rEDTii/EATWHAT/README.md

# EATWHAT

**基于 FreeRTOS 的嵌入式多媒体音频系统设计**

**Audio-player based on FM33FK5410 MCU &amp; FreeRTOS**

“复微杯”全国大学生电子设计大赛全国总决赛参赛作品

| 类别 | 描述 |
| :--- | :--- |
| **MCU** | 复旦微电子 FM33FK5410 (ARM Cortex-M33) |
| **RTOS** | FreeRTOS |
| **外设** | 3.5英寸电容触摸屏、双声道 I2S 麦克风/功放、SD 卡等 |
| **开发环境** | Keil uVision 5 |

## 项目源码相关目录：
 - *Driver*：包含有项目中所开发/移植的硬件底层驱动；
 - *Inc*：项目所包含的.h头文件；
 - *Middlewares*：涉及到中间件的移植和驱动适配；
 - *Src*：包含所有.c源文件，主要实现业务功能逻辑。

## 总决赛项目答辩相关材料：
 - *软硬件赛道硬件命题-晚饭吃什么-王政.pdf*：总决赛答辩演示文稿
 - *软硬件赛道硬件命题-晚饭吃什么-王政.mp4*：总决赛现场演示视频

## 项目介绍

项目来自“复微杯”2025全国大学生电子设计大赛选题 - 基于FM33XX系列MCU的多媒体音频终端系统，旨在为复旦微电子集团的全新 MCU 型号探索应用场景与实现方案。




图中硬件标注：①电容触摸LCD屏，集成显示+触摸检测；②功放模块；③扬声器；④麦克风模块；⑤SD卡存储模块；⑥外部flash存储模块；⑦RTC供电纽扣电池；⑧系统供电。当系统掉电时，将切换为使用纽扣电池为RTC时钟供电，以维持时钟走时。

### 核心功能

- **高保真音频处理**：支持 24-bit 采样深度，自适应采样率（8kHz - 32kHz），WAV 格式高保真录制与播放；
- **图形化交互系统**：基于 μGUI 移植优化的交互界面，支持电容触摸屏操作；
- **智能终端应用**：集成实时时钟、多功能闹钟、文件资源管理等终端功能；
- **大容量存储**：支持 SD 卡（FATFS 文件系统）与外部 Flash 存储，实现音频数据的高效持久化。

### 项目主要亮点

### 1. 高带宽音频流乒乓处理机制
SPI DMA + I2S DMA 的双 DMA + 双缓冲乒乓结构协作配合实现音频数据流的高效存取，支撑双声道多采样率 24-bit WAV 高清音频的录制/播放；SPI DMA 基于信号量实现，降低了CPU 占用，提高任务调度的实时性；




### 2. 自适应限幅滤波算法
基于前值保持的变化率约束的动态限幅，有效抑制突发瞬态噪声的同时保证了实时性，对缓解扬声器爆破音问题具有显著效果；



### 3. 任务调度与轻量级同步互斥设计
- 基于任务通知机制和中断实现触摸模块，通过任务通知值奇偶性判决触摸动作，实现高响应、低功耗的中断式触摸驱动；
- 针对录制/播放与突发闹钟之间的硬件资源竞态问题，设计了相应的业务切换逻辑，保证了文件完整性与系统实时稳定运行；

### 4. 文件管理与 GUI 显示优化
- 在 FATFS 的基础上引入动态链表机制，实时监听文件系统事件并同步文件变化，实现文件高效管理；
- 二次开发 μGUI 图形库，包括显示驱动优化、组件功能拓展、字库访问优化等，保证高效渲染与节省资源的同时提升用户友好性。

---
*Developed by Mason Wang, Pam Pan, and GaoPeng Cai from SCUT.*
