rEDTii/EATWHAT/软硬件赛道硬件命题-晚饭吃什么-王政.pdf

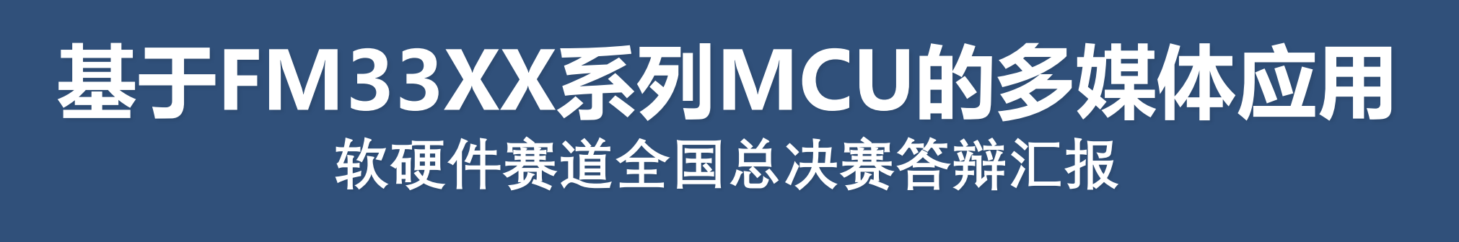
[picture p1: figure]
基于FM33XX系列MCU的多媒体应用; 软硬件赛道全国总决赛答辩汇报

2025.8.16

队伍名称： 晚饭吃什么
学校： 华南理工大学
队员： 王政 潘武豪 蔡高鹏

1 | 团队介绍 | 2 | 方案概述
3 | 关键技术实现 | 4 | 系统测试
5 | 总结与展望

# 01 团队介绍

### Part

## 团队介绍

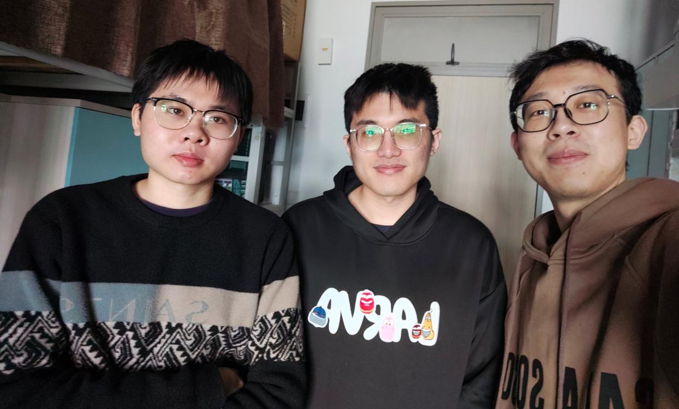
[picture p2: figure]

- 晚饭吃什么，来自华南理工大学电子与信息学院。所设计项目核心是基于FM33FK5410 MCU的多 媒体音频终端系统，实现高效音频处理与交互。
- 其中队长王政负责操作系统开发、驱动开发和功能开发；队员潘武豪负责文件管理、GUI开发和 功能开发；队员蔡高鹏负责PCB设计与硬件平台搭建。

图1-1 队伍合影，从左到右依次为：蔡高鹏，潘武豪，王政

# 02 方案概述

### Part

## 系统功能

- GUI交互

→ 支持触摸菜单控制与状态显示；

- WAV音频存取

→ 支持双声道多采样率24位量化位数的
WAV格式音频的录制、播放及过程暂停；
- SD卡存储

→ 音频文件通过FATFS文件系统存储在SD
卡，提供跨平台兼容性与可移动性；
- 时钟功能

→ 带软件合法性判断的日期/时间设置与动态显示；

- 闹钟功能

→ 支持用户自设闹钟与任务打断提醒；

- 辅助功能

→ 支持音量调节、亮度调节等辅助功能配置。

所设计的基于FM33FK5410 MCU的应用终端系统实现功能概括如下：

## 功能与模块架构

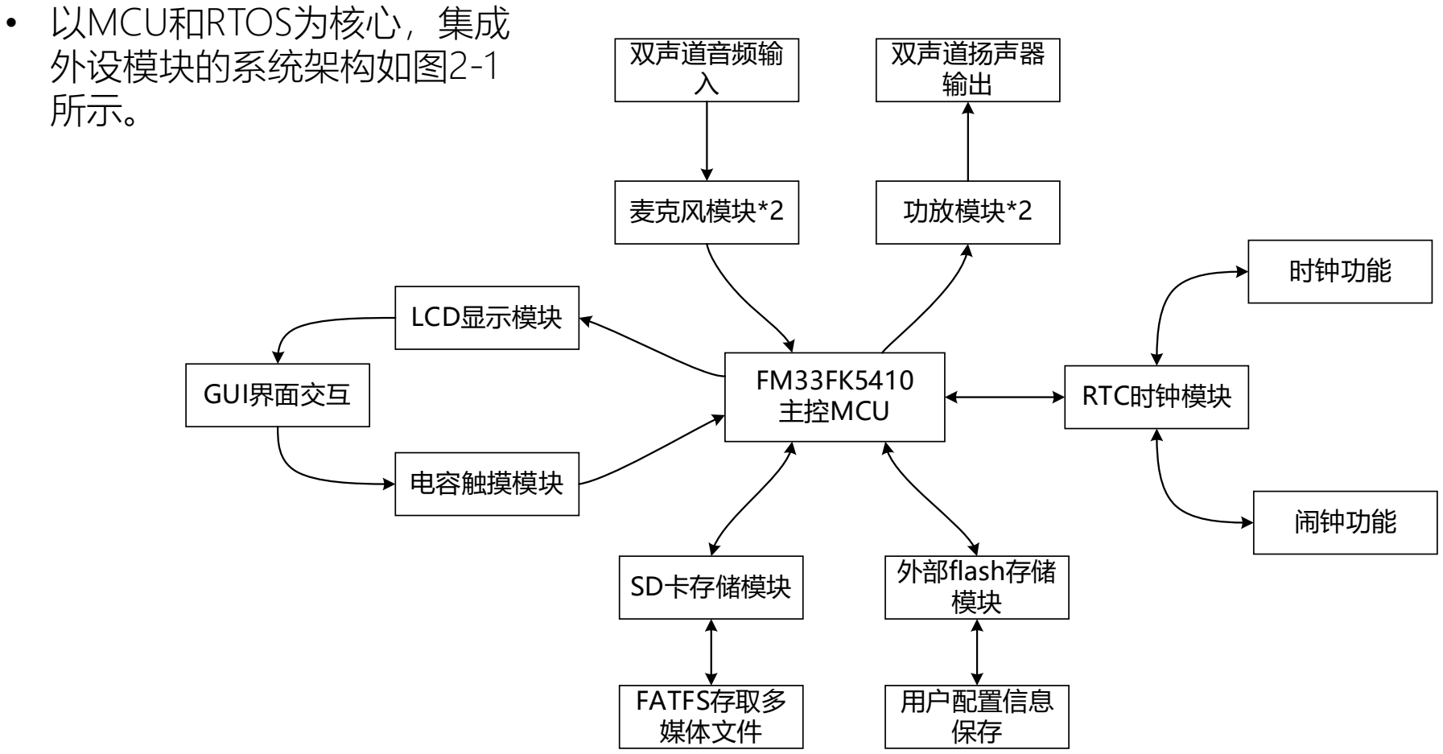
[picture p3: figure]
FM33FK5410 主控MCU; SD卡存储模块; 外部flash存储; FATFS存取多 媒体文件; LCD显示模块; 电容触摸模块; GUI界面交互; 用户配置信息 保存; RTC时钟模块; 时钟功能; 闹钟功能; 功放模块*2; 双声道扬声器 输出; 麦克风模块*2; 双声道音频输 入; • 以MCU和RTOS为核心，集成 外设模块的系统架构如图2-1 所示。

图2-1 系统功能模块架构

## 硬件连接 与实物图

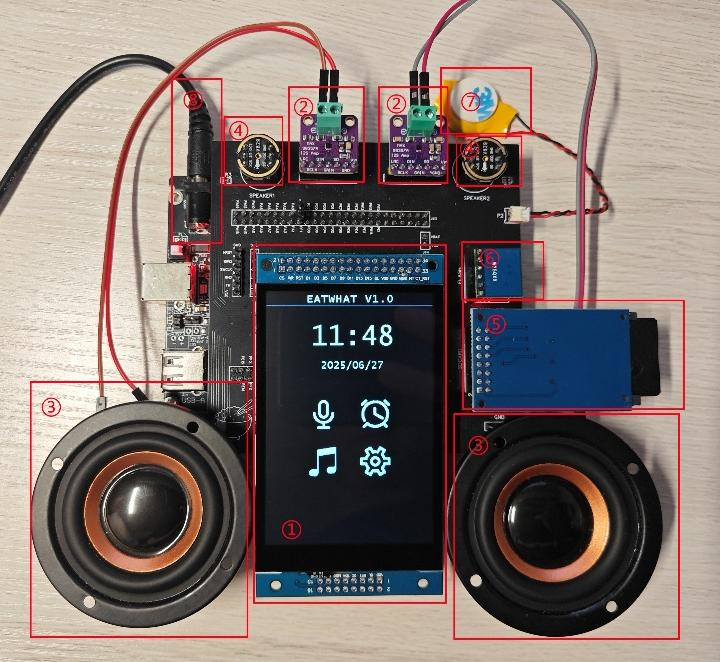
[picture p4: figure]

图2-3 标有各外设模块的实物示意图

FM33FK5410
MCU

外部FLASH

SPI3 | SD卡

SPI2

电源 | VDD
RTC电源 | VBAT
麦克风 | 音频放大器

喇叭

SPI0->I2S | SPI1->I2S
麦克风 | 音频放大器
左声道 | 喇叭 | 右声道

电容触摸显示屏

显示 | 触摸

I2C1

亮度

EPSC | PWM

图2-2 硬件连接图
- 双声道音频链路：
INMP441麦克风 24位I2S输入→ FM33FK5410 → MAX98357 D类功放输出；
- 双协议驱动电容屏：
Intel 8080并口 + I2C触摸 + PWM调光。

①电容触摸LCD屏；②功放；③扬声器；④麦克风；⑤SD卡存储 模块；⑥外部flash存储模块；⑦RTC供电纽扣电池；⑧系统供电

## PCB载板

- PCB设计遵循钝角走线并应用泪滴以增强连接可靠性的准则，降低信号反射；合理设计过孔围栏，抑制电 源噪声，为双DMA音频输入输出与存储模块读写的稳定性提供了硬件支持。PCB边框大小为10cm×10cm， 且设计符合DRC检测。

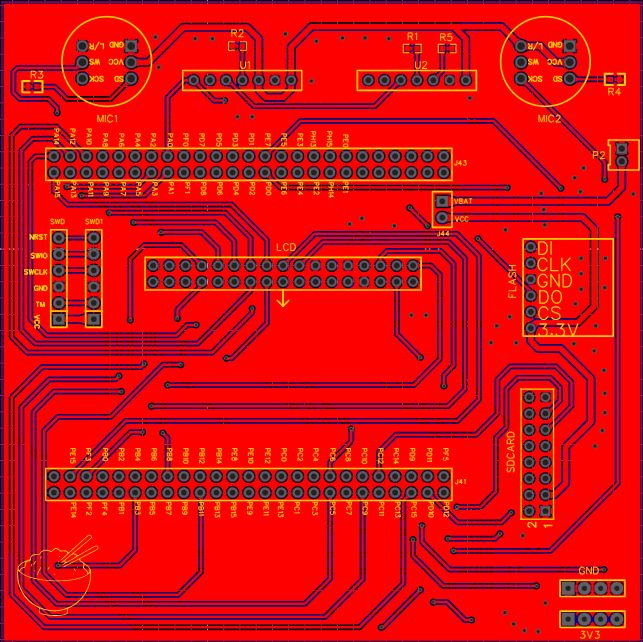
[picture p5: figure]
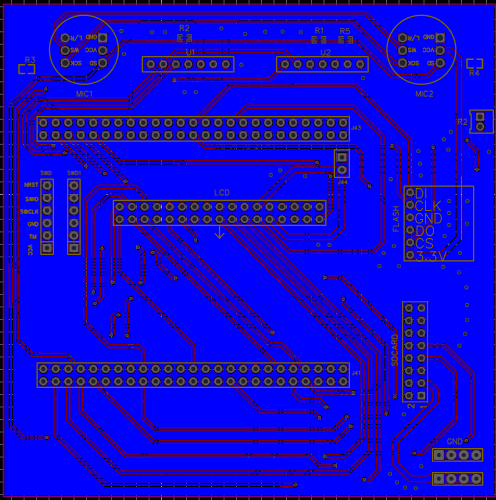
[picture p6: figure]

图2-4 硬件PCB顶层 | 图2-5 硬件PCB底层

## 关键点/创新点

RTOS多任务调度

→ 基于FreeRTOS进行多任务的管理和协调，通过精心配置细粒度任务的优先级设置、资源管 理和任务同步互斥等，实现和保证多任务高效调度、实时响应和稳定执行；

- 文件管理优化

→ 基于链表结构的内部文件管理，与FAT文件系统深度协同，增删管理高效，有利于动态内存 管理和不定长的文件名存储，降低内存碎片化风险；

图形库二次开发与资源优化

→ 对µGUI进行二次开发，针对大面积填充的显示驱动优化，提升渲染速度；对其部分控件进 行功能拓展，提升用户友好性；字库访问优化，保证字体高效渲染同时节省资源。

## 关键点/创新点

基于任务同步的双DMA音频流IO优化

→ SPI DMA+I2S DMA的双DMA+双缓冲乒乓结构协作配合实现音频数据流的高效存取，提

高了传输速率；其中SPI DMA基于信号量实现，降低了CPU占用，提高任务调度的实时性；

- 自适应瞬态抑制音频流滤波

→ 基于前值保持的变化率约束的动态限幅，有效抑制突发瞬态噪声的同时保证了实时性，对 缓解扬声器爆破音问题具有显著效果；

- 基于轻量级任务同步的中断触摸驱动框架

→ 中断+任务处理的触摸模式，提高实时性和稳定性，降低CPU占用；基于任务通知值奇偶 进行触摸动作判决，轻量且安全；

# 03 关键技术实现

### Part

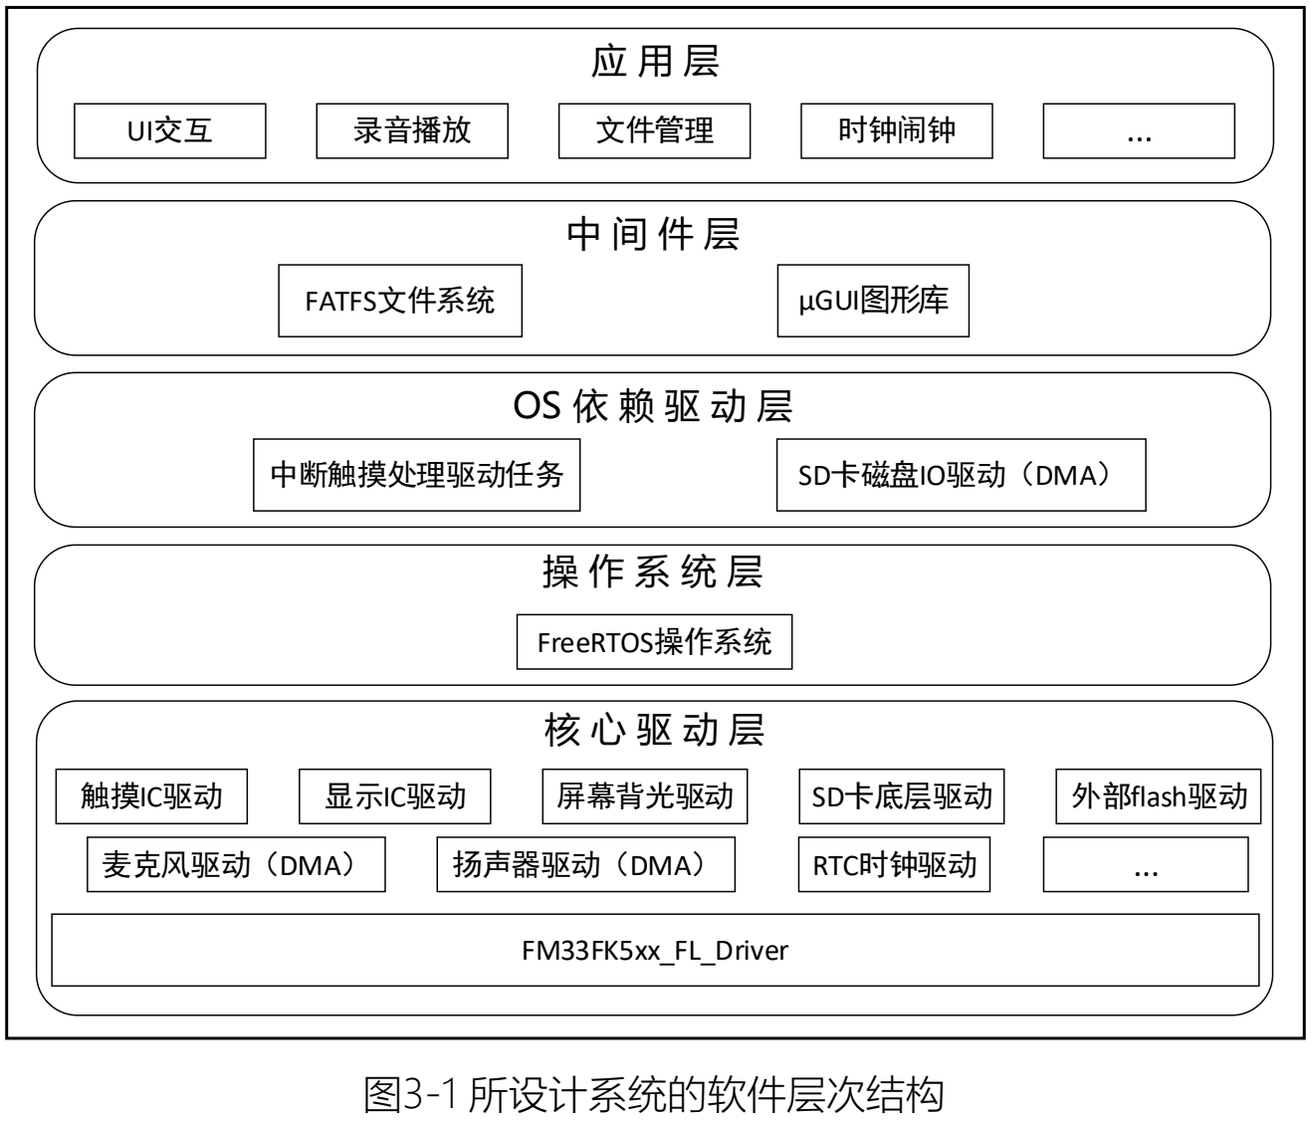
[picture p7: figure]
FATFS文件系统; μGUI图形库; FM33FK5xx_FL_Driver; 触摸IC驱动; 显示IC驱动; 麦克风驱动（DMA）; 扬声器驱动（DMA）; RTC时钟驱动; 屏幕背光驱动; 外部flash驱动; SD卡底层驱动; 中断触摸处理驱动任务; FreeRTOS操作系统; SD卡磁盘IO驱动（DMA）; UI交互; 录音播放; 文件管理; 时钟闹钟; ... 图3-1 所设计系统的软件层次结构

## 软 件 层 次 结 构

- 项目设计遵循低耦合、模块化和
嵌入式软件分层的思想；
- 各层间与各模块间只对外提供操
作接口以及传递任务同步互斥量，
易于维护和拓展。

## OS依赖驱动层-SD卡DMA磁盘IO驱动优化

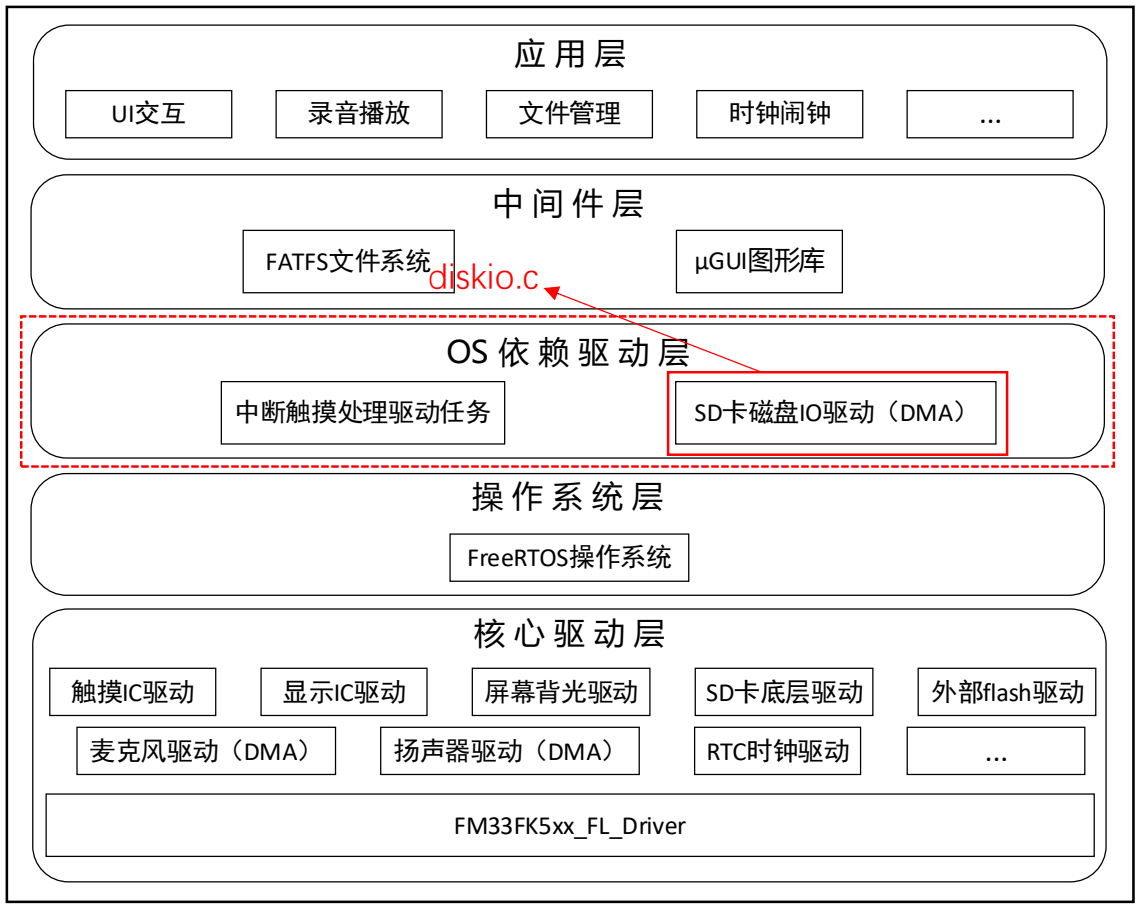
[picture p8: figure]
FATFS文件系统; μGUI图形库; FM33FK5xx_FL_Driver; 触摸IC驱动; 显示IC驱动; 麦克风驱动（DMA）; 扬声器驱动（DMA）; RTC时钟驱动; 屏幕背光驱动; 外部flash驱动; SD卡底层驱动; 中断触摸处理驱动任务; FreeRTOS操作系统; SD卡磁盘IO驱动（DMA）; UI交互; 录音播放; 文件管理; 时钟闹钟; diskio.c

图3-2 SD卡读写驱动优化

问题痛点

- 传统SPI读写SD卡速率难以匹配I2S音频流速率；
- 传统DMA方案的while轮询忙等待抢占CPU资源， 阻塞任务调度；

## OS依赖驱动层-SD卡DMA磁盘IO驱动优化

问题痛点

- 传统SPI读写SD卡速率难以匹配I2S音频流速率；
- 传统DMA方案的while轮询忙等待抢占CPU资源， 阻塞任务调度；

应对方案

- 在硬件上，以SPI DMA传输替代CPU搬运，进一 步构建双缓冲音频传输结构，保障音频流传输；
- 在系统上，采用信号量同步替代DMA忙等待，降
低CPU占用；

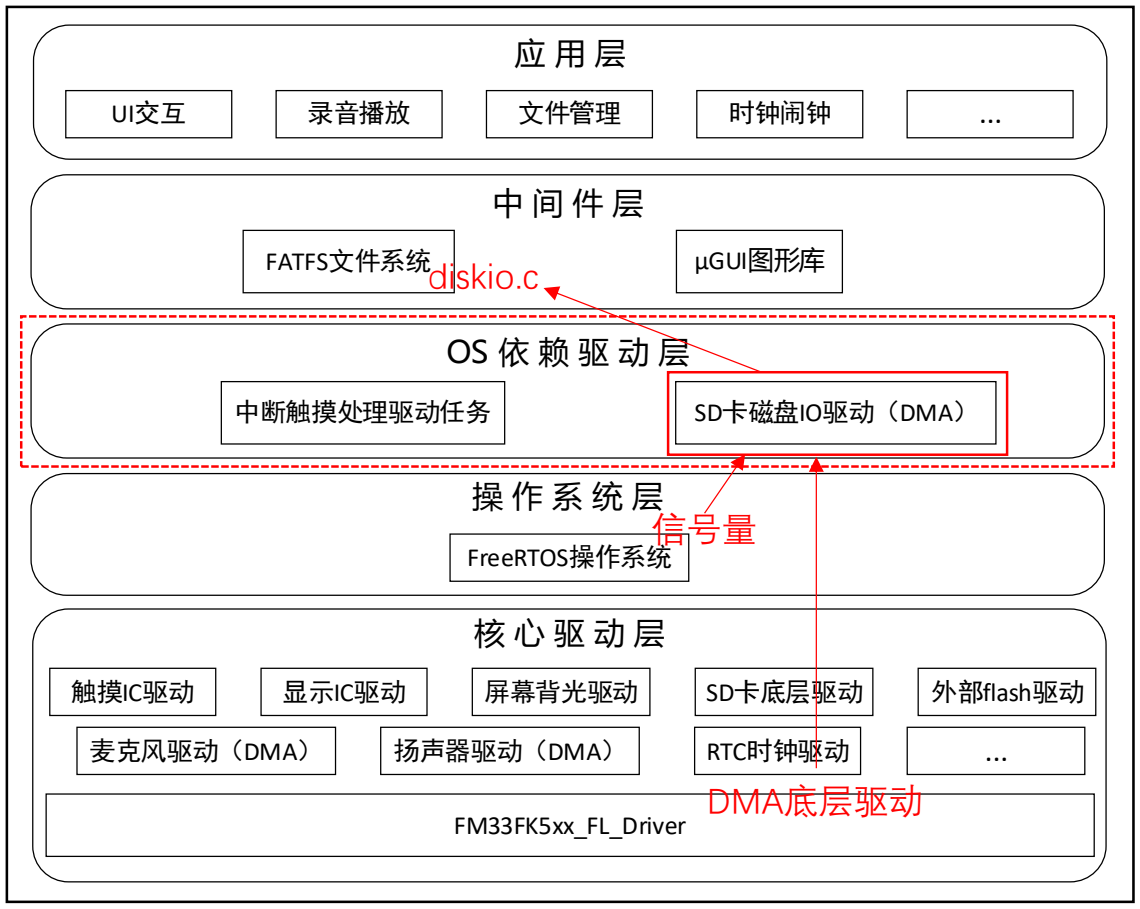
[picture p9: figure]
FATFS文件系统; μGUI图形库; FM33FK5xx_FL_Driver; 触摸IC驱动; 显示IC驱动; 麦克风驱动（DMA）; 扬声器驱动（DMA）; RTC时钟驱动; 屏幕背光驱动; 外部flash驱动; SD卡底层驱动; 中断触摸处理驱动任务; FreeRTOS操作系统; SD卡磁盘IO驱动（DMA）; UI交互; 录音播放; 文件管理; 时钟闹钟; diskio.c; 信号量; DMA底层驱动

图3-2 SD卡读写驱动优化

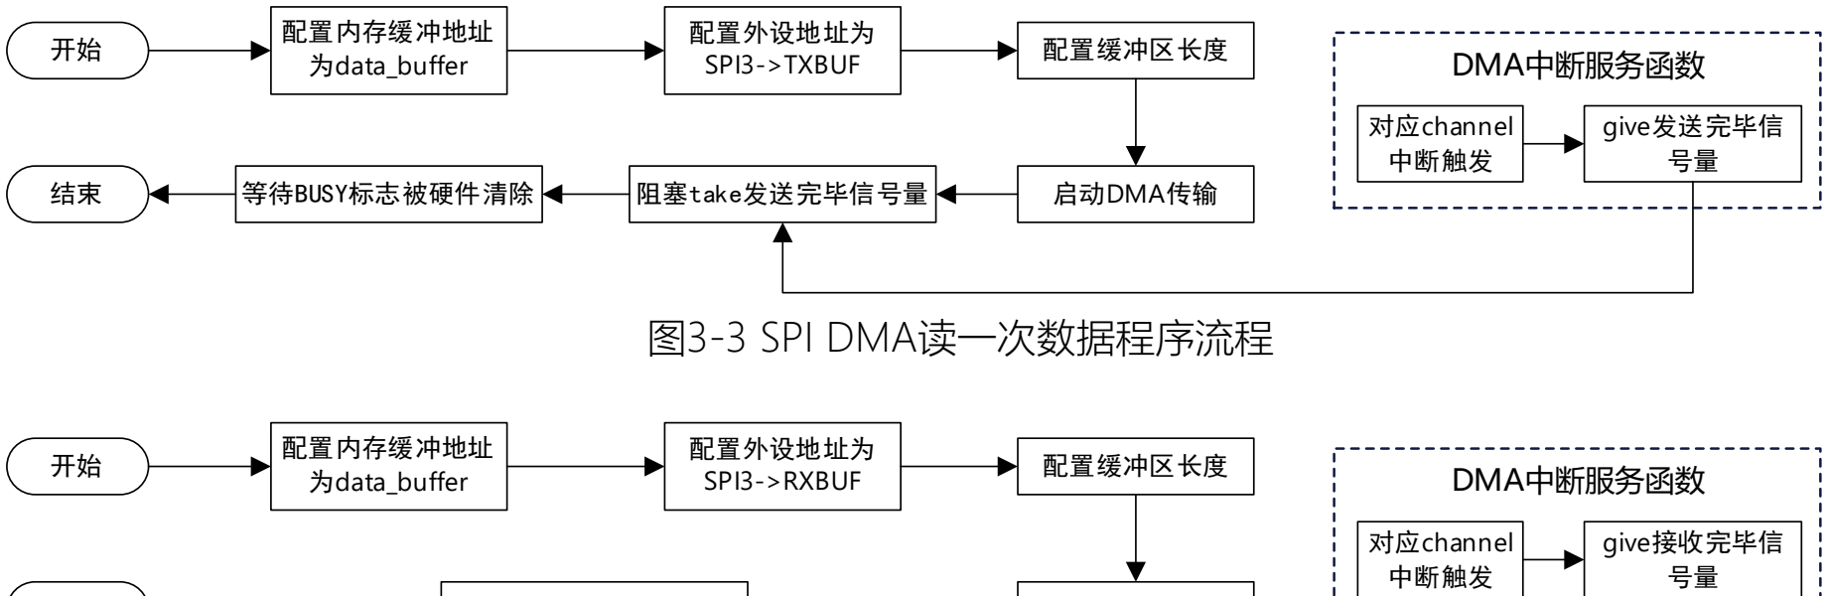
[picture p10: figure]
图3-3 SPI DMA读一次数据程序流程; 配置内存缓冲地址; 为data_buffer; 配置缓冲区长度; 配置外设地址为 SPI3->TXBUF; 等待BUSY标志被硬件清除; 阻塞take发送完毕信号量; 启动DMA传输; 对应channel 中断触发; give发送完毕信 号量; DMA中断服务函数 开始; 配置外设地址为 SPI3->RXBUF; give接收完毕信 号量; DMA中断服务函数
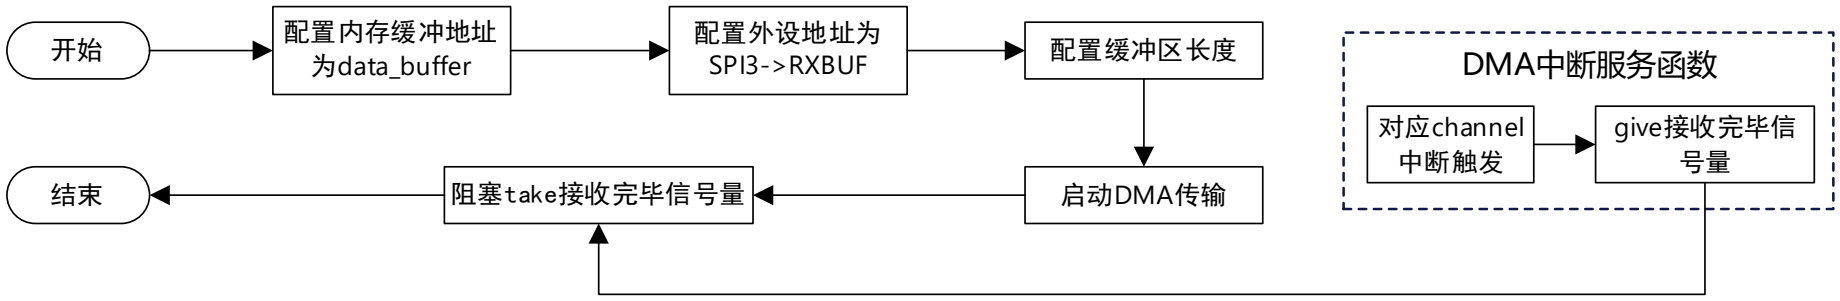
[picture p11: figure]
阻塞take接收完毕信号量; 启动DMA传输

图3-4 SPI DMA写一次数据程序流程

## OS依赖驱动层-SD卡DMA磁盘IO驱动优化

## OS依赖驱动层-SD卡DMA磁盘IO驱动优化

优化前后SPI磁盘IO速率的评估测试实验
- 为了评估我们经过任务同步优化磁盘IO驱动后的文件系统的读写速率提升效果，我们设计了三个评 估实验。

时钟频率 (MHz) | 数据大小 (KB) | 写入次数 | 速率 (KB/s)
8 | 3 | 1 | 45.5
32 | 3 | 1 | 157.9
32 | 3 | 10 | 144.3
32 | 3 | 100 | 144.9
32 | 4.5 | 100 | 154.9
32 | 6 | 100 | 165.2
32 | 7.5 | 100 | 167.4

## OS依赖驱动层-SD卡DMA磁盘IO驱动优化

时钟频率 (MHz) | 数据大小 (KB) | 读取次数 | 速率 (KB/s)
32 | 3 | 1 | 1500.0
32 | 3 | 10 | 1034.5
32 | 3 | 100 | 1010.1

表3-1 不使用DMA的SPI写入

表3-2 DMA优化后的SPI写入

表3-3 DMA优化后的32MHz下3KB缓冲区的SPI读取

时钟频率 (MHz) | 数据大小 (KB) | 写入次数 | 速率 (KB/s)
8 | 3 | 1 | 230.8
32 | 3 | 1 | 600.0
32 | 3 | 10 | 392.8
32 | 3 | 100 | 405.4
32 | 4.5 | 100 | 516.8
32 | 6 | 100 | 630.0
32 | 7.5 | 100 | 669.4

优化前后SPI磁盘IO速率的评估测试实验
- 为了评估我们经过任务同步优化磁盘IO驱动后的文件系统的读写速率提升效果，我们设计了三个评 估实验。

## OS依赖驱动层-SD卡DMA磁盘IO驱动优化

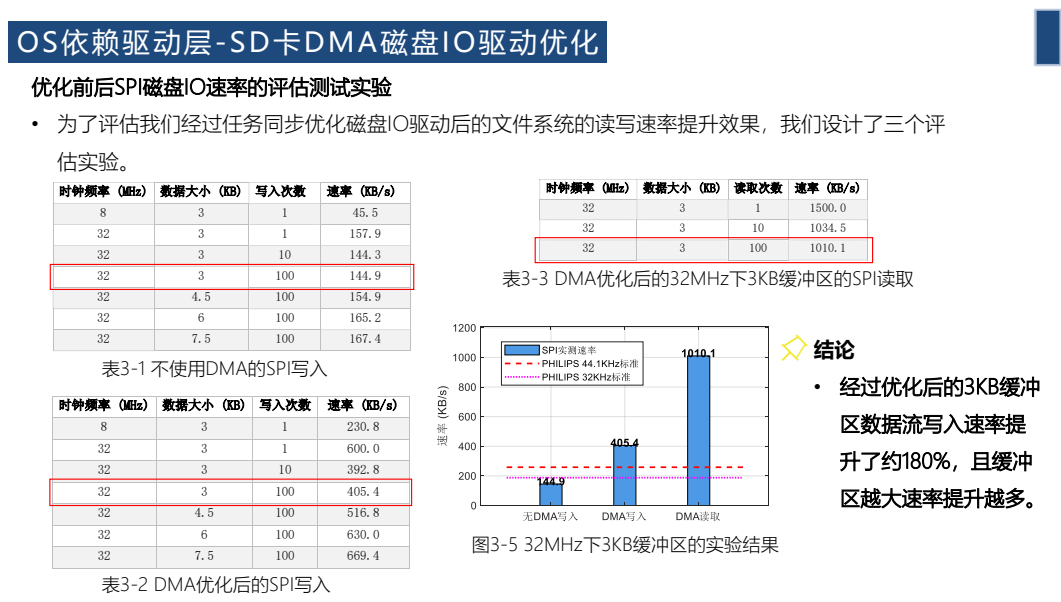
[picture p12: page 19]
时钟频率 (MHz); 数据大小 (KB); 写入次数; 读取次数; 表3-1 不使用DMA的SPI写入; 表3-2 DMA优化后的SPI写入; 表3-3 DMA优化后的32MHz下3KB缓冲区的SPI读取; • 经过优化后的3KB缓冲; 区数据流写入速率提; 升了约180%，且缓冲; 区越大速率提升越多。; 图3-5 32MHz下3KB缓冲区的实验结果; 优化前后SPI磁盘IO速率的评估测试实验; • 为了评估我们经过任务同步优化磁盘IO驱动后的文件系统的读写速率提升效果，我们设计了三个评; 估实验。

8 | 3 | 1 | 45.5
32 | 3 | 1 | 157.9
32 | 3 | 10 | 144.3
32 | 3 | 100 | 144.9
32 | 4.5 | 100 | 154.9
32 | 6 | 100 | 165.2
32 | 7.5 | 100 | 167.4

32 | 3 | 1 | 1500.0
32 | 3 | 10 | 1034.5
32 | 3 | 100 | 1010.1

时钟频率 (MHz) | 数据大小 (KB) | 写入次数 | 速率 (KB/s)

8 | 3 | 1 | 230.8
32 | 3 | 1 | 600.0
32 | 3 | 10 | 392.8
32 | 3 | 100 | 405.4
32 | 4.5 | 100 | 516.8
32 | 6 | 100 | 630.0
32 | 7.5 | 100 | 669.4

## OS依赖驱动层-中断触摸优化驱动

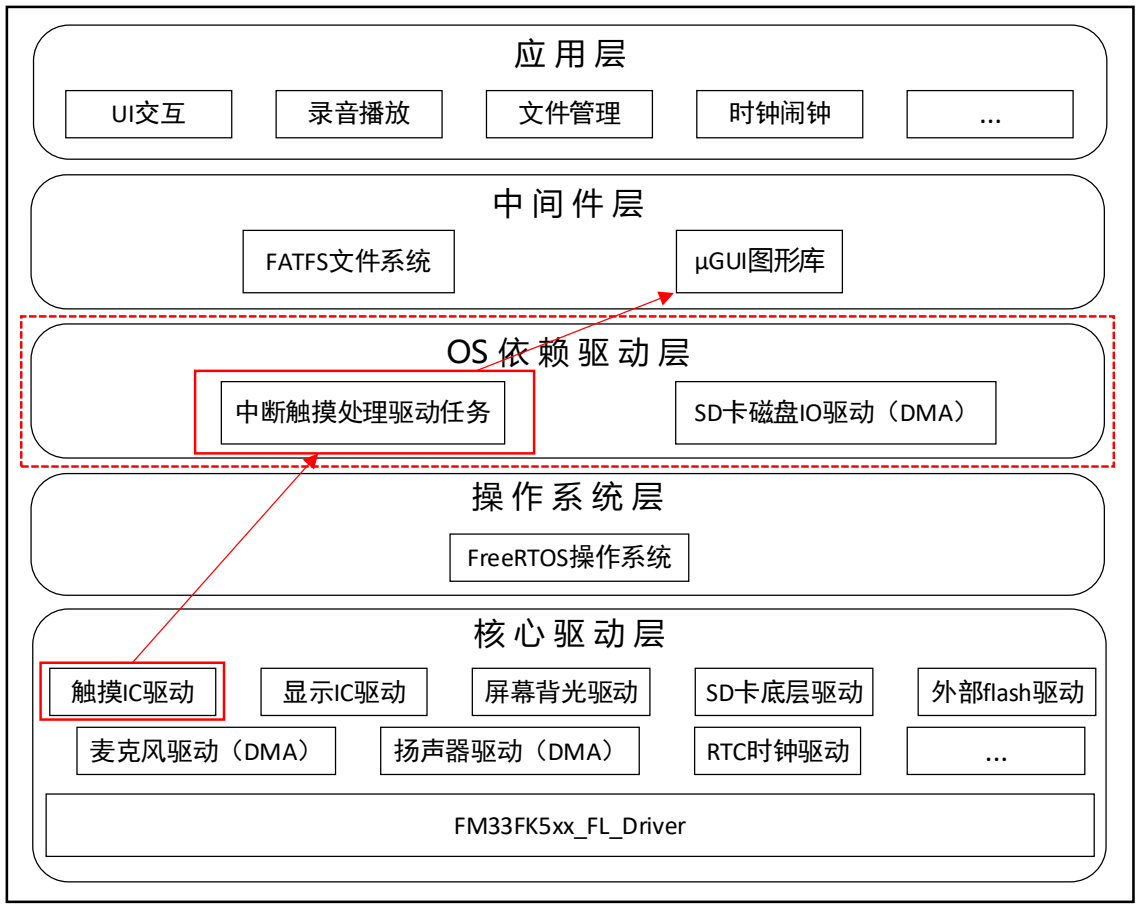
[picture p13: figure]
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

图3-6 中断触摸驱动优化

问题痛点

- 传统轮询模式持续占用CPU资源，实时性差；
- GT911实际中断触发逻辑与数据手册不符；
- 传统中断模式有多任务冲突风险。

## OS依赖驱动层-中断触摸优化驱动

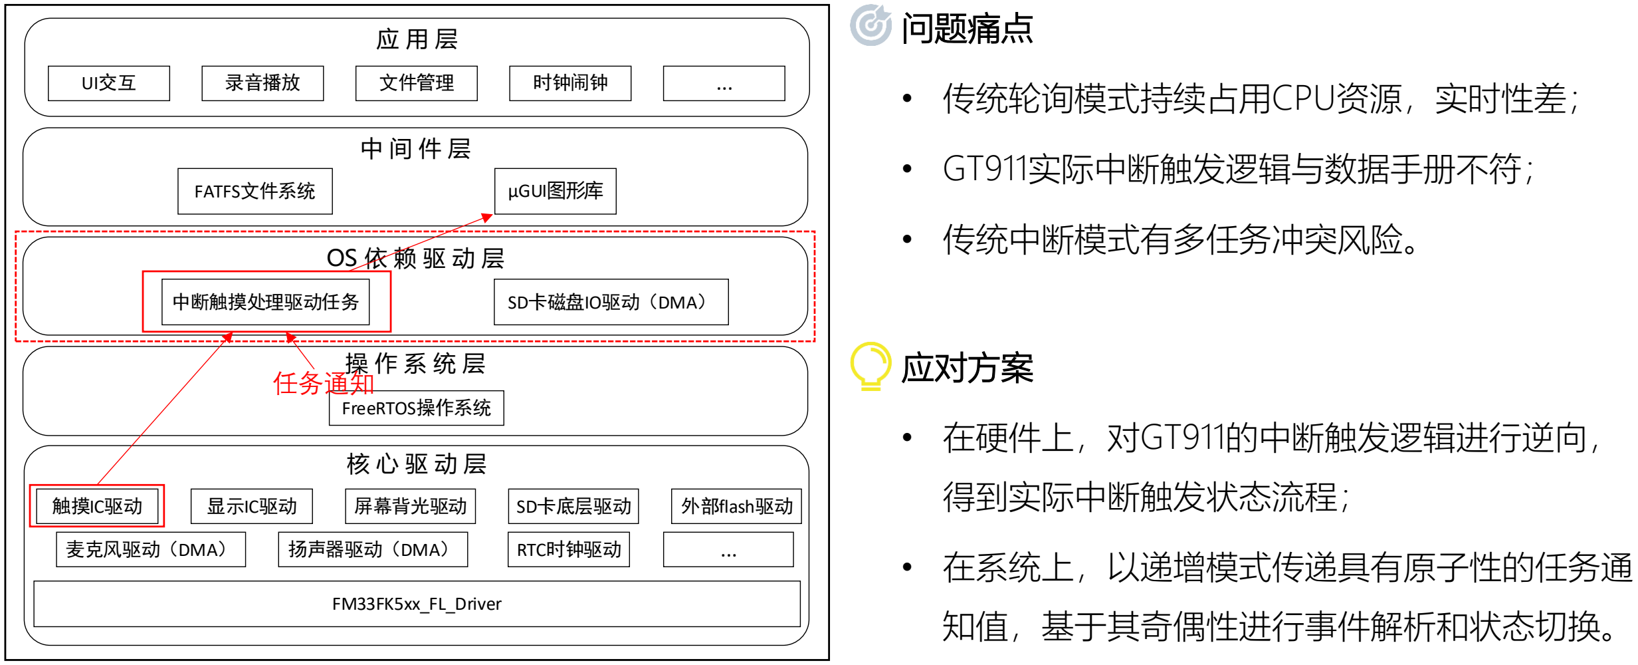
[picture p14: figure]
问题痛点; • 传统轮询模式持续占用CPU资源，实时性差；; • GT911实际中断触发逻辑与数据手册不符；; • 传统中断模式有多任务冲突风险。; FATFS文件系统; μGUI图形库; FM33FK5xx_FL_Driver; 触摸IC驱动; 显示IC驱动; 麦克风驱动（DMA）; 扬声器驱动（DMA）; RTC时钟驱动; 屏幕背光驱动; 外部flash驱动; SD卡底层驱动; 中断触摸处理驱动任务; FreeRTOS操作系统; SD卡磁盘IO驱动（DMA）; UI交互; 录音播放; 文件管理; 时钟闹钟; 任务通知; 应对方案; • 在硬件上，对GT911的中断触发逻辑进行逆向，; 得到实际中断触发状态流程；; • 在系统上，以递增模式传递具有原子性的任务通; 知值，基于其奇偶性进行事件解析和状态切换。

图3-6 中断触摸驱动优化

## OS依赖驱动层-中断触摸优化驱动

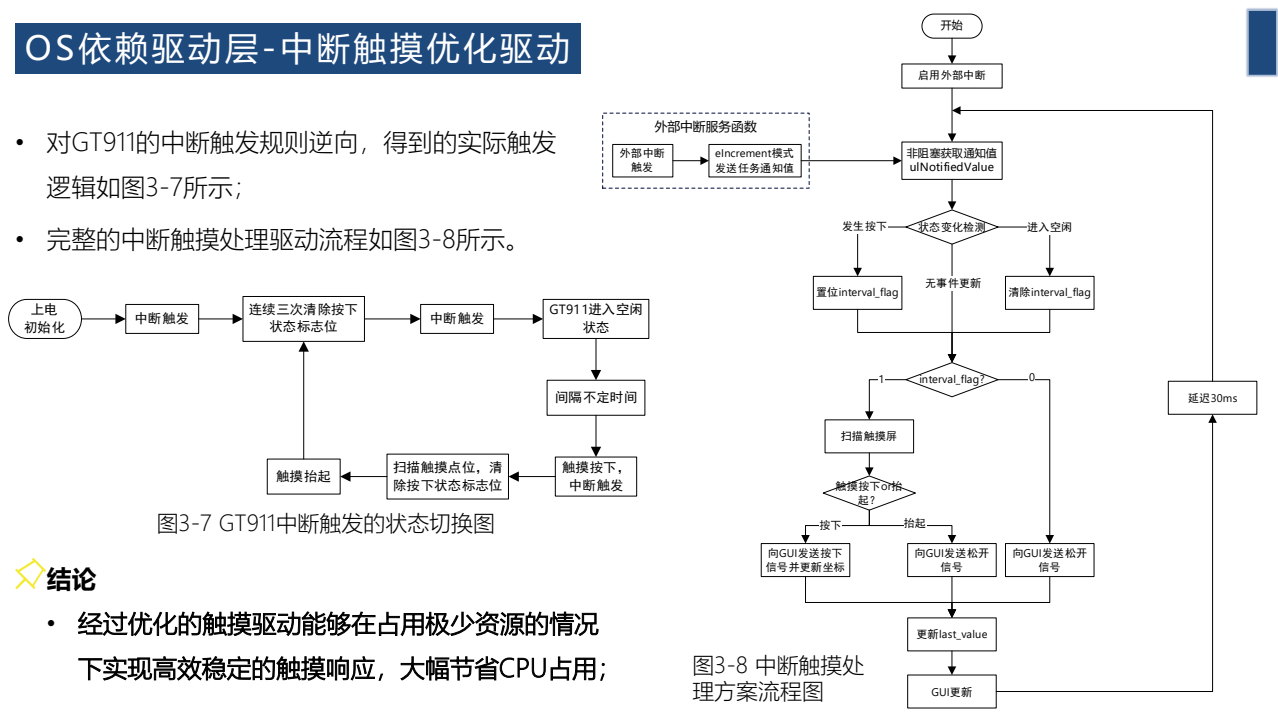
[picture p15: page 22]
上电 初始化; 连续三次清除按下; 状态标志位 中断触发; GT911进入空闲; 状态 中断触发; 触摸按下， 中断触发; 扫描触摸点位，清 除按下状态标志位 触摸抬起; 间隔不定时间; 外部中断 触发; eIncrement模式 发送任务通知值; 外部中断服务函数; 非阻塞获取通知值 ulNotifiedValue; 置位interval_flag; 进入空闲; 清除interval_flag; 启用外部中断; 发生按下; 状态变化检测; 无事件更新; interval_flag?; 扫描触摸屏; 向GUI发送松开 信号; 触摸按下or抬 起？; 向GUI发送按下 信号并更新坐标; 更新last_value; GUI更新; 图3-8 中断触摸处 理方案流程图; • 经过优化的触摸驱动能够在占用极少资源的情况; 下实现高效稳定的触摸响应，大幅节省CPU占用；; • 对GT911的中断触发规则逆向，得到的实际触发; 逻辑如图3-7所示；; • 完整的中断触摸处理驱动流程如图3-8所示。; 图3-7 GT911中断触发的状态切换图

## 中间件层 - µ G U I 二次开发

问题痛点

- 移植其他中间件后，片上资源紧张；
- µGUI 默认渲染方式低效，且兼容性较差；
- µGUI 功能局限，如只针对按钮提供了触摸点击
功能；
- 字库占用大量片内flash，且字库遍历访问机制
效率不高，拖慢刷新速率；

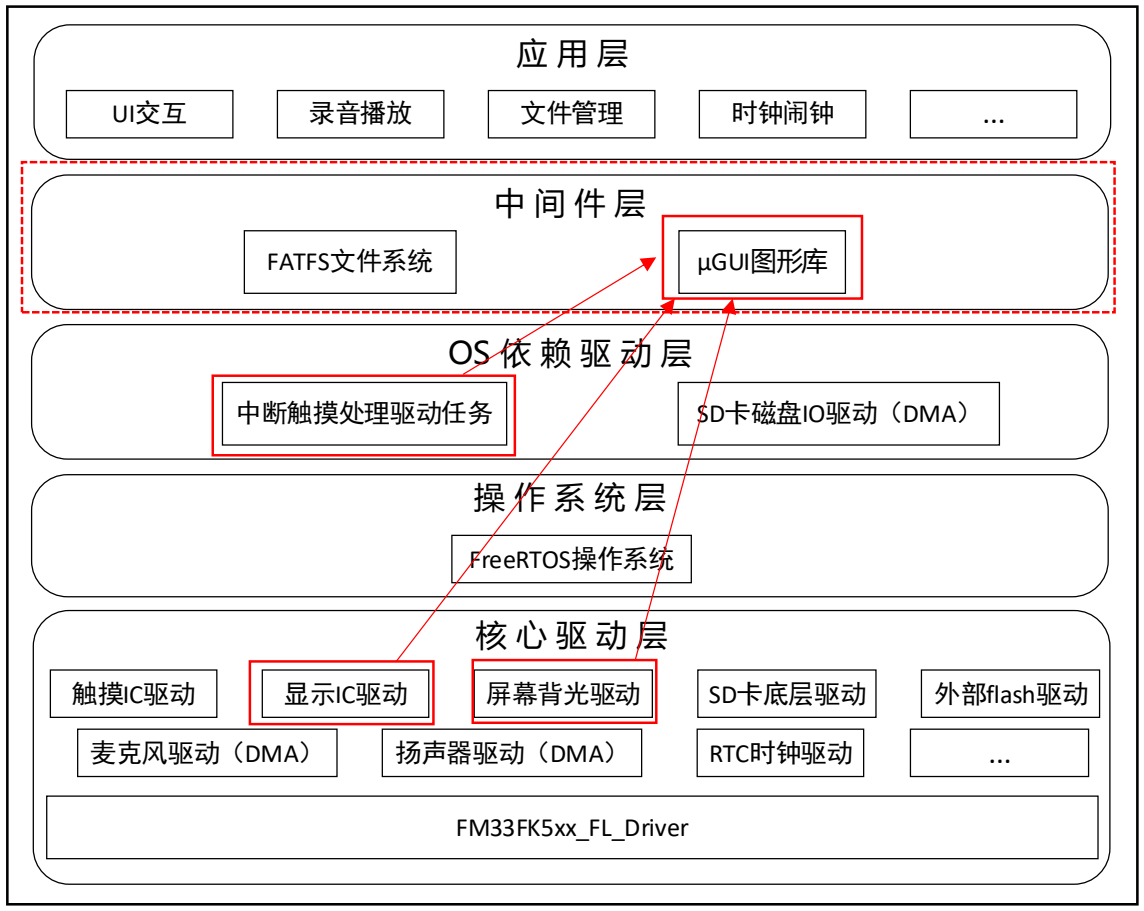
[picture p16: figure]
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

图3-9 µGUI二次开发

## 中间件层 - µ G U I 二次开发

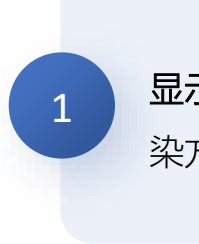
[picture p17: figure]

显示驱动与兼容优化：结合显示芯片ST7796U接口，基于窗口填充函数优化µGUI图形渲 染方式，缩短刷新时间；配置显示驱动支持RGB565颜色格式，适配显示驱动芯片。

µGUI：超轻量的
开源用户界面图
形库

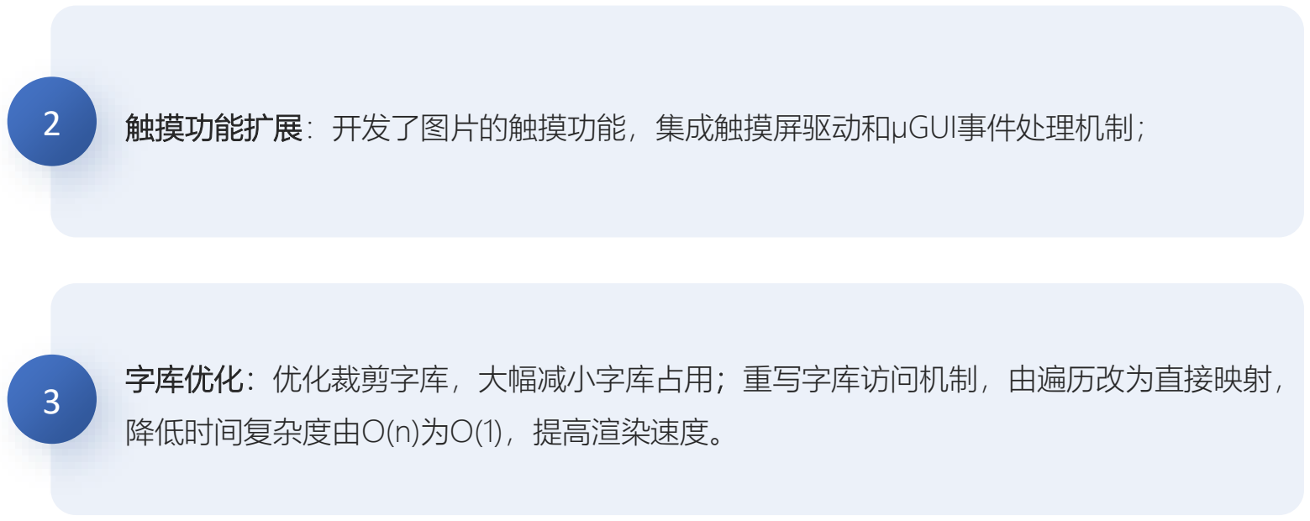
[picture p18: figure]
触摸功能扩展：开发了图片的触摸功能，集成触摸屏驱动和µGUI事件处理机制；; 字库优化：优化裁剪字库，大幅减小字库占用；重写字库访问机制，由遍历改为直接映射，; 降低时间复杂度由O(n)为O(1)，提高渲染速度。

核心优势：资源开销少（RAM占用只有数KB），CPU占用率低、功耗低等。

µGUI图形库及二次开发和优化

## 应用层 - 文件管理

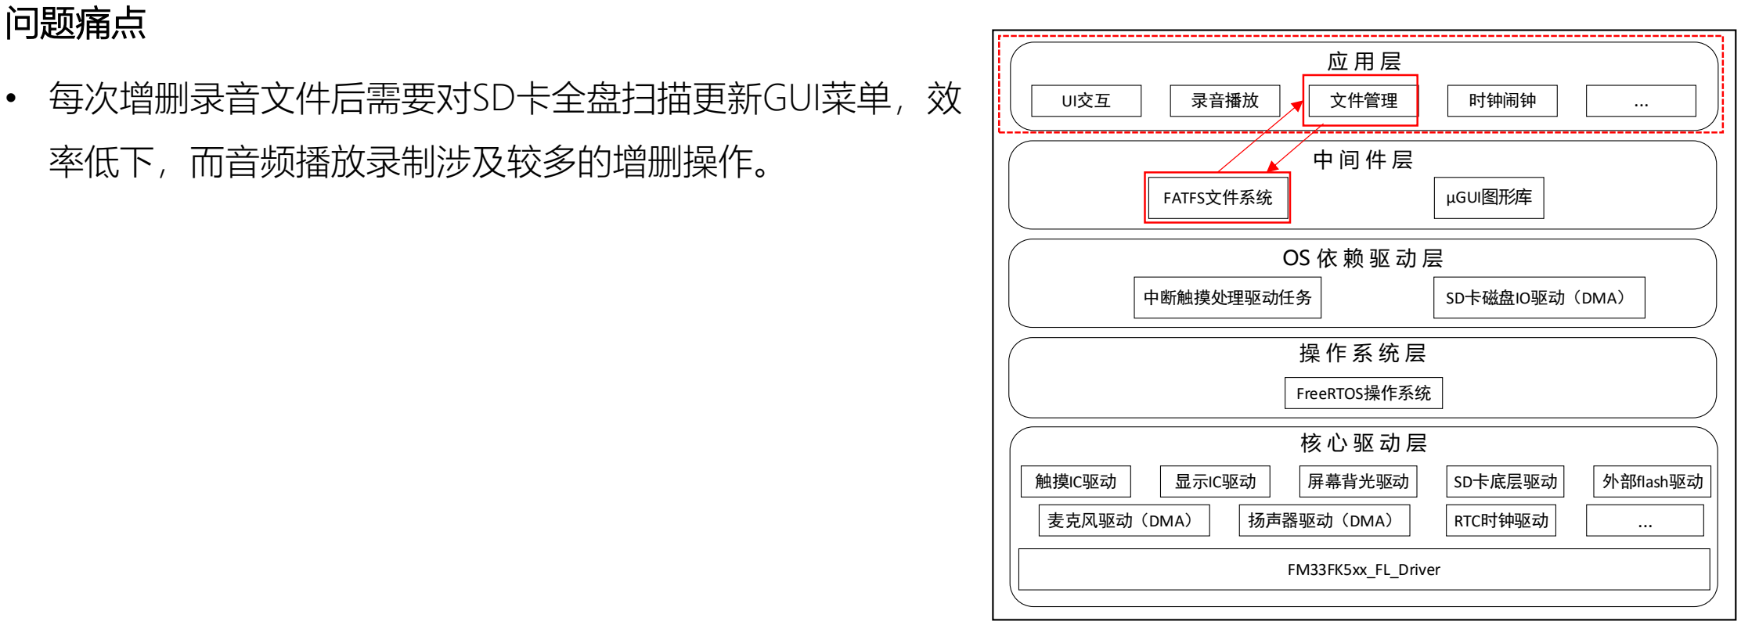
[picture p19: figure]
问题痛点; • 每次增删录音文件后需要对SD卡全盘扫描更新GUI菜单，效; 率低下，而音频播放录制涉及较多的增删操作。; FATFS文件系统; μGUI图形库; FM33FK5xx_FL_Driver; 触摸IC驱动; 显示IC驱动; 麦克风驱动（DMA）; 扬声器驱动（DMA）; RTC时钟驱动; 屏幕背光驱动; 外部flash驱动; SD卡底层驱动; 中断触摸处理驱动任务; FreeRTOS操作系统; SD卡磁盘IO驱动（DMA）; UI交互; 录音播放; 文件管理; 时钟闹钟

图3-11 文件管理

## 应用层 - 文件管理

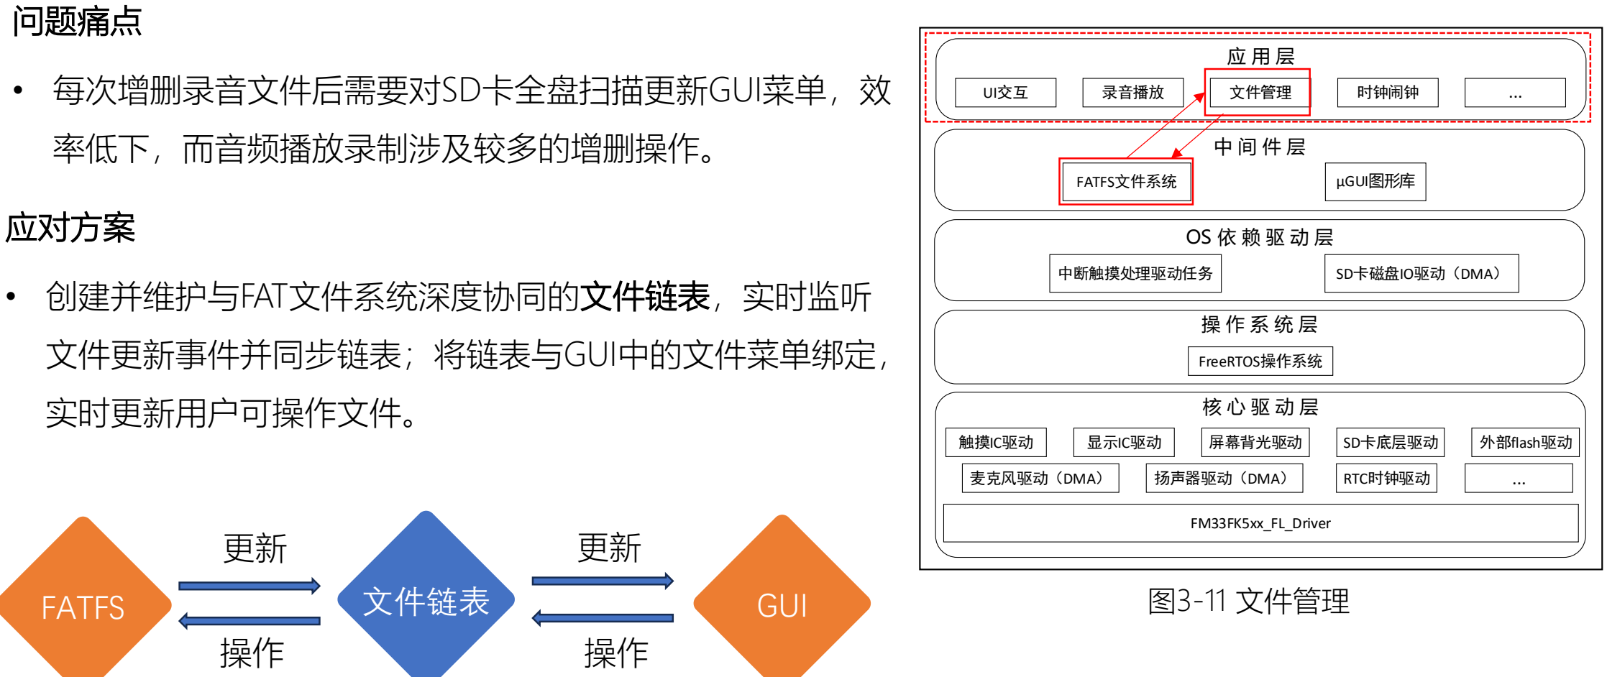
[picture p20: figure]
应对方案; • 创建并维护与FAT文件系统深度协同的文件链表，实时监听; 文件更新事件并同步链表；将链表与GUI中的文件菜单绑定，; 实时更新用户可操作文件。; FATFS; 文件链表; GUI; FATFS文件系统; μGUI图形库; FM33FK5xx_FL_Driver; 触摸IC驱动; 显示IC驱动; 麦克风驱动（DMA）; 扬声器驱动（DMA）; RTC时钟驱动; 屏幕背光驱动; 外部flash驱动; SD卡底层驱动; 中断触摸处理驱动任务; FreeRTOS操作系统; SD卡磁盘IO驱动（DMA）; UI交互; 录音播放; 文件管理; 时钟闹钟; 图3-11 文件管理; 问题痛点; • 每次增删录音文件后需要对SD卡全盘扫描更新GUI菜单，效; 率低下，而音频播放录制涉及较多的增删操作。
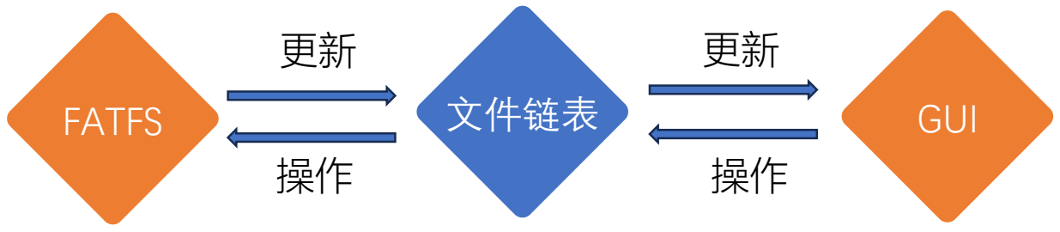
[picture p21: figure]

## 应用层 - 文件管理

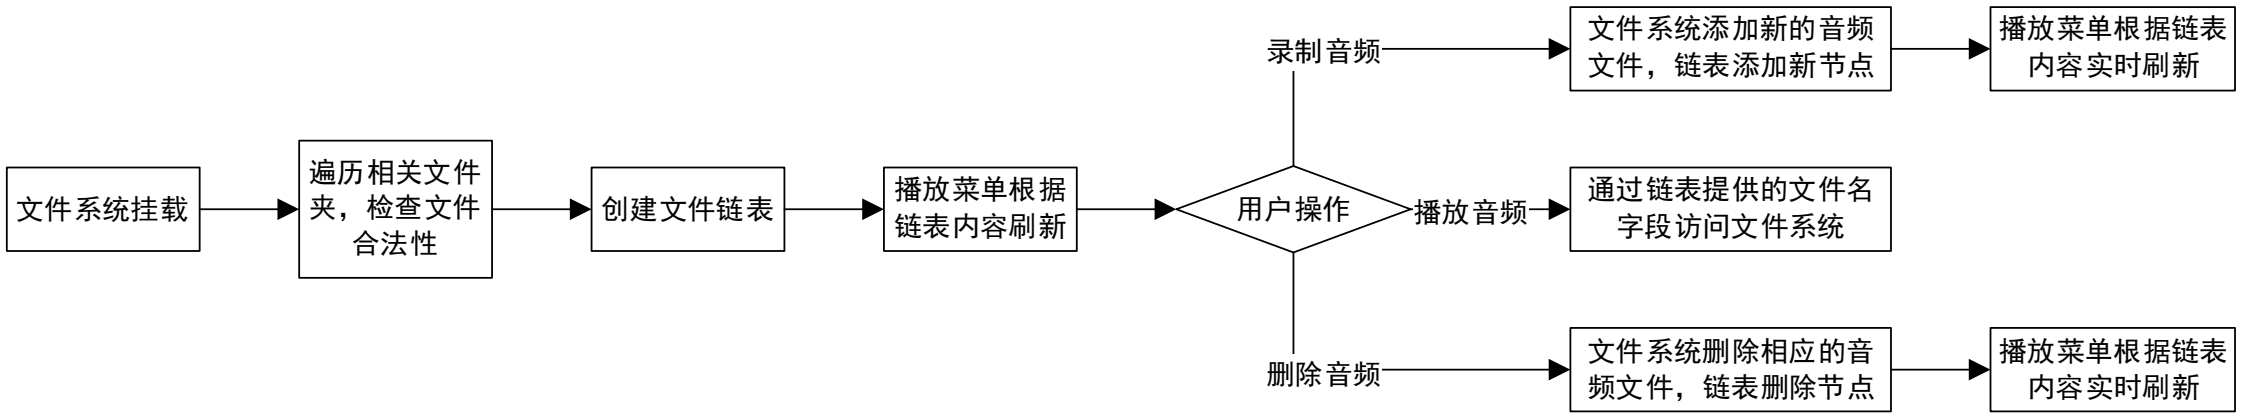
[picture p22: figure]
文件系统挂载; 遍历相关文件 夹，检查文件 合法性; 创建文件链表; 播放菜单根据; 链表内容刷新; 文件系统添加新的音频 文件，链表添加新节点; 播放菜单根据链表 内容实时刷新; 用户操作; 通过链表提供的文件名; 字段访问文件系统; 文件系统删除相应的音 频文件，链表删除节点; 录制音频; 删除音频; 播放音频

对于每次系统重新启动后的每次录音和删除操作，只需要对该链表进行维护即可，避免了每次增删文件后 对SD卡的全盘扫描，大大提高了管理效率和实时响应速度，降低了资源占用。

链表方案的优势：动态内存管理，扩展方便，无扩容开销；增删高效，时间复杂度只有O(1) 。

图3-12 链表进行文件管理的流程

## 应用层 - 音频录制 / 播放

问题痛点

- I2S音频外设与SPI读写SD卡的协调配合问题；
- 录播启停基本核心功能的流畅稳定实现，以及与其
他功能（如闹钟）间的有序协调调度；
- 瞬态噪声的存在导致尖锐爆破音，降低用户听感。

## 应用层 - 音频录制 / 播放

问题痛点

- I2S音频外设与SPI读写SD卡的协调配合问题；
- 录播启停基本核心功能的流畅稳定实现，以及与其
他功能（如闹钟）间的有序协调调度；
- 瞬态噪声的存在导致尖锐爆破音，降低用户听感。

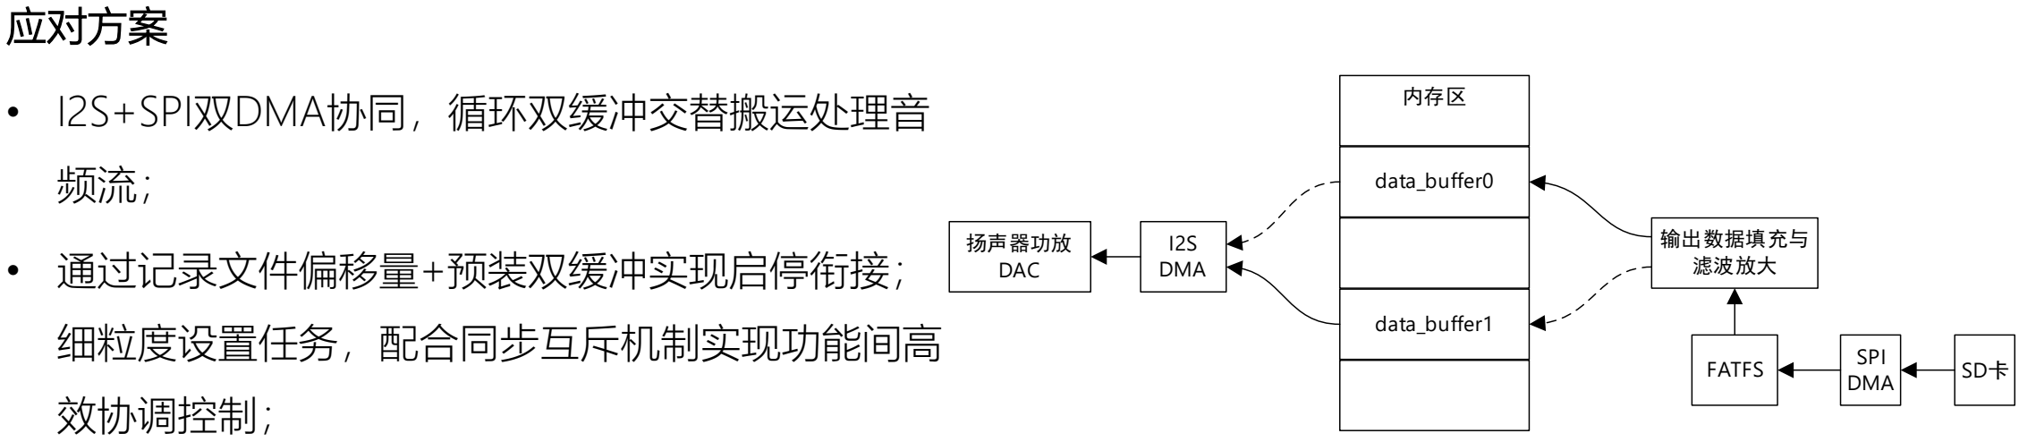
[picture p23: figure]
应对方案; • I2S+SPI双DMA协同，循环双缓冲交替搬运处理音; • 通过记录文件偏移量+预装双缓冲实现启停衔接；; 细粒度设置任务，配合同步互斥机制实现功能间高; 效协调控制；; data_buffer1; data_buffer0; I2S DMA; 输出数据填充与 滤波放大; SPI; DMA FATFS; SD卡; 内存区; 扬声器功放; DAC

- 设计自适应限幅音频滤波算法缓解爆破音问题。

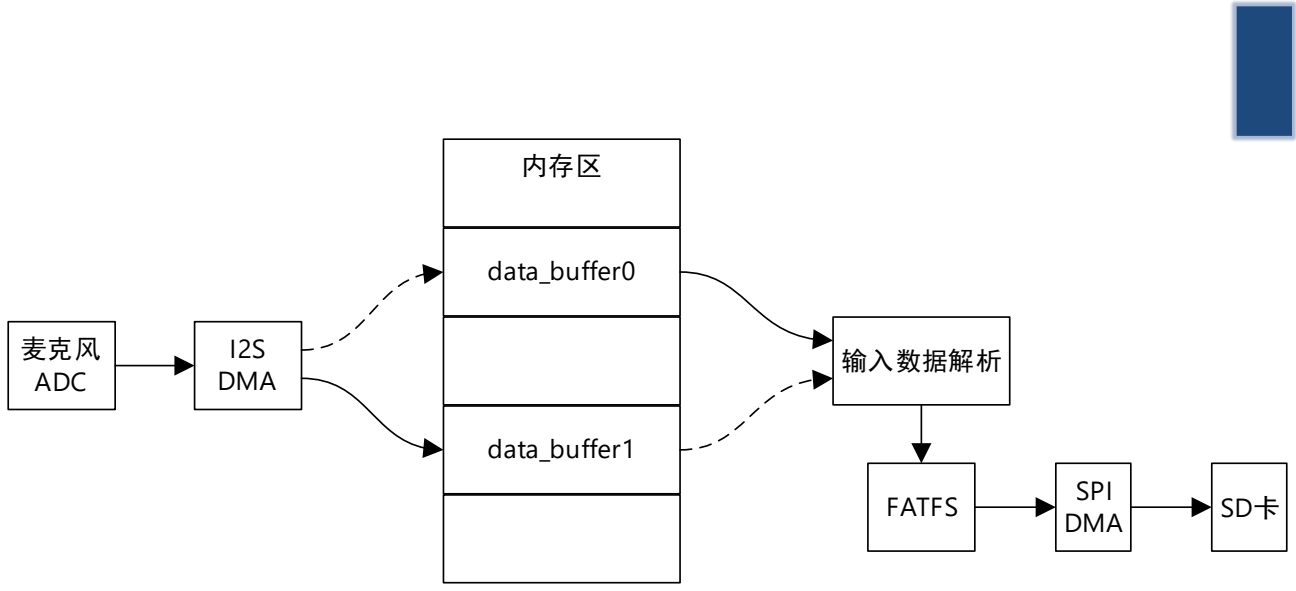
[picture p24: figure]
data_buffer1; data_buffer0; I2S DMA; 输入数据解析; SPI; DMA FATFS; SD卡; 内存区; 麦克风; ADC

图3-13 音频录制时双DMA双缓冲乒乓操作

图3-14 音频播放时双DMA双缓冲乒乓操作

## 应用层 - 音频录制 / 播放

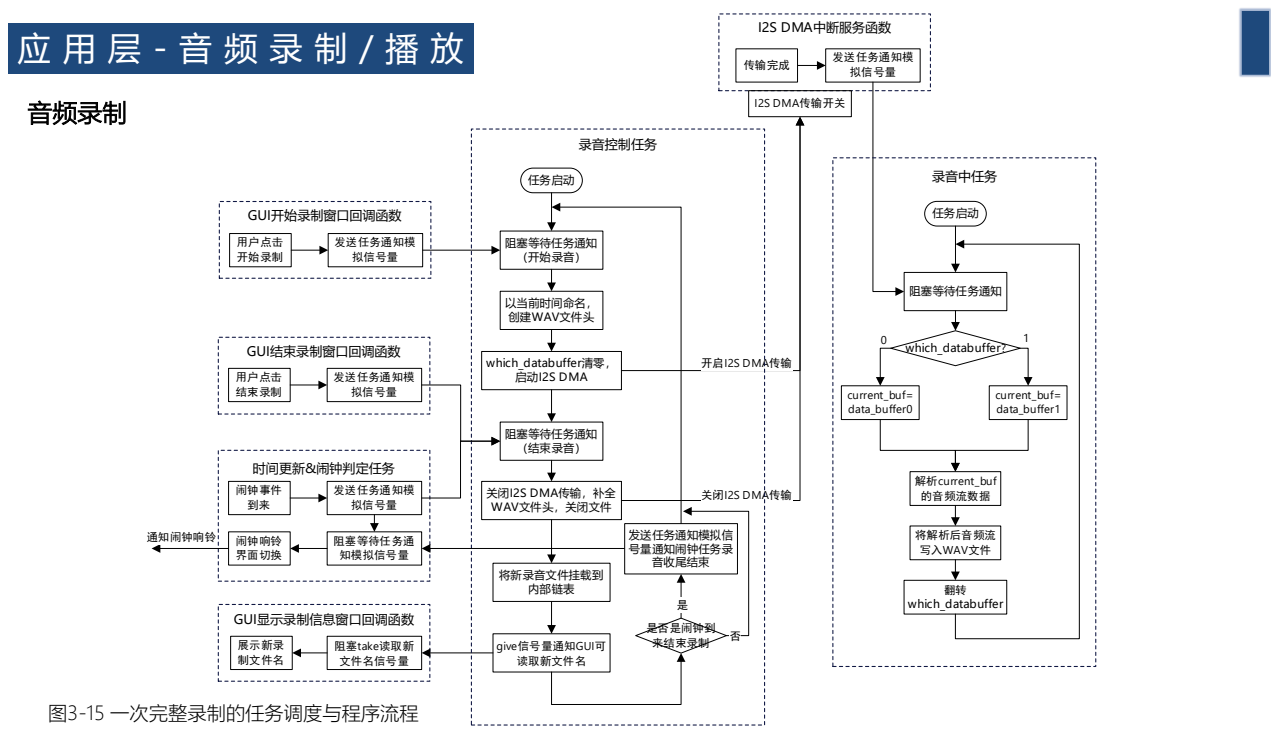
[picture p25: page 30]
用户点击 开始录制; 发送任务通知模 拟信号量; GUI开始录制窗口回调函数; 阻塞等待任务通知 （开始录音）; 任务启动; 以当前时间命名， 创建WAV文件头; which_databuffer清零， 启动I2S DMA; 阻塞等待任务通知 （结束录音）; 关闭I2S DMA传输，补全 WAV文件头，关闭文件; 将新录音文件挂载到 内部链表; give信号量通知GUI可 读取新文件名; 用户点击 结束录制; GUI结束录制窗口回调函数; 展示新录 制文件名; 阻塞take读取新 文件名信号量; GUI显示录制信息窗口回调函数; which_databuffer?; current_buf= data_buffer0; 解析current_buf 的音频流数据; 将解析后音频流 写入WAV文件; 翻转 which_databuffer; 传输完成; 发送任务通知模; 拟信号量; I2S DMA中断服务函数; 阻塞等待任务通知; current_buf= data_buffer1; I2S DMA传输开关; 开启I2S DMA传输; 关闭I2S DMA传输; 录音控制任务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

## 应用层 - 音频录制 / 播放

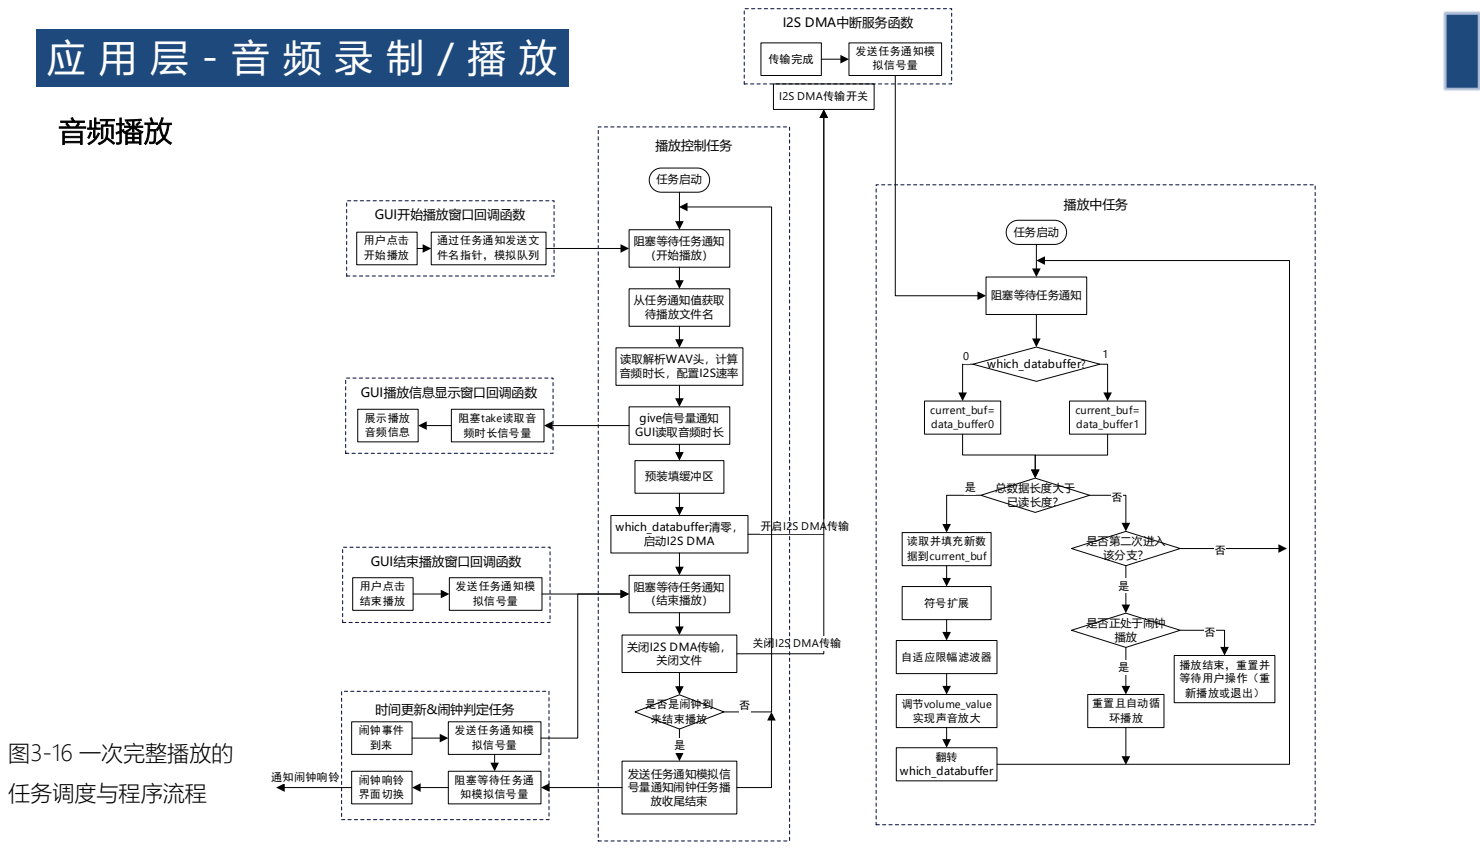
[picture p26: page 31]
图3-16 一次完整播放的; 任务调度与程序流程; 用户点击 开始播放; 通过任务通知发送文 件名指针，模拟队列; GUI开始播放窗口回调函数; 阻塞等待任务通知 （开始播放）; 任务启动; 从任务通知值获取 待播放文件名; which_databuffer清零， 启动I2S DMA; 阻塞等待任务通知 （结束播放）; 关闭I2S DMA传输， 关闭文件; 用户点击 结束播放; 发送任务通知模 拟信号量; GUI结束播放窗口回调函数; which_databuffer?; current_buf= data_buffer0; 读取并填充新数 据到current_buf; 符号扩展; 自适应限幅滤波器; 传输完成; 发送任务通知模; 拟信号量; I2S DMA中断服务函数; 阻塞等待任务通知; current_buf= data_buffer1; I2S DMA传输开关; 开启I2S DMA传输; 关闭I2S DMA传输; 播放中任务; 播放控制任务; 是否是闹钟到 来结束播放; 发送任务通知模拟信 号量通知闹钟任务播 放收尾结束; 读取解析WAV头，计算 音频时长，配置I2S速率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

## 应用层 - 音频录制 / 播放

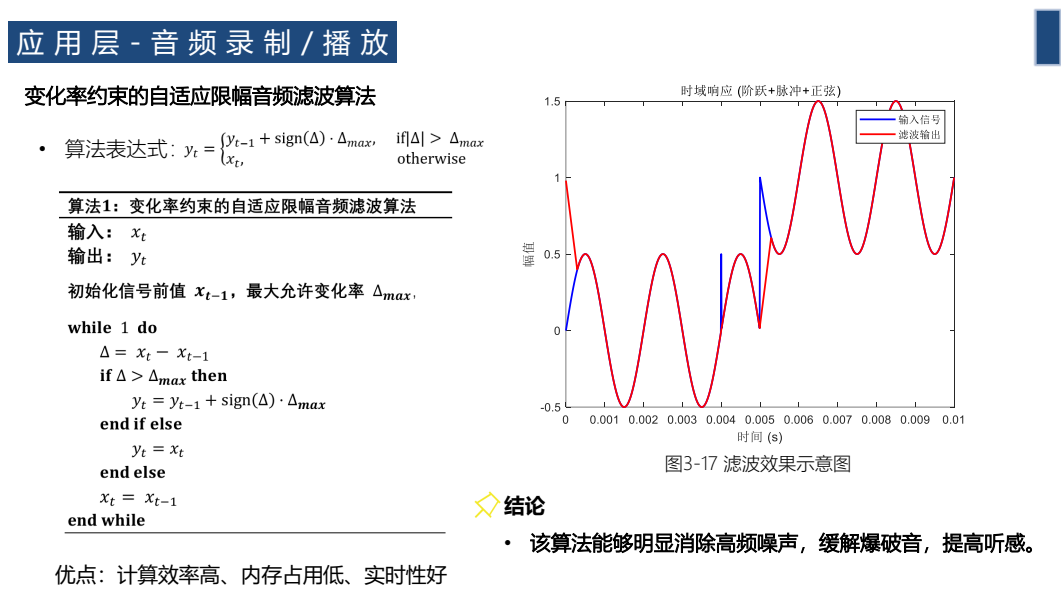
[picture p27: page 32]
• 算法表达式：; 图3-17 滤波效果示意图; 变化率约束的自适应限幅音频滤波算法

• 该算法能够明显消除高频噪声，缓解爆破音，提高听感。

优点：计算效率高、内存占用低、实时性好

04

### Part

# 系统测试

## 系统测试

界面显示与切换 | 触摸响应 | 音频录制、播放
画面清晰无锯齿，亮度正常，切换流畅。 通过GUI窗口和控件的复用，实测峰值 RAM占用从45kB减少到40kB, 节约12%。 | 多任务负载下，连续触发≥50 次点击操作， 触控响应延迟小于30ms，肉眼无卡顿延 迟，UI线程无阻塞，触摸驱动无死锁，事 件处理效率高。 | 音频数据流无采样率失配或位深截断问题。 在音质主观评价上，人耳感知无失真、噪 声干扰、畸变和突发尖锐爆破声。不同挡 位音量下声音大小变化明显，无失真。

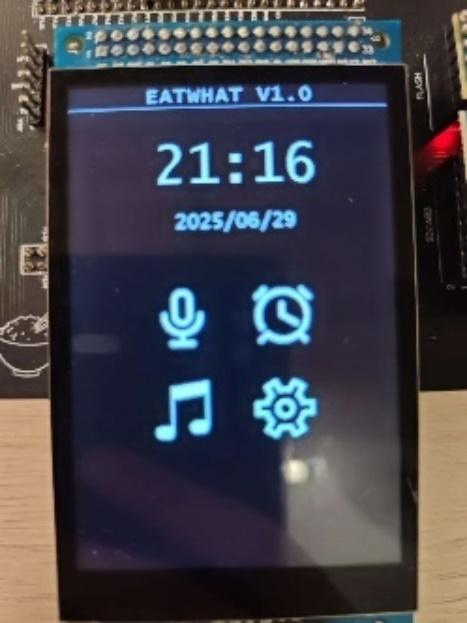
[picture p28: figure]
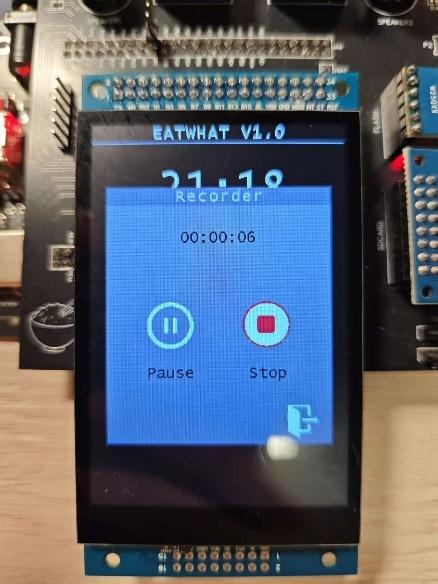
[picture p29: figure]
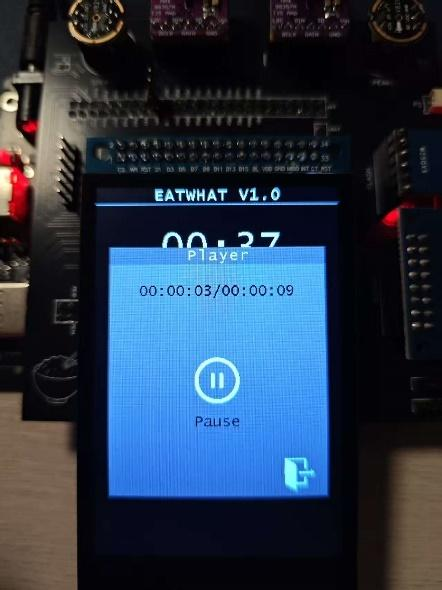
[picture p30: figure]

堆栈溢出检测 | 日期时间显示和设置
长时间连续增删文件，测得零内存泄漏， 零堆栈溢出，所有任务高水位线大于128字 节，链表节点插入/删除成功率100%，无 指针悬挂。 | 软件合法性检查有效。系统掉电十天后 RTC正常走时，时间误差在1分钟以内。

闹钟设置和响铃

在不同页面响铃，闹钟均正常打断和响铃，
正在录制/播放的音频文件能及时保存无丢
失。

## 系统测试

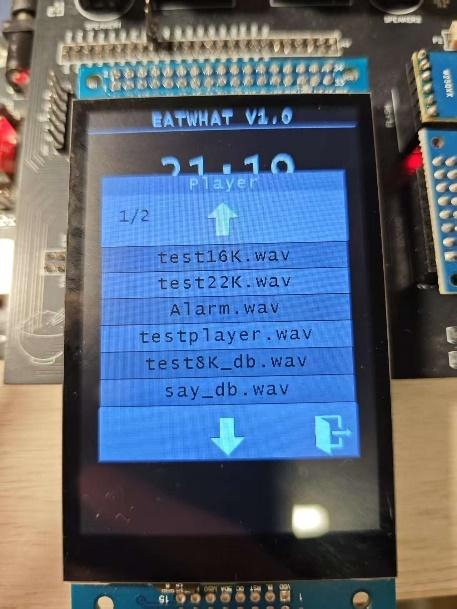
[picture p31: figure]
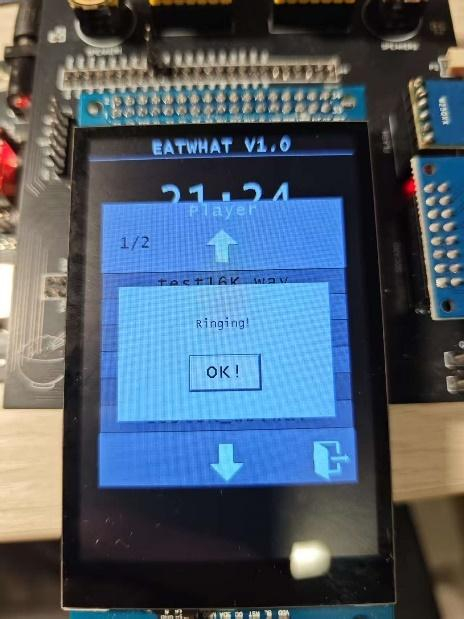
[picture p32: figure]

05

### Part

# 总结与展望

所设计系统实现预期功能，运行稳定，触摸响应灵敏，音频处理流畅。设计遵循低耦合模块化和分层 的设计思想，实用性和可扩展性强。整个系统硬件平台健壮，软件层次结构合理，系统工作流程有序，业 务功能稳定，并实现了一定的技术创新。

总结

展望

01

02

03

支持更多种音频编码格式

支持更高采样率更高量化位数的音频数据

支持更多的多媒体功能

## 总 结 与 展 望

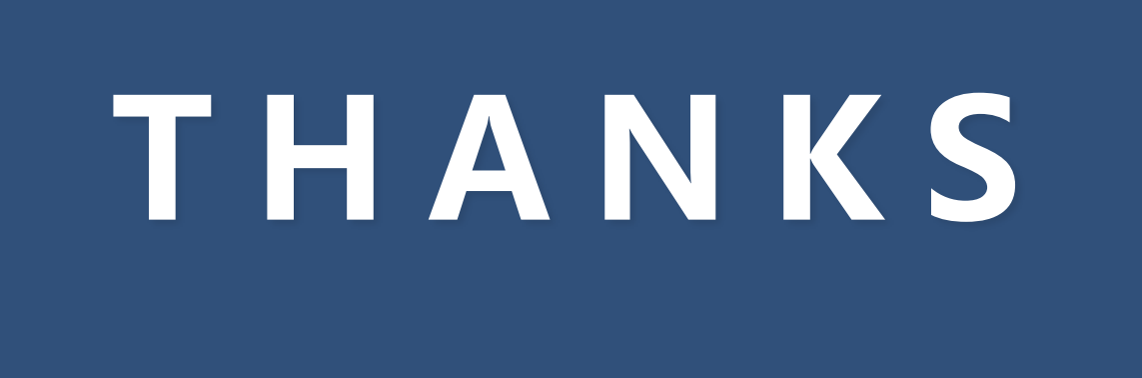
[picture p33: figure]
