rEDTii/EATWHAT/Drivers/FM33FK5xx_FL_Driver/Inc/fm33fk5xx_fl_adc.h

/**
  *******************************************************************************************************
  * @file    fm33fk5xx_fl_adc.h
  * @author  FMSH Application Team
  * @brief   Head file of ADC FL Module
  *******************************************************************************************************
  * @attention
  *
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
  *******************************************************************************************************
  */

/* Define to prevent recursive inclusion---------------------------------------------------------------*/
#ifndef __FM33FK5XX_FL_ADC_H
#define __FM33FK5XX_FL_ADC_H

#ifdef __cplusplus
extern "C" {
#endif
/* Includes -------------------------------------------------------------------------------------------*/
#include "fm33fk5xx_fl_def.h"
/** @addtogroup FM33FK5XX_FL_Driver
  * @{
  */
/* Exported types -------------------------------------------------------------------------------------*/
/** @defgroup ADC_FL_ES_INIT ADC Exported Init structures
  * @{
  */
#define ADC_VREF                    (*((uint16_t *)(0x0010FB0C)))   //VREF1P0
#define ADC_TS_VOL                  (*((uint16_t *)(0x0010FB10)))   //PTAT
/**
  * @brief FL ADC Init Sturcture definition
  */
typedef struct
{
    /** ADC工作时钟源选择 */
    uint32_t clockSource;
    /** ADCCLK预分频配置 */
    uint32_t clockPrescaler;
    /** ADC基准源选择 */
    uint32_t referenceSource;
    /** 转换模式配置 */
    uint32_t trigMode;
    /** 等待模式配置 */
    FL_FunState waitMode;
    /** 覆盖模式配置 */
    FL_FunState overrunMode;
    /** 过采样使能配置 */
    uint32_t oversamplingMode;
    /** 过采样率配置 */
    uint32_t overSampingMultiplier;

} FL_ADC_CommonInitTypeDef;

typedef struct
{
    /** 触发源选择 */
    uint32_t trigerSource;
    /** 采样通道选择*/
    uint32_t channelSelect;
    /** 通道采样时间配置 */
    uint32_t channelTime;
} FL_ADC_InitTypeDef;
/**
  * @
  */
/* Exported constants ---------------------------------------------------------------------------------*/
/** @defgroup ADC_FL_Exported_Constants ADC Exported Constants
  * @{
  */
#define    ADC_ACQ_ISR_OVR_Pos                                    (16U)
#define    ADC_ACQ_ISR_OVR_Msk                                    (0xffffU << ADC_ACQ_ISR_OVR_Pos)
#define    ADC_ACQ_ISR_OVR                                        ADC_ACQ_ISR_OVR_Msk

#define    ADC_ACQ_ISR_EOC_Pos                                    (0U)
#define    ADC_ACQ_ISR_EOC_Msk                                    (0xffffU << ADC_ACQ_ISR_EOC_Pos)
#define    ADC_ACQ_ISR_EOC                                        ADC_ACQ_ISR_EOC_Msk

#define    ADC_ACQ_IER_OVRIE_Pos                                  (16U)
#define    ADC_ACQ_IER_OVRIE_Msk                                  (0xffffU << ADC_ACQ_IER_OVRIE_Pos)
#define    ADC_ACQ_IER_OVRIE                                      ADC_ACQ_IER_OVRIE_Msk

#define    ADC_ACQ_IER_EOCIE_Pos                                  (0U)
#define    ADC_ACQ_IER_EOCIE_Msk                                  (0xffffU << ADC_ACQ_IER_EOCIE_Pos)
#define    ADC_ACQ_IER_EOCIE                                      ADC_ACQ_IER_EOCIE_Msk

#define    ADC_GISR_ACQ_ID_Pos                                    (4U)
#define    ADC_GISR_ACQ_ID_Msk                                    (0x1fU << ADC_GISR_ACQ_ID_Pos)
#define    ADC_GISR_ACQ_ID                                        ADC_GISR_ACQ_ID_Msk

#define    ADC_GISR_OSF_Pos                                       (3U)
#define    ADC_GISR_OSF_Msk                                       (0x1U << ADC_GISR_OSF_Pos)
#define    ADC_GISR_OSF                                           ADC_GISR_OSF_Msk

#define    ADC_GISR_EOCNT_Pos                                     (2U)
#define    ADC_GISR_EOCNT_Msk                                     (0x1U << ADC_GISR_EOCNT_Pos)
#define    ADC_GISR_EOCNT                                         ADC_GISR_EOCNT_Msk

#define    ADC_GISR_BUSY_Pos                                      (1U)
#define    ADC_GISR_BUSY_Msk                                      (0x1U << ADC_GISR_BUSY_Pos)
#define    ADC_GISR_BUSY                                          ADC_GISR_BUSY_Msk

#define    ADC_GIER_EOCNTIE_Pos                                   (2U)
#define    ADC_GIER_EOCNTIE_Msk                                   (0x1U << ADC_GIER_EOCNTIE_Pos)
#define    ADC_GIER_EOCNTIE                                       ADC_GIER_EOCNTIE_Msk

#define    ADC_CR1_ACQEN_Pos                                      (16U)
#define    ADC_CR1_ACQEN_Msk                                      (0xffffU << ADC_CR1_ACQEN_Pos)
#define    ADC_CR1_ACQEN                                          ADC_CR1_ACQEN_Msk

#define    ADC_CR1_RR_SWRST_Pos                                   (1U)
#define    ADC_CR1_RR_SWRST_Msk                                   (0x1U << ADC_CR1_RR_SWRST_Pos)
#define    ADC_CR1_RR_SWRST                                       ADC_CR1_RR_SWRST_Msk

#define    ADC_CR1_ADEN_Pos                                       (0U)
#define    ADC_CR1_ADEN_Msk                                       (0x1U << ADC_CR1_ADEN_Pos)
#define    ADC_CR1_ADEN                                           ADC_CR1_ADEN_Msk

#define    ADC_CR2_SWTRIG_Pos                                     (0U)
#define    ADC_CR2_SWTRIG_Msk                                     (0xffffU << ADC_CR2_SWTRIG_Pos)
#define    ADC_CR2_SWTRIG                                         ADC_CR2_SWTRIG_Msk

#define    ADC_CFGR1_RPTLEN_Pos                                   (16U)
#define    ADC_CFGR1_RPTLEN_Msk                                   (0xffffU << ADC_CFGR1_RPTLEN_Pos)
#define    ADC_CFGR1_RPTLEN                                       ADC_CFGR1_RPTLEN_Msk

#define    ADC_CFGR1_CONV_CYCLE_Pos                               (8U)
#define    ADC_CFGR1_CONV_CYCLE_Msk                               (0xffU << ADC_CFGR1_CONV_CYCLE_Pos)
#define    ADC_CFGR1_CONV_CYCLE                                   ADC_CFGR1_CONV_CYCLE_Msk

#define    ADC_CFGR1_SYNC_MODE_Pos                                (4U)
#define    ADC_CFGR1_SYNC_MODE_Msk                                (0x1U << ADC_CFGR1_SYNC_MODE_Pos)
#define    ADC_CFGR1_SYNC_MODE                                    ADC_CFGR1_SYNC_MODE_Msk

#define    ADC_CFGR1_INJ_MODE_Pos                                 (3U)
#define    ADC_CFGR1_INJ_MODE_Msk                                 (0x1U << ADC_CFGR1_INJ_MODE_Pos)
#define    ADC_CFGR1_INJ_MODE                                     ADC_CFGR1_INJ_MODE_Msk

#define    ADC_CFGR1_REFNSEL_Pos                                  (2U)
#define    ADC_CFGR1_REFNSEL_Msk                                  (0x1U << ADC_CFGR1_REFNSEL_Pos)
#define    ADC_CFGR1_REFNSEL                                      ADC_CFGR1_REFNSEL_Msk

#define    ADC_CFGR1_PEFSEL_Pos                                   (0U)
#define    ADC_CFGR1_PEFSEL_Msk                                   (0x3U << ADC_CFGR1_PEFSEL_Pos)
#define    ADC_CFGR1_PEFSEL                                       ADC_CFGR1_PEFSEL_Msk

#define    ADC_CFGR2_AVGR_Pos                                     (18U)
#define    ADC_CFGR2_AVGR_Msk                                     (0x3U << ADC_CFGR2_AVGR_Pos)
#define    ADC_CFGR2_AVGR                                         ADC_CFGR2_AVGR_Msk

#define    ADC_CFGR2_AVGEN_Pos                                    (16U)
#define    ADC_CFGR2_AVGEN_Msk                                    (0x3U << ADC_CFGR2_AVGEN_Pos)
#define    ADC_CFGR2_AVGEN                                        ADC_CFGR2_AVGEN_Msk

#define    ADC_CFGR2_WAIT_Pos                                     (11U)
#define    ADC_CFGR2_WAIT_Msk                                     (0x1U << ADC_CFGR2_WAIT_Pos)
#define    ADC_CFGR2_WAIT                                         ADC_CFGR2_WAIT_Msk

#define    ADC_CFGR2_TMOD_Pos                                     (9U)
#define    ADC_CFGR2_TMOD_Msk                                     (0x3U << ADC_CFGR2_TMOD_Pos)
#define    ADC_CFGR2_TMOD                                         ADC_CFGR2_TMOD_Msk

#define    ADC_CFGR2_OVRM_Pos                                     (8U)
#define    ADC_CFGR2_OVRM_Msk                                     (0x1U << ADC_CFGR2_OVRM_Pos)
#define    ADC_CFGR2_OVRM                                         ADC_CFGR2_OVRM_Msk

#define    ADC_CFGR2_DMAEN_Pos                                    (0U)
#define    ADC_CFGR2_DMAEN_Msk                                    (0x1U << ADC_CFGR2_DMAEN_Pos)
#define    ADC_CFGR2_DMAEN                                        ADC_CFGR2_DMAEN_Msk

#define    ADC_PRICR_INJC_Pos                                     (0U)
#define    ADC_PRICR_INJC_Msk                                     (0xfU << ADC_PRICR_INJC_Pos)
#define    ADC_PRICR_INJC                                         ADC_PRICR_INJC_Msk

#define    ADC_DMR_DM14_Pos                                       (7U)
#define    ADC_DMR_DM14_Msk                                       (0x1U << ADC_DMR_DM14_Pos)
#define    ADC_DMR_DM14                                           ADC_DMR_DM14_Msk

#define    ADC_DMR_DM12_Pos                                       (6U)
#define    ADC_DMR_DM12_Msk                                       (0x1U << ADC_DMR_DM12_Pos)
#define    ADC_DMR_DM12                                           ADC_DMR_DM12_Msk

#define    ADC_DMR_DM10_Pos                                       (5U)
#define    ADC_DMR_DM10_Msk                                       (0x1U << ADC_DMR_DM10_Pos)
#define    ADC_DMR_DM10                                           ADC_DMR_DM10_Msk

#define    ADC_DMR_DM8_Pos                                        (4U)
#define    ADC_DMR_DM8_Msk                                        (0x1U << ADC_DMR_DM8_Pos)
#define    ADC_DMR_DM8                                            ADC_DMR_DM8_Msk

#define    ADC_DMR_DM6_Pos                                        (3U)
#define    ADC_DMR_DM6_Msk                                        (0x1U << ADC_DMR_DM6_Pos)
#define    ADC_DMR_DM6                                            ADC_DMR_DM6_Msk

#define    ADC_DMR_DM4_Pos                                        (2U)
#define    ADC_DMR_DM4_Msk                                        (0x1U << ADC_DMR_DM4_Pos)
#define    ADC_DMR_DM4                                            ADC_DMR_DM4_Msk

#define    ADC_DMR_DM2_Pos                                        (1U)
#define    ADC_DMR_DM2_Msk                                        (0x1U << ADC_DMR_DM2_Pos)
#define    ADC_DMR_DM2                                            ADC_DMR_DM2_Msk

#define    ADC_DMR_DM0_Pos                                        (0U)
#define    ADC_DMR_DM0_Msk                                        (0x1U << ADC_DMR_DM0_Pos)
#define    ADC_DMR_DM0                                            ADC_DMR_DM0_Msk

#define    ADC_OSR_POS_CALI_Pos                                   (16U)
#define    ADC_OSR_POS_CALI_Msk                                   (0x1fffU << ADC_OSR_POS_CALI_Pos)
#define    ADC_OSR_POS_CALI                                       ADC_OSR_POS_CALI_Msk

#define    ADC_OSR_NOS_CALI_Pos                                   (0U)
#define    ADC_OSR_NOS_CALI_Msk                                   (0x1fffU << ADC_OSR_NOS_CALI_Pos)
#define    ADC_OSR_NOS_CALI                                       ADC_OSR_NOS_CALI_Msk

#define    ADC_ACQ_SR_REQ_Pos                                     (0U)
#define    ADC_ACQ_SR_REQ_Msk                                     (0xffffU << ADC_ACQ_SR_REQ_Pos)
#define    ADC_ACQ_SR_REQ                                         ADC_ACQ_SR_REQ_Msk

#define    ADC_ACQ0_CR_CHSEL_Pos                                  (9U)
#define    ADC_ACQ0_CR_CHSEL_Msk                                  (0x1fU << ADC_ACQ0_CR_CHSEL_Pos)
#define    ADC_ACQ0_CR_CHSEL                                      ADC_ACQ0_CR_CHSEL_Msk

#define    ADC_ACQ0_CR_TRIGSEL_Pos                                (4U)
#define    ADC_ACQ0_CR_TRIGSEL_Msk                                (0x1fU << ADC_ACQ0_CR_TRIGSEL_Pos)
#define    ADC_ACQ0_CR_TRIGSEL                                    ADC_ACQ0_CR_TRIGSEL_Msk

#define    ADC_ACQ0_CR_SMTS_Pos                                   (0U)
#define    ADC_ACQ0_CR_SMTS_Msk                                   (0xfU << ADC_ACQ0_CR_SMTS_Pos)
#define    ADC_ACQ0_CR_SMTS                                       ADC_ACQ0_CR_SMTS_Msk

#define    ADC_ACQ1_CR_CHSEL_Pos                                  (9U)
#define    ADC_ACQ1_CR_CHSEL_Msk                                  (0x1fU << ADC_ACQ1_CR_CHSEL_Pos)
#define    ADC_ACQ1_CR_CHSEL                                      ADC_ACQ1_CR_CHSEL_Msk

#define    ADC_ACQ1_CR_TRIGSEL_Pos                                (4U)
#define    ADC_ACQ1_CR_TRIGSEL_Msk                                (0x1fU << ADC_ACQ1_CR_TRIGSEL_Pos)
#define    ADC_ACQ1_CR_TRIGSEL                                    ADC_ACQ1_CR_TRIGSEL_Msk

#define    ADC_ACQ1_CR_SMTS_Pos                                   (0U)
#define    ADC_ACQ1_CR_SMTS_Msk                                   (0xfU << ADC_ACQ1_CR_SMTS_Pos)
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
#define    FL_ADC_ACQ_SELECT_CHANNEL_INB3                         (0x13U << 9U)
#define    FL_ADC_ACQ_SELECT_CHANNEL_INB4                         (0x14U << 9U)
#define    FL_ADC_ACQ_SELECT_CHANNEL_INB5                         (0x15U << 9U)
#define    FL_ADC_ACQ_SELECT_CHANNEL_INB6                         (0x16U << 9U)
#define    FL_ADC_ACQ_SELECT_CHANNEL_INB7                         (0x17U << 9U)
#define    FL_ADC_ACQ_SELECT_CHANNEL_INB8_OPA1_OUT                (0x18U << 9U)
#define    FL_ADC_ACQ_SELECT_CHANNEL_VBAT_DIV3                   (0x19U << 9U)
#define    FL_ADC_ACQ_SELECT_CHANNEL_DAC0                         (0x1aU << 9U)
#define    FL_ADC_ACQ_SELECT_CHANNEL_N_CALIBRATION                (0x1cU << 9U)
#define    FL_ADC_ACQ_TRGI_SOFE_TRG                               (0x0U << 4U)
#define    FL_ADC_ACQ_TRGI_LUT0_TRG                               (0x1U << 4U)
#define    FL_ADC_ACQ_TRGI_LUT1_TRG                               (0x2U << 4U)
#define    FL_ADC_ACQ_TRGI_LUT2_TRG                               (0x3U << 4U)
#define    FL_ADC_ACQ_TRGI_LUT3_TRG                               (0x4U << 4U)
#define    FL_ADC_ACQ_TRGI_ATIM0_TRGO                             (0x5U << 4U)
#define    FL_ADC_ACQ_TRGI_ATIM1_TRGO                             (0x6U << 4U)
#define    FL_ADC_ACQ_TRGI_ATIM0_TRGO2                            (0x7U << 4U)
#define    FL_ADC_ACQ_TRGI_ATIM1_TRGO2                            (0x8U << 4U)
#define    FL_ADC_ACQ_TRGI_GPTIM0_TRGO                            (0x9U << 4U)
#define    FL_ADC_ACQ_TRGI_GPTIM1_TRGO                            (0xaU << 4U)
#define    FL_ADC_ACQ_TRGI_GPTIM2_TRGO                            (0xbU << 4U)
#define    FL_ADC_ACQ_TRGI_EPWM0SOCA                              (0xcU << 4U)
#define    FL_ADC_ACQ_TRGI_EPWM0SOCB                              (0xdU << 4U)
#define    FL_ADC_ACQ_TRGI_EPWM1SOCA                              (0xeU << 4U)
#define    FL_ADC_ACQ_TRGI_EPWM1SOCB                              (0xfU << 4U)
#define    FL_ADC_ACQ_TRGI_EPWM2SOCA                              (0x10U << 4U)
#define    FL_ADC_ACQ_TRGI_EPWM2SOCB                              (0x11U << 4U)
#define    FL_ADC_ACQ_TRGI_EPWM3SOCA                              (0x12U << 4U)
#define    FL_ADC_ACQ_TRGI_EPWM3SOCB                              (0x13U << 4U)
#define    FL_ADC_ACQ_TRGI_COMP0_TRGO                             (0x14U << 4U)
#define    FL_ADC_ACQ_TRGI_COMP1_TRGO                             (0x15U << 4U)
#define    FL_ADC_ACQ_TRGI_COMP2_TRGO                             (0x16U << 4U)
#define    FL_ADC_ACQ_TRGI_LPTIM0_TRGO                            (0x17U << 4U)
#define    FL_ADC_ACQ_TRGI_BSTIM0_TRGO                            (0x18U << 4U)
#define    FL_ADC_ACQ_SAMPLING_TIME_1_ADCCLK                      (0x0U << 0U)
#define    FL_ADC_ACQ_SAMPLING_TIME_2_ADCCLK                      (0x1U << 0U)
#define    FL_ADC_ACQ_SAMPLING_TIME_4_ADCCLK                      (0x2U << 0U)
#define    FL_ADC_ACQ_SAMPLING_TIME_8_ADCCLK                      (0x3U << 0U)
#define    FL_ADC_ACQ_SAMPLING_TIME_12_ADCCLK                     (0x4U << 0U)
#define    FL_ADC_ACQ_SAMPLING_TIME_16_ADCCLK                     (0x5U << 0U)
#define    FL_ADC_ACQ_SAMPLING_TIME_32_ADCCLK                     (0x6U << 0U)
#define    FL_ADC_ACQ_SAMPLING_TIME_64_ADCCLK                     (0x7U << 0U)
#define    FL_ADC_ACQ_SAMPLING_TIME_80_ADCCLK                     (0x8U << 0U)
#define    FL_ADC_ACQ_SAMPLING_TIME_96_ADCCLK                     (0x9U << 0U)
#define    FL_ADC_ACQ_SAMPLING_TIME_128_ADCCLK                    (0xaU << 0U)
#define    FL_ADC_ACQ_SAMPLING_TIME_160_ADCCLK                    (0xbU << 0U)
#define    FL_ADC_ACQ_SAMPLING_TIME_192_ADCCLK                    (0xcU << 0U)
#define    FL_ADC_ACQ_SAMPLING_TIME_256_ADCCLK                    (0xdU << 0U)
#define    FL_ADC_ACQ_SAMPLING_TIME_320_ADCCLK                    (0xeU << 0U)
#define    FL_ADC_ACQ_SAMPLING_TIME_512_ADCCLK                    (0xfU << 0U)

#define    FL_ADC_SYNC_MODE_ASYNC                                 (0x0U << ADC_CFGR1_SYNC_MODE_Pos)
#define    FL_ADC_SYNC_MODE_SYNC                                  (0x1U << ADC_CFGR1_SYNC_MODE_Pos)

#define    FL_ADC_INJ_MODE_DELAY                                  (0x0U << ADC_CFGR1_INJ_MODE_Pos)
#define    FL_ADC_INJ_MODE_IMMEDIA                                (0x1U << ADC_CFGR1_INJ_MODE_Pos)

#define    FL_ADC_Negative_Peference_VSSA                         (0x0U << ADC_CFGR1_REFNSEL_Pos)
#define    FL_ADC_Negative_Peference_VREFN                        (0x1U << ADC_CFGR1_REFNSEL_Pos)

#define    FL_ADC_REF_SOURCE_VDDA                                 (0x0U << ADC_CFGR1_PEFSEL_Pos)
#define    FL_ADC_REF_SOURCE_VREFP                                (0x1U << ADC_CFGR1_PEFSEL_Pos)

#define    FL_ADC_OVERSAMPLING_MUL_2X                             (0x0U << ADC_CFGR2_AVGR_Pos)
#define    FL_ADC_OVERSAMPLING_MUL_4X                             (0x1U << ADC_CFGR2_AVGR_Pos)
#define    FL_ADC_OVERSAMPLING_MUL_8X                             (0x2U << ADC_CFGR2_AVGR_Pos)
#define    FL_ADC_OVERSAMPLING_MUL_16X                            (0x3U << ADC_CFGR2_AVGR_Pos)

#define    FL_ADC_OVERSAMPLING_MODE_DISABLE                       (0x0U << ADC_CFGR2_AVGEN_Pos)
#define    FL_ADC_OVERSAMPLING_MODE_ENABLE_AVERAGE                (0x1U << ADC_CFGR2_AVGEN_Pos)

#define    FL_ADC_TRIGER_MODE_NOMAL                               (0x0U << ADC_CFGR2_TMOD_Pos)
#define    FL_ADC_TRIGER_MODE_ONE_SHOT                            (0x1U << ADC_CFGR2_TMOD_Pos)
#define    FL_ADC_TRIGER_MODE_CONTINUOUS                          (0x2U << ADC_CFGR2_TMOD_Pos)

#define    FL_ADC_INJECTION_CONTROL_NONE                          (0x0U << ADC_PRICR_INJC_Pos)
#define    FL_ADC_INJECTION_CONTROL_ACQ0                          (0x1U << ADC_PRICR_INJC_Pos)
#define    FL_ADC_INJECTION_CONTROL_ACQ0_TO_1                     (0x2U << ADC_PRICR_INJC_Pos)
#define    FL_ADC_INJECTION_CONTROL_ACQ0_TO_2                     (0x3U << ADC_PRICR_INJC_Pos)
#define    FL_ADC_INJECTION_CONTROL_ACQ0_TO_3                     (0x4U << ADC_PRICR_INJC_Pos)
#define    FL_ADC_INJECTION_CONTROL_ACQ0_TO_4                     (0x5U << ADC_PRICR_INJC_Pos)
#define    FL_ADC_INJECTION_CONTROL_ACQ0_TO_5                     (0x6U << ADC_PRICR_INJC_Pos)
#define    FL_ADC_INJECTION_CONTROL_ACQ0_TO_6                     (0x7U << ADC_PRICR_INJC_Pos)
#define    FL_ADC_INJECTION_CONTROL_ACQ0_TO_7                     (0x8U << ADC_PRICR_INJC_Pos)

#define    FL_ADC_DUAL14_MODE_DISABLE                             (0x0U << ADC_DMR_DM14_Pos)
#define    FL_ADC_DUAL14_MODE_ENABLE                              (0x1U << ADC_DMR_DM14_Pos)

#define    FL_ADC_DUAL12_MODE_DISABLE                             (0x0U << ADC_DMR_DM12_Pos)
#define    FL_ADC_DUAL12_MODE_ENABLE                              (0x1U << ADC_DMR_DM12_Pos)

#define    FL_ADC_DUAL10_MODE_DISABLE                             (0x0U << ADC_DMR_DM10_Pos)
#define    FL_ADC_DUAL10_MODE_ENABLE                              (0x1U << ADC_DMR_DM10_Pos)

#define    FL_ADC_DUAL8_MODE_DISABLE                              (0x0U << ADC_DMR_DM8_Pos)
#define    FL_ADC_DUAL8_MODE_ENABLE                               (0x1U << ADC_DMR_DM8_Pos)

#define    FL_ADC_DUAL6_MODE_DISABLE                              (0x0U << ADC_DMR_DM6_Pos)
#define    FL_ADC_DUAL6_MODE_ENABLE                               (0x1U << ADC_DMR_DM6_Pos)

#define    FL_ADC_DUAL4_MODE_DISABLE                              (0x0U << ADC_DMR_DM4_Pos)
#define    FL_ADC_DUAL4_MODE_ENABLE                               (0x1U << ADC_DMR_DM4_Pos)

#define    FL_ADC_DUAL2_MODE_DISABLE                              (0x0U << ADC_DMR_DM2_Pos)
#define    FL_ADC_DUAL2_MODE_ENABLE                               (0x1U << ADC_DMR_DM2_Pos)

#define    FL_ADC_DUAL0_MODE_DISABLE                              (0x0U << ADC_DMR_DM0_Pos)
#define    FL_ADC_DUAL0_MODE_ENABLE                               (0x1U << ADC_DMR_DM0_Pos)

#define    FL_ADC_ACQ0_SELECT_CHANNEL_ADC_INA0                    (0x0U << ADC_ACQ0_CR_CHSEL_Pos)
#define    FL_ADC_ACQ0_SELECT_CHANNEL_ADC_INA1                    (0x1U << ADC_ACQ0_CR_CHSEL_Pos)
#define    FL_ADC_ACQ0_SELECT_CHANNEL_ADC_INA2                    (0x2U << ADC_ACQ0_CR_CHSEL_Pos)
#define    FL_ADC_ACQ0_SELECT_CHANNEL_ADC_INA3                    (0x3U << ADC_ACQ0_CR_CHSEL_Pos)
#define    FL_ADC_ACQ0_SELECT_CHANNEL_ADC_INA4                    (0x4U << ADC_ACQ0_CR_CHSEL_Pos)
#define    FL_ADC_ACQ0_SELECT_CHANNEL_ADC_INA5                    (0x5U << ADC_ACQ0_CR_CHSEL_Pos)
#define    FL_ADC_ACQ0_SELECT_CHANNEL_ADC_INA6                    (0x6U << ADC_ACQ0_CR_CHSEL_Pos)
#define    FL_ADC_ACQ0_SELECT_CHANNEL_ADC_INA7                    (0x7U << ADC_ACQ0_CR_CHSEL_Pos)
#define    FL_ADC_ACQ0_SELECT_CHANNEL_ADC_INA8_OPA0_OUT           (0x8U << ADC_ACQ0_CR_CHSEL_Pos)
#define    FL_ADC_ACQ0_SELECT_CHANNEL_TS                          (0x9U << ADC_ACQ0_CR_CHSEL_Pos)
#define    FL_ADC_ACQ0_SELECT_CHANNEL_AVREF                       (0xaU << ADC_ACQ0_CR_CHSEL_Pos)
#define    FL_ADC_ACQ0_SELECT_CHANNEL_P_CALIBRATION               (0xcU << ADC_ACQ0_CR_CHSEL_Pos)
#define    FL_ADC_ACQ0_SELECT_CHANNEL_ADC_INB0                    (0x10U << ADC_ACQ0_CR_CHSEL_Pos)
#define    FL_ADC_ACQ0_SELECT_CHANNEL_ADC_INB1                    (0x11U << ADC_ACQ0_CR_CHSEL_Pos)
#define    FL_ADC_ACQ0_SELECT_CHANNEL_ADC_INB2                    (0x12U << ADC_ACQ0_CR_CHSEL_Pos)
#define    FL_ADC_ACQ0_SELECT_CHANNEL_ADC_INB3                    (0x13U << ADC_ACQ0_CR_CHSEL_Pos)
#define    FL_ADC_ACQ0_SELECT_CHANNEL_ADC_INB4                    (0x14U << ADC_ACQ0_CR_CHSEL_Pos)
#define    FL_ADC_ACQ0_SELECT_CHANNEL_ADC_INB5                    (0x15U << ADC_ACQ0_CR_CHSEL_Pos)
#define    FL_ADC_ACQ0_SELECT_CHANNEL_ADC_INB6                    (0x16U << ADC_ACQ0_CR_CHSEL_Pos)
#define    FL_ADC_ACQ0_SELECT_CHANNEL_ADC_INB7                    (0x17U << ADC_ACQ0_CR_CHSEL_Pos)
#define    FL_ADC_ACQ0_SELECT_CHANNEL_ADC_INB8_OPA1_OUT           (0x18U << ADC_ACQ0_CR_CHSEL_Pos)
#define    FL_ADC_ACQ0_SELECT_CHANNEL_VBAT_DIV3                  (0x19U << ADC_ACQ0_CR_CHSEL_Pos)
#define    FL_ADC_ACQ0_SELECT_CHANNEL_DAC1_OUT1                   (0x1aU << ADC_ACQ0_CR_CHSEL_Pos)
#define    FL_ADC_ACQ0_SELECT_CHANNEL_N_CALIBRATION               (0x1cU << ADC_ACQ0_CR_CHSEL_Pos)

#define    FL_ADC_ACQ0_TRGI_SOFE_TRG                              (0x0U << ADC_ACQ0_CR_TRIGSEL_Pos)
#define    FL_ADC_ACQ0_TRGI_LUT0_TRG                              (0x1U << ADC_ACQ0_CR_TRIGSEL_Pos)
#define    FL_ADC_ACQ0_TRGI_LUT1_TRG                              (0x2U << ADC_ACQ0_CR_TRIGSEL_Pos)
#define    FL_ADC_ACQ0_TRGI_LUT2_TRG                              (0x3U << ADC_ACQ0_CR_TRIGSEL_Pos)
#define    FL_ADC_ACQ0_TRGI_LUT3_TRG                              (0x4U << ADC_ACQ0_CR_TRIGSEL_Pos)
#define    FL_ADC_ACQ0_TRGI_ATIM0_TRGO                            (0x5U << ADC_ACQ0_CR_TRIGSEL_Pos)
#define    FL_ADC_ACQ0_TRGI_ATIM1_TRGO                            (0x6U << ADC_ACQ0_CR_TRIGSEL_Pos)
#define    FL_ADC_ACQ0_TRGI_ATIM0_TRGO2                           (0x7U << ADC_ACQ0_CR_TRIGSEL_Pos)
#define    FL_ADC_ACQ0_TRGI_ATIM1_TRGO2                           (0x8U << ADC_ACQ0_CR_TRIGSEL_Pos)
#define    FL_ADC_ACQ0_TRGI_GPTIM0_TRGO                           (0x9U << ADC_ACQ0_CR_TRIGSEL_Pos)
#define    FL_ADC_ACQ0_TRGI_GPTIM1_TRGO                           (0xaU << ADC_ACQ0_CR_TRIGSEL_Pos)
#define    FL_ADC_ACQ0_TRGI_GPTIM2_TRGO                           (0xbU << ADC_ACQ0_CR_TRIGSEL_Pos)
#define    FL_ADC_ACQ0_TRGI_EPWM0SOCA                             (0xcU << ADC_ACQ0_CR_TRIGSEL_Pos)
#define    FL_ADC_ACQ0_TRGI_EPWM0SOCB                             (0xdU << ADC_ACQ0_CR_TRIGSEL_Pos)
#define    FL_ADC_ACQ0_TRGI_EPWM1SOCA                             (0xeU << ADC_ACQ0_CR_TRIGSEL_Pos)
#define    FL_ADC_ACQ0_TRGI_EPWM1SOCB                             (0xfU << ADC_ACQ0_CR_TRIGSEL_Pos)
#define    FL_ADC_ACQ0_TRGI_EPWM2SOCA                             (0x10U << ADC_ACQ0_CR_TRIGSEL_Pos)
#define    FL_ADC_ACQ0_TRGI_EPWM2SOCB                             (0x11U << ADC_ACQ0_CR_TRIGSEL_Pos)
#define    FL_ADC_ACQ0_TRGI_EPWM3SOCA                             (0x12U << ADC_ACQ0_CR_TRIGSEL_Pos)
#define    FL_ADC_ACQ0_TRGI_EPWM3SOCB                             (0x13U << ADC_ACQ0_CR_TRIGSEL_Pos)
#define    FL_ADC_ACQ0_TRGI_COMP0_TRGO                            (0x14U << ADC_ACQ0_CR_TRIGSEL_Pos)
#define    FL_ADC_ACQ0_TRGI_COMP1_TRGO                            (0x15U << ADC_ACQ0_CR_TRIGSEL_Pos)
#define    FL_ADC_ACQ0_TRGI_COMP2_TRGO                            (0x16U << ADC_ACQ0_CR_TRIGSEL_Pos)
#define    FL_ADC_ACQ0_TRGI_LPTIM0_TRGO                           (0x17U << ADC_ACQ0_CR_TRIGSEL_Pos)
#define    FL_ADC_ACQ0_TRGI_BSTIM0_TRGO                           (0x18U << ADC_ACQ0_CR_TRIGSEL_Pos)

#define    FL_ADC_ACQ0_SAMPLING_TIME_1_ADCCLK                     (0x0U << ADC_ACQ0_CR_SMTS_Pos)
#define    FL_ADC_ACQ0_SAMPLING_TIME_2_ADCCLK                     (0x1U << ADC_ACQ0_CR_SMTS_Pos)
#define    FL_ADC_ACQ0_SAMPLING_TIME_4_ADCCLK                     (0x2U << ADC_ACQ0_CR_SMTS_Pos)
#define    FL_ADC_ACQ0_SAMPLING_TIME_8_ADCCLK                     (0x3U << ADC_ACQ0_CR_SMTS_Pos)
#define    FL_ADC_ACQ0_SAMPLING_TIME_12_ADCCLK                    (0x4U << ADC_ACQ0_CR_SMTS_Pos)
#define    FL_ADC_ACQ0_SAMPLING_TIME_16_ADCCLK                    (0x5U << ADC_ACQ0_CR_SMTS_Pos)
#define    FL_ADC_ACQ0_SAMPLING_TIME_32_ADCCLK                    (0x6U << ADC_ACQ0_CR_SMTS_Pos)
#define    FL_ADC_ACQ0_SAMPLING_TIME_64_ADCCLK                    (0x7U << ADC_ACQ0_CR_SMTS_Pos)
#define    FL_ADC_ACQ0_SAMPLING_TIME_80_ADCCLK                    (0x8U << ADC_ACQ0_CR_SMTS_Pos)
#define    FL_ADC_ACQ0_SAMPLING_TIME_96_ADCCLK                    (0x9U << ADC_ACQ0_CR_SMTS_Pos)
#define    FL_ADC_ACQ0_SAMPLING_TIME_128_ADCCLK                   (0xaU << ADC_ACQ0_CR_SMTS_Pos)
#define    FL_ADC_ACQ0_SAMPLING_TIME_160_ADCCLK                   (0xbU << ADC_ACQ0_CR_SMTS_Pos)
#define    FL_ADC_ACQ0_SAMPLING_TIME_192_ADCCLK                   (0xcU << ADC_ACQ0_CR_SMTS_Pos)
#define    FL_ADC_ACQ0_SAMPLING_TIME_256_ADCCLK                   (0xdU << ADC_ACQ0_CR_SMTS_Pos)
#define    FL_ADC_ACQ0_SAMPLING_TIME_320_ADCCLK                   (0xeU << ADC_ACQ0_CR_SMTS_Pos)
#define    FL_ADC_ACQ0_SAMPLING_TIME_512_ADCCLK                   (0xfU << ADC_ACQ0_CR_SMTS_Pos)

#define    FL_ADC_ACQ1_SELECT_CHANNEL_ADC_INA0                    (0x0U << ADC_ACQ1_CR_CHSEL_Pos)
#define    FL_ADC_ACQ1_SELECT_CHANNEL_ADC_INA1                    (0x1U << ADC_ACQ1_CR_CHSEL_Pos)
#define    FL_ADC_ACQ1_SELECT_CHANNEL_ADC_INA2                    (0x2U << ADC_ACQ1_CR_CHSEL_Pos)
#define    FL_ADC_ACQ1_SELECT_CHANNEL_ADC_INA3                    (0x3U << ADC_ACQ1_CR_CHSEL_Pos)
#define    FL_ADC_ACQ1_SELECT_CHANNEL_ADC_INA4                    (0x4U << ADC_ACQ1_CR_CHSEL_Pos)
#define    FL_ADC_ACQ1_SELECT_CHANNEL_ADC_INA5                    (0x5U << ADC_ACQ1_CR_CHSEL_Pos)
#define    FL_ADC_ACQ1_SELECT_CHANNEL_ADC_INA6                    (0x6U << ADC_ACQ1_CR_CHSEL_Pos)
#define    FL_ADC_ACQ1_SELECT_CHANNEL_ADC_INA7                    (0x7U << ADC_ACQ1_CR_CHSEL_Pos)
#define    FL_ADC_ACQ1_SELECT_CHANNEL_ADC_INB8_OPA0_OUT           (0x8U << ADC_ACQ1_CR_CHSEL_Pos)
#define    FL_ADC_ACQ1_SELECT_CHANNEL_TS                          (0x9U << ADC_ACQ1_CR_CHSEL_Pos)
#define    FL_ADC_ACQ1_SELECT_CHANNEL_AVREF                       (0xaU << ADC_ACQ1_CR_CHSEL_Pos)
#define    FL_ADC_ACQ1_SELECT_CHANNEL_P_CALIBRATION               (0xcU << ADC_ACQ1_CR_CHSEL_Pos)
#define    FL_ADC_ACQ1_SELECT_CHANNEL_ADC_INB0                    (0x10U << ADC_ACQ1_CR_CHSEL_Pos)
#define    FL_ADC_ACQ1_SELECT_CHANNEL_ADC_INB1                    (0x11U << ADC_ACQ1_CR_CHSEL_Pos)
#define    FL_ADC_ACQ1_SELECT_CHANNEL_ADC_INB2                    (0x12U << ADC_ACQ1_CR_CHSEL_Pos)
#define    FL_ADC_ACQ1_SELECT_CHANNEL_ADC_INB3                    (0x13U << ADC_ACQ1_CR_CHSEL_Pos)
#define    FL_ADC_ACQ1_SELECT_CHANNEL_ADC_INB4                    (0x14U << ADC_ACQ1_CR_CHSEL_Pos)
#define    FL_ADC_ACQ1_SELECT_CHANNEL_ADC_INB5                    (0x15U << ADC_ACQ1_CR_CHSEL_Pos)
#define    FL_ADC_ACQ1_SELECT_CHANNEL_ADC_INB6                    (0x16U << ADC_ACQ1_CR_CHSEL_Pos)
#define    FL_ADC_ACQ1_SELECT_CHANNEL_ADC_INB7                    (0x17U << ADC_ACQ1_CR_CHSEL_Pos)
#define    FL_ADC_ACQ1_SELECT_CHANNEL_ADC_INB8_OPA1_OUT           (0x18U << ADC_ACQ1_CR_CHSEL_Pos)
#define    FL_ADC_ACQ1_SELECT_CHANNEL_VBAT_DIV3                  (0x19U << ADC_ACQ1_CR_CHSEL_Pos)
#define    FL_ADC_ACQ1_SELECT_CHANNEL_DAC1_OUT1                   (0x1aU << ADC_ACQ1_CR_CHSEL_Pos)
#define    FL_ADC_ACQ1_SELECT_CHANNEL_N_CALIBRATION               (0x1cU << ADC_ACQ1_CR_CHSEL_Pos)

#define    FL_ADC_ACQ1_TRGI_SOFE_TRG                              (0x0U << ADC_ACQ1_CR_TRIGSEL_Pos)
#define    FL_ADC_ACQ1_TRGI_LUT0_TRG                              (0x1U << ADC_ACQ1_CR_TRIGSEL_Pos)
#define    FL_ADC_ACQ1_TRGI_LUT1_TRG                              (0x2U << ADC_ACQ1_CR_TRIGSEL_Pos)
#define    FL_ADC_ACQ1_TRGI_LUT2_TRG                              (0x3U << ADC_ACQ1_CR_TRIGSEL_Pos)
#define    FL_ADC_ACQ1_TRGI_LUT3_TRG                              (0x4U << ADC_ACQ1_CR_TRIGSEL_Pos)
#define    FL_ADC_ACQ1_TRGI_ATIM0_TRGO                            (0x5U << ADC_ACQ1_CR_TRIGSEL_Pos)
#define    FL_ADC_ACQ1_TRGI_ATIM1_TRGO                            (0x6U << ADC_ACQ1_CR_TRIGSEL_Pos)
#define    FL_ADC_ACQ1_TRGI_ATIM0_TRGO2                           (0x7U << ADC_ACQ1_CR_TRIGSEL_Pos)
#define    FL_ADC_ACQ1_TRGI_ATIM1_TRGO2                           (0x8U << ADC_ACQ1_CR_TRIGSEL_Pos)
#define    FL_ADC_ACQ1_TRGI_GPTIM0_TRGO                           (0x9U << ADC_ACQ1_CR_TRIGSEL_Pos)
#define    FL_ADC_ACQ1_TRGI_GPTIM1_TRGO                           (0xaU << ADC_ACQ1_CR_TRIGSEL_Pos)
#define    FL_ADC_ACQ1_TRGI_GPTIM2_TRGO                           (0xbU << ADC_ACQ1_CR_TRIGSEL_Pos)
#define    FL_ADC_ACQ1_TRGI_EPWM0SOCA                             (0xcU << ADC_ACQ1_CR_TRIGSEL_Pos)
#define    FL_ADC_ACQ1_TRGI_EPWM0SOCB                             (0xdU << ADC_ACQ1_CR_TRIGSEL_Pos)
#define    FL_ADC_ACQ1_TRGI_EPWM1SOCA                             (0xeU << ADC_ACQ1_CR_TRIGSEL_Pos)
#define    FL_ADC_ACQ1_TRGI_EPWM1SOCB                             (0xfU << ADC_ACQ1_CR_TRIGSEL_Pos)
#define    FL_ADC_ACQ1_TRGI_EPWM2SOCA                             (0x10U << ADC_ACQ1_CR_TRIGSEL_Pos)
#define    FL_ADC_ACQ1_TRGI_EPWM2SOCB                             (0x11U << ADC_ACQ1_CR_TRIGSEL_Pos)
#define    FL_ADC_ACQ1_TRGI_EPWM3SOCA                             (0x12U << ADC_ACQ1_CR_TRIGSEL_Pos)
#define    FL_ADC_ACQ1_TRGI_EPWM3SOCB                             (0x13U << ADC_ACQ1_CR_TRIGSEL_Pos)
#define    FL_ADC_ACQ1_TRGI_COMP0_TRGO                            (0x14U << ADC_ACQ1_CR_TRIGSEL_Pos)
#define    FL_ADC_ACQ1_TRGI_COMP1_TRGO                            (0x15U << ADC_ACQ1_CR_TRIGSEL_Pos)
#define    FL_ADC_ACQ1_TRGI_COMP2_TRGO                            (0x16U << ADC_ACQ1_CR_TRIGSEL_Pos)
#define    FL_ADC_ACQ1_TRGI_LPTIM0_TRGO                           (0x17U << ADC_ACQ1_CR_TRIGSEL_Pos)
#define    FL_ADC_ACQ1_TRGI_BSTIM0_TRGO                           (0x18U << ADC_ACQ1_CR_TRIGSEL_Pos)

#define    FL_ADC_ACQ1_SAMPLING_TIME_1_ADCCLK                     (0x0U << ADC_ACQ1_CR_SMTS_Pos)
#define    FL_ADC_ACQ1_SAMPLING_TIME_2_ADCCLK                     (0x1U << ADC_ACQ1_CR_SMTS_Pos)
#define    FL_ADC_ACQ1_SAMPLING_TIME_4_ADCCLK                     (0x2U << ADC_ACQ1_CR_SMTS_Pos)
#define    FL_ADC_ACQ1_SAMPLING_TIME_8_ADCCLK                     (0x3U << ADC_ACQ1_CR_SMTS_Pos)
#define    FL_ADC_ACQ1_SAMPLING_TIME_12_ADCCLK                    (0x4U << ADC_ACQ1_CR_SMTS_Pos)
#define    FL_ADC_ACQ1_SAMPLING_TIME_16_ADCCLK                    (0x5U << ADC_ACQ1_CR_SMTS_Pos)
#define    FL_ADC_ACQ1_SAMPLING_TIME_32_ADCCLK                    (0x6U << ADC_ACQ1_CR_SMTS_Pos)
#define    FL_ADC_ACQ1_SAMPLING_TIME_64_ADCCLK                    (0x7U << ADC_ACQ1_CR_SMTS_Pos)
#define    FL_ADC_ACQ1_SAMPLING_TIME_80_ADCCLK                    (0x8U << ADC_ACQ1_CR_SMTS_Pos)
#define    FL_ADC_ACQ1_SAMPLING_TIME_96_ADCCLK                    (0x9U << ADC_ACQ1_CR_SMTS_Pos)
#define    FL_ADC_ACQ1_SAMPLING_TIME_128_ADCCLK                   (0xaU << ADC_ACQ1_CR_SMTS_Pos)
#define    FL_ADC_ACQ1_SAMPLING_TIME_160_ADCCLK                   (0xbU << ADC_ACQ1_CR_SMTS_Pos)
#define    FL_ADC_ACQ1_SAMPLING_TIME_192_ADCCLK                   (0xcU << ADC_ACQ1_CR_SMTS_Pos)
#define    FL_ADC_ACQ1_SAMPLING_TIME_256_ADCCLK                   (0xdU << ADC_ACQ1_CR_SMTS_Pos)
#define    FL_ADC_ACQ1_SAMPLING_TIME_320_ADCCLK                   (0xeU << ADC_ACQ1_CR_SMTS_Pos)
#define    FL_ADC_ACQ1_SAMPLING_TIME_512_ADCCLK                   (0xfU << ADC_ACQ1_CR_SMTS_Pos)

#define    FL_ADC_ACQ2_SELECT_CHANNEL_ADC_INA0                    (0x0U << ADC_ACQ2_CR_CHSEL_Pos)
#define    FL_ADC_ACQ2_SELECT_CHANNEL_ADC_INA1                    (0x1U << ADC_ACQ2_CR_CHSEL_Pos)
#define    FL_ADC_ACQ2_SELECT_CHANNEL_ADC_INA2                    (0x2U << ADC_ACQ2_CR_CHSEL_Pos)
#define    FL_ADC_ACQ2_SELECT_CHANNEL_ADC_INA3                    (0x3U << ADC_ACQ2_CR_CHSEL_Pos)
#define    FL_ADC_ACQ2_SELECT_CHANNEL_ADC_INA4                    (0x4U << ADC_ACQ2_CR_CHSEL_Pos)
#define    FL_ADC_ACQ2_SELECT_CHANNEL_ADC_INA5                    (0x5U << ADC_ACQ2_CR_CHSEL_Pos)
#define    FL_ADC_ACQ2_SELECT_CHANNEL_ADC_INA6                    (0x6U << ADC_ACQ2_CR_CHSEL_Pos)
#define    FL_ADC_ACQ2_SELECT_CHANNEL_ADC_INA7                    (0x7U << ADC_ACQ2_CR_CHSEL_Pos)
#define    FL_ADC_ACQ2_SELECT_CHANNEL_ADC_INB8_OPA0_OUT           (0x8U << ADC_ACQ2_CR_CHSEL_Pos)
#define    FL_ADC_ACQ2_SELECT_CHANNEL_TS                          (0x9U << ADC_ACQ2_CR_CHSEL_Pos)
#define    FL_ADC_ACQ2_SELECT_CHANNEL_AVREF                       (0xaU << ADC_ACQ2_CR_CHSEL_Pos)
#define    FL_ADC_ACQ2_SELECT_CHANNEL_P_CALIBRATION               (0xcU << ADC_ACQ2_CR_CHSEL_Pos)
#define    FL_ADC_ACQ2_SELECT_CHANNEL_ADC_INB0                    (0x10U << ADC_ACQ2_CR_CHSEL_Pos)
#define    FL_ADC_ACQ2_SELECT_CHANNEL_ADC_INB1                    (0x11U << ADC_ACQ2_CR_CHSEL_Pos)
#define    FL_ADC_ACQ2_SELECT_CHANNEL_ADC_INB2                    (0x12U << ADC_ACQ2_CR_CHSEL_Pos)
#define    FL_ADC_ACQ2_SELECT_CHANNEL_ADC_INB3                    (0x13U << ADC_ACQ2_CR_CHSEL_Pos)
#define    FL_ADC_ACQ2_SELECT_CHANNEL_ADC_INB4                    (0x14U << ADC_ACQ2_CR_CHSEL_Pos)
#define    FL_ADC_ACQ2_SELECT_CHANNEL_ADC_INB5                    (0x15U << ADC_ACQ2_CR_CHSEL_Pos)
#define    FL_ADC_ACQ2_SELECT_CHANNEL_ADC_INB6                    (0x16U << ADC_ACQ2_CR_CHSEL_Pos)
#define    FL_ADC_ACQ2_SELECT_CHANNEL_ADC_INB7                    (0x17U << ADC_ACQ2_CR_CHSEL_Pos)
#define    FL_ADC_ACQ2_SELECT_CHANNEL_ADC_INB8_OPA1_OUT           (0x18U << ADC_ACQ2_CR_CHSEL_Pos)
#define    FL_ADC_ACQ2_SELECT_CHANNEL_VBAT_DIV3                  (0x19U << ADC_ACQ2_CR_CHSEL_Pos)
#define    FL_ADC_ACQ2_SELECT_CHANNEL_DAC1_OUT1                   (0x1aU << ADC_ACQ2_CR_CHSEL_Pos)
#define    FL_ADC_ACQ2_SELECT_CHANNEL_N_CALIBRATION               (0x1cU << ADC_ACQ2_CR_CHSEL_Pos)

#define    FL_ADC_ACQ2_TRGI_SOFE_TRG                              (0x0U << ADC_ACQ2_CR_TRIGSEL_Pos)
#define    FL_ADC_ACQ2_TRGI_LUT0_TRG                              (0x1U << ADC_ACQ2_CR_TRIGSEL_Pos)
#define    FL_ADC_ACQ2_TRGI_LUT1_TRG                              (0x2U << ADC_ACQ2_CR_TRIGSEL_Pos)
#define    FL_ADC_ACQ2_TRGI_LUT2_TRG                              (0x3U << ADC_ACQ2_CR_TRIGSEL_Pos)
#define    FL_ADC_ACQ2_TRGI_LUT3_TRG                              (0x4U << ADC_ACQ2_CR_TRIGSEL_Pos)
#define    FL_ADC_ACQ2_TRGI_ATIM0_TRGO                            (0x5U << ADC_ACQ2_CR_TRIGSEL_Pos)
#define    FL_ADC_ACQ2_TRGI_ATIM1_TRGO                            (0x6U << ADC_ACQ2_CR_TRIGSEL_Pos)
#define    FL_ADC_ACQ2_TRGI_ATIM0_TRGO2                           (0x7U << ADC_ACQ2_CR_TRIGSEL_Pos)
#define    FL_ADC_ACQ2_TRGI_ATIM1_TRGO2                           (0x8U << ADC_ACQ2_CR_TRIGSEL_Pos)
#define    FL_ADC_ACQ2_TRGI_GPTIM0_TRGO                           (0x9U << ADC_ACQ2_CR_TRIGSEL_Pos)
#define    FL_ADC_ACQ2_TRGI_GPTIM1_TRGO                           (0xaU << ADC_ACQ2_CR_TRIGSEL_Pos)
#define    FL_ADC_ACQ2_TRGI_GPTIM2_TRGO                           (0xbU << ADC_ACQ2_CR_TRIGSEL_Pos)
#define    FL_ADC_ACQ2_TRGI_EPWM0SOCA                             (0xcU << ADC_ACQ2_CR_TRIGSEL_Pos)
#define    FL_ADC_ACQ2_TRGI_EPWM0SOCB                             (0xdU << ADC_ACQ2_CR_TRIGSEL_Pos)
#define    FL_ADC_ACQ2_TRGI_EPWM1SOCA                             (0xeU << ADC_ACQ2_CR_TRIGSEL_Pos)
#define    FL_ADC_ACQ2_TRGI_EPWM1SOCB                             (0xfU << ADC_ACQ2_CR_TRIGSEL_Pos)
#define    FL_ADC_ACQ2_TRGI_EPWM2SOCA                             (0x10U << ADC_ACQ2_CR_TRIGSEL_Pos)
#define    FL_ADC_ACQ2_TRGI_EPWM2SOCB                             (0x11U << ADC_ACQ2_CR_TRIGSEL_Pos)
#define    FL_ADC_ACQ2_TRGI_EPWM3SOCA                             (0x12U << ADC_ACQ2_CR_TRIGSEL_Pos)
#define    FL_ADC_ACQ2_TRGI_EPWM3SOCB                             (0x13U << ADC_ACQ2_CR_TRIGSEL_Pos)
#define    FL_ADC_ACQ2_TRGI_COMP0_TRGO                            (0x14U << ADC_ACQ2_CR_TRIGSEL_Pos)
#define    FL_ADC_ACQ2_TRGI_COMP1_TRGO                            (0x15U << ADC_ACQ2_CR_TRIGSEL_Pos)
#define    FL_ADC_ACQ2_TRGI_COMP2_TRGO                            (0x16U << ADC_ACQ2_CR_TRIGSEL_Pos)
#define    FL_ADC_ACQ2_TRGI_LPTIM0_TRGO                           (0x17U << ADC_ACQ2_CR_TRIGSEL_Pos)
#define    FL_ADC_ACQ2_TRGI_BSTIM0_TRGO                           (0x18U << ADC_ACQ2_CR_TRIGSEL_Pos)

#define    FL_ADC_ACQ2_SAMPLING_TIME_1_ADCCLK                     (0x0U << ADC_ACQ2_CR_SMTS_Pos)
#define    FL_ADC_ACQ2_SAMPLING_TIME_2_ADCCLK                     (0x1U << ADC_ACQ2_CR_SMTS_Pos)
#define    FL_ADC_ACQ2_SAMPLING_TIME_4_ADCCLK                     (0x2U << ADC_ACQ2_CR_SMTS_Pos)
#define    FL_ADC_ACQ2_SAMPLING_TIME_8_ADCCLK                     (0x3U << ADC_ACQ2_CR_SMTS_Pos)
#define    FL_ADC_ACQ2_SAMPLING_TIME_12_ADCCLK                    (0x4U << ADC_ACQ2_CR_SMTS_Pos)
#define    FL_ADC_ACQ2_SAMPLING_TIME_16_ADCCLK                    (0x5U << ADC_ACQ2_CR_SMTS_Pos)
#define    FL_ADC_ACQ2_SAMPLING_TIME_32_ADCCLK                    (0x6U << ADC_ACQ2_CR_SMTS_Pos)
#define    FL_ADC_ACQ2_SAMPLING_TIME_64_ADCCLK                    (0x7U << ADC_ACQ2_CR_SMTS_Pos)
#define    FL_ADC_ACQ2_SAMPLING_TIME_80_ADCCLK                    (0x8U << ADC_ACQ2_CR_SMTS_Pos)
#define    FL_ADC_ACQ2_SAMPLING_TIME_96_ADCCLK                    (0x9U << ADC_ACQ2_CR_SMTS_Pos)
#define    FL_ADC_ACQ2_SAMPLING_TIME_128_ADCCLK                   (0xaU << ADC_ACQ2_CR_SMTS_Pos)
#define    FL_ADC_ACQ2_SAMPLING_TIME_160_ADCCLK                   (0xbU << ADC_ACQ2_CR_SMTS_Pos)
#define    FL_ADC_ACQ2_SAMPLING_TIME_192_ADCCLK                   (0xcU << ADC_ACQ2_CR_SMTS_Pos)
#define    FL_ADC_ACQ2_SAMPLING_TIME_256_ADCCLK                   (0xdU << ADC_ACQ2_CR_SMTS_Pos)
#define    FL_ADC_ACQ2_SAMPLING_TIME_320_ADCCLK                   (0xeU << ADC_ACQ2_CR_SMTS_Pos)
#define    FL_ADC_ACQ2_SAMPLING_TIME_512_ADCCLK                   (0xfU << ADC_ACQ2_CR_SMTS_Pos)

#define    FL_ADC_ACQ3_SELECT_CHANNEL_ADC_INA0                    (0x0U << ADC_ACQ3_CR_CHSEL_Pos)
#define    FL_ADC_ACQ3_SELECT_CHANNEL_ADC_INA1                    (0x1U << ADC_ACQ3_CR_CHSEL_Pos)
#define    FL_ADC_ACQ3_SELECT_CHANNEL_ADC_INA2                    (0x2U << ADC_ACQ3_CR_CHSEL_Pos)
#define    FL_ADC_ACQ3_SELECT_CHANNEL_ADC_INA3                    (0x3U << ADC_ACQ3_CR_CHSEL_Pos)
#define    FL_ADC_ACQ3_SELECT_CHANNEL_ADC_INA4                    (0x4U << ADC_ACQ3_CR_CHSEL_Pos)
#define    FL_ADC_ACQ3_SELECT_CHANNEL_ADC_INA5                    (0x5U << ADC_ACQ3_CR_CHSEL_Pos)
#define    FL_ADC_ACQ3_SELECT_CHANNEL_ADC_INA6                    (0x6U << ADC_ACQ3_CR_CHSEL_Pos)
#define    FL_ADC_ACQ3_SELECT_CHANNEL_ADC_INA7                    (0x7U << ADC_ACQ3_CR_CHSEL_Pos)
#define    FL_ADC_ACQ3_SELECT_CHANNEL_ADC_INB8_OPA0_OUT           (0x8U << ADC_ACQ3_CR_CHSEL_Pos)
#define    FL_ADC_ACQ3_SELECT_CHANNEL_TS                          (0x9U << ADC_ACQ3_CR_CHSEL_Pos)
#define    FL_ADC_ACQ3_SELECT_CHANNEL_AVREF                       (0xaU << ADC_ACQ3_CR_CHSEL_Pos)
#define    FL_ADC_ACQ3_SELECT_CHANNEL_P_CALIBRATION               (0xcU << ADC_ACQ3_CR_CHSEL_Pos)
#define    FL_ADC_ACQ3_SELECT_CHANNEL_ADC_INB0                    (0x10U << ADC_ACQ3_CR_CHSEL_Pos)
#define    FL_ADC_ACQ3_SELECT_CHANNEL_ADC_INB1                    (0x11U << ADC_ACQ3_CR_CHSEL_Pos)
#define    FL_ADC_ACQ3_SELECT_CHANNEL_ADC_INB2                    (0x12U << ADC_ACQ3_CR_CHSEL_Pos)
#define    FL_ADC_ACQ3_SELECT_CHANNEL_ADC_INB3                    (0x13U << ADC_ACQ3_CR_CHSEL_Pos)
#define    FL_ADC_ACQ3_SELECT_CHANNEL_ADC_INB4                    (0x14U << ADC_ACQ3_CR_CHSEL_Pos)
#define    FL_ADC_ACQ3_SELECT_CHANNEL_ADC_INB5                    (0x15U << ADC_ACQ3_CR_CHSEL_Pos)
#define    FL_ADC_ACQ3_SELECT_CHANNEL_ADC_INB6                    (0x16U << ADC_ACQ3_CR_CHSEL_Pos)
#define    FL_ADC_ACQ3_SELECT_CHANNEL_ADC_INB7                    (0x17U << ADC_ACQ3_CR_CHSEL_Pos)
#define    FL_ADC_ACQ3_SELECT_CHANNEL_ADC_INB8_OPA1_OUT           (0x18U << ADC_ACQ3_CR_CHSEL_Pos)
#define    FL_ADC_ACQ3_SELECT_CHANNEL_VBAT_DIV3                  (0x19U << ADC_ACQ3_CR_CHSEL_Pos)
#define    FL_ADC_ACQ3_SELECT_CHANNEL_DAC1_OUT1                   (0x1aU << ADC_ACQ3_CR_CHSEL_Pos)
#define    FL_ADC_ACQ3_SELECT_CHANNEL_N_CALIBRATION               (0x1cU << ADC_ACQ3_CR_CHSEL_Pos)

#define    FL_ADC_ACQ3_TRGI_SOFE_TRG                              (0x0U << ADC_ACQ3_CR_TRIGSEL_Pos)
#define    FL_ADC_ACQ3_TRGI_LUT0_TRG                              (0x1U << ADC_ACQ3_CR_TRIGSEL_Pos)
#define    FL_ADC_ACQ3_TRGI_LUT1_TRG                              (0x2U << ADC_ACQ3_CR_TRIGSEL_Pos)
#define    FL_ADC_ACQ3_TRGI_LUT2_TRG                              (0x3U << ADC_ACQ3_CR_TRIGSEL_Pos)
#define    FL_ADC_ACQ3_TRGI_LUT3_TRG                              (0x4U << ADC_ACQ3_CR_TRIGSEL_Pos)
#define    FL_ADC_ACQ3_TRGI_ATIM0_TRGO                            (0x5U << ADC_ACQ3_CR_TRIGSEL_Pos)
#define    FL_ADC_ACQ3_TRGI_ATIM1_TRGO                            (0x6U << ADC_ACQ3_CR_TRIGSEL_Pos)
#define    FL_ADC_ACQ3_TRGI_ATIM0_TRGO2                           (0x7U << ADC_ACQ3_CR_TRIGSEL_Pos)
#define    FL_ADC_ACQ3_TRGI_ATIM1_TRGO2                           (0x8U << ADC_ACQ3_CR_TRIGSEL_Pos)
#define    FL_ADC_ACQ3_TRGI_GPTIM0_TRGO                           (0x9U << ADC_ACQ3_CR_TRIGSEL_Pos)
#define    FL_ADC_ACQ3_TRGI_GPTIM1_TRGO                           (0xaU << ADC_ACQ3_CR_TRIGSEL_Pos)
#define    FL_ADC_ACQ3_TRGI_GPTIM2_TRGO                           (0xbU << ADC_ACQ3_CR_TRIGSEL_Pos)
#define    FL_ADC_ACQ3_TRGI_EPWM0SOCA                             (0xcU << ADC_ACQ3_CR_TRIGSEL_Pos)
#define    FL_ADC_ACQ3_TRGI_EPWM0SOCB                             (0xdU << ADC_ACQ3_CR_TRIGSEL_Pos)
#define    FL_ADC_ACQ3_TRGI_EPWM1SOCA                             (0xeU << ADC_ACQ3_CR_TRIGSEL_Pos)
#define    FL_ADC_ACQ3_TRGI_EPWM1SOCB                             (0xfU << ADC_ACQ3_CR_TRIGSEL_Pos)
#define    FL_ADC_ACQ3_TRGI_EPWM2SOCA                             (0x10U << ADC_ACQ3_CR_TRIGSEL_Pos)
#define    FL_ADC_ACQ3_TRGI_EPWM2SOCB                             (0x11U << ADC_ACQ3_CR_TRIGSEL_Pos)
#define    FL_ADC_ACQ3_TRGI_EPWM3SOCA                             (0x12U << ADC_ACQ3_CR_TRIGSEL_Pos)
#define    FL_ADC_ACQ3_TRGI_EPWM3SOCB                             (0x13U << ADC_ACQ3_CR_TRIGSEL_Pos)
#define    FL_ADC_ACQ3_TRGI_COMP0_TRGO                            (0x14U << ADC_ACQ3_CR_TRIGSEL_Pos)
#define    FL_ADC_ACQ3_TRGI_COMP1_TRGO                            (0x15U << ADC_ACQ3_CR_TRIGSEL_Pos)
#define    FL_ADC_ACQ3_TRGI_COMP2_TRGO                            (0x16U << ADC_ACQ3_CR_TRIGSEL_Pos)
#define    FL_ADC_ACQ3_TRGI_LPTIM0_TRGO                           (0x17U << ADC_ACQ3_CR_TRIGSEL_Pos)
#define    FL_ADC_ACQ3_TRGI_BSTIM0_TRGO                           (0x18U << ADC_ACQ3_CR_TRIGSEL_Pos)

#define    FL_ADC_ACQ3_SAMPLING_TIME_1_ADCCLK                     (0x0U << ADC_ACQ3_CR_SMTS_Pos)
#define    FL_ADC_ACQ3_SAMPLING_TIME_2_ADCCLK                     (0x1U << ADC_ACQ3_CR_SMTS_Pos)
#define    FL_ADC_ACQ3_SAMPLING_TIME_4_ADCCLK                     (0x2U << ADC_ACQ3_CR_SMTS_Pos)
#define    FL_ADC_ACQ3_SAMPLING_TIME_8_ADCCLK                     (0x3U << ADC_ACQ3_CR_SMTS_Pos)
#define    FL_ADC_ACQ3_SAMPLING_TIME_12_ADCCLK                    (0x4U << ADC_ACQ3_CR_SMTS_Pos)
#define    FL_ADC_ACQ3_SAMPLING_TIME_16_ADCCLK                    (0x5U << ADC_ACQ3_CR_SMTS_Pos)
#define    FL_ADC_ACQ3_SAMPLING_TIME_32_ADCCLK                    (0x6U << ADC_ACQ3_CR_SMTS_Pos)
#define    FL_ADC_ACQ3_SAMPLING_TIME_64_ADCCLK                    (0x7U << ADC_ACQ3_CR_SMTS_Pos)
#define    FL_ADC_ACQ3_SAMPLING_TIME_80_ADCCLK                    (0x8U << ADC_ACQ3_CR_SMTS_Pos)
#define    FL_ADC_ACQ3_SAMPLING_TIME_96_ADCCLK                    (0x9U << ADC_ACQ3_CR_SMTS_Pos)
#define    FL_ADC_ACQ3_SAMPLING_TIME_128_ADCCLK                   (0xaU << ADC_ACQ3_CR_SMTS_Pos)
#define    FL_ADC_ACQ3_SAMPLING_TIME_160_ADCCLK                   (0xbU << ADC_ACQ3_CR_SMTS_Pos)
#define    FL_ADC_ACQ3_SAMPLING_TIME_192_ADCCLK                   (0xcU << ADC_ACQ3_CR_SMTS_Pos)
#define    FL_ADC_ACQ3_SAMPLING_TIME_256_ADCCLK                   (0xdU << ADC_ACQ3_CR_SMTS_Pos)
#define    FL_ADC_ACQ3_SAMPLING_TIME_320_ADCCLK                   (0xeU << ADC_ACQ3_CR_SMTS_Pos)
#define    FL_ADC_ACQ3_SAMPLING_TIME_512_ADCCLK                   (0xfU << ADC_ACQ3_CR_SMTS_Pos)

#define    FL_ADC_ACQ4_SELECT_CHANNEL_ADC_INA0                    (0x0U << ADC_ACQ4_CR_CHSEL_Pos)
#define    FL_ADC_ACQ4_SELECT_CHANNEL_ADC_INA1                    (0x1U << ADC_ACQ4_CR_CHSEL_Pos)
#define    FL_ADC_ACQ4_SELECT_CHANNEL_ADC_INA2                    (0x2U << ADC_ACQ4_CR_CHSEL_Pos)
#define    FL_ADC_ACQ4_SELECT_CHANNEL_ADC_INA3                    (0x3U << ADC_ACQ4_CR_CHSEL_Pos)
#define    FL_ADC_ACQ4_SELECT_CHANNEL_ADC_INA4                    (0x4U << ADC_ACQ4_CR_CHSEL_Pos)
#define    FL_ADC_ACQ4_SELECT_CHANNEL_ADC_INA5                    (0x5U << ADC_ACQ4_CR_CHSEL_Pos)
#define    FL_ADC_ACQ4_SELECT_CHANNEL_ADC_INA6                    (0x6U << ADC_ACQ4_CR_CHSEL_Pos)
#define    FL_ADC_ACQ4_SELECT_CHANNEL_ADC_INA7                    (0x7U << ADC_ACQ4_CR_CHSEL_Pos)
#define    FL_ADC_ACQ4_SELECT_CHANNEL_ADC_INB8_OPA0_OUT           (0x8U << ADC_ACQ4_CR_CHSEL_Pos)
#define    FL_ADC_ACQ4_SELECT_CHANNEL_TS                          (0x9U << ADC_ACQ4_CR_CHSEL_Pos)
#define    FL_ADC_ACQ4_SELECT_CHANNEL_AVREF                       (0xaU << ADC_ACQ4_CR_CHSEL_Pos)
#define    FL_ADC_ACQ4_SELECT_CHANNEL_P_CALIBRATION               (0xcU << ADC_ACQ4_CR_CHSEL_Pos)
#define    FL_ADC_ACQ4_SELECT_CHANNEL_ADC_INB0                    (0x10U << ADC_ACQ4_CR_CHSEL_Pos)
#define    FL_ADC_ACQ4_SELECT_CHANNEL_ADC_INB1                    (0x11U << ADC_ACQ4_CR_CHSEL_Pos)
#define    FL_ADC_ACQ4_SELECT_CHANNEL_ADC_INB2                    (0x12U << ADC_ACQ4_CR_CHSEL_Pos)
#define    FL_ADC_ACQ4_SELECT_CHANNEL_ADC_INB3                    (0x13U << ADC_ACQ4_CR_CHSEL_Pos)
#define    FL_ADC_ACQ4_SELECT_CHANNEL_ADC_INB4                    (0x14U << ADC_ACQ4_CR_CHSEL_Pos)
#define    FL_ADC_ACQ4_SELECT_CHANNEL_ADC_INB5                    (0x15U << ADC_ACQ4_CR_CHSEL_Pos)
#define    FL_ADC_ACQ4_SELECT_CHANNEL_ADC_INB6                    (0x16U << ADC_ACQ4_CR_CHSEL_Pos)
#define    FL_ADC_ACQ4_SELECT_CHANNEL_ADC_INB7                    (0x17U << ADC_ACQ4_CR_CHSEL_Pos)
#define    FL_ADC_ACQ4_SELECT_CHANNEL_ADC_INB8_OPA1_OUT           (0x18U << ADC_ACQ4_CR_CHSEL_Pos)
#define    FL_ADC_ACQ4_SELECT_CHANNEL_VBAT_DIV3                  (0x19U << ADC_ACQ4_CR_CHSEL_Pos)
#define    FL_ADC_ACQ4_SELECT_CHANNEL_DAC1_OUT1                   (0x1aU << ADC_ACQ4_CR_CHSEL_Pos)
#define    FL_ADC_ACQ4_SELECT_CHANNEL_N_CALIBRATION               (0x1cU << ADC_ACQ4_CR_CHSEL_Pos)

#define    FL_ADC_ACQ4_TRGI_SOFE_TRG                              (0x0U << ADC_ACQ4_CR_TRIGSEL_Pos)
#define    FL_ADC_ACQ4_TRGI_LUT0_TRG                              (0x1U << ADC_ACQ4_CR_TRIGSEL_Pos)
#define    FL_ADC_ACQ4_TRGI_LUT1_TRG                              (0x2U << ADC_ACQ4_CR_TRIGSEL_Pos)
#define    FL_ADC_ACQ4_TRGI_LUT2_TRG                              (0x3U << ADC_ACQ4_CR_TRIGSEL_Pos)
#define    FL_ADC_ACQ4_TRGI_LUT3_TRG                              (0x4U << ADC_ACQ4_CR_TRIGSEL_Pos)
#define    FL_ADC_ACQ4_TRGI_ATIM0_TRGO                            (0x5U << ADC_ACQ4_CR_TRIGSEL_Pos)
#define    FL_ADC_ACQ4_TRGI_ATIM1_TRGO                            (0x6U << ADC_ACQ4_CR_TRIGSEL_Pos)
#define    FL_ADC_ACQ4_TRGI_ATIM0_TRGO2                           (0x7U << ADC_ACQ4_CR_TRIGSEL_Pos)
#define    FL_ADC_ACQ4_TRGI_ATIM1_TRGO2                           (0x8U << ADC_ACQ4_CR_TRIGSEL_Pos)
#define    FL_ADC_ACQ4_TRGI_GPTIM0_TRGO                           (0x9U << ADC_ACQ4_CR_TRIGSEL_Pos)
#define    FL_ADC_ACQ4_TRGI_GPTIM1_TRGO                           (0xaU << ADC_ACQ4_CR_TRIGSEL_Pos)
#define    FL_ADC_ACQ4_TRGI_GPTIM2_TRGO                           (0xbU << ADC_ACQ4_CR_TRIGSEL_Pos)
#define    FL_ADC_ACQ4_TRGI_EPWM0SOCA                             (0xcU << ADC_ACQ4_CR_TRIGSEL_Pos)
#define    FL_ADC_ACQ4_TRGI_EPWM0SOCB                             (0xdU << ADC_ACQ4_CR_TRIGSEL_Pos)
#define    FL_ADC_ACQ4_TRGI_EPWM1SOCA                             (0xeU << ADC_ACQ4_CR_TRIGSEL_Pos)
#define    FL_ADC_ACQ4_TRGI_EPWM1SOCB                             (0xfU << ADC_ACQ4_CR_TRIGSEL_Pos)
#define    FL_ADC_ACQ4_TRGI_EPWM2SOCA                             (0x10U << ADC_ACQ4_CR_TRIGSEL_Pos)
#define    FL_ADC_ACQ4_TRGI_EPWM2SOCB                             (0x11U << ADC_ACQ4_CR_TRIGSEL_Pos)
#define    FL_ADC_ACQ4_TRGI_EPWM3SOCA                             (0x12U << ADC_ACQ4_CR_TRIGSEL_Pos)
#define    FL_ADC_ACQ4_TRGI_EPWM3SOCB                             (0x13U << ADC_ACQ4_CR_TRIGSEL_Pos)
#define    FL_ADC_ACQ4_TRGI_COMP0_TRGO                            (0x14U << ADC_ACQ4_CR_TRIGSEL_Pos)
#define    FL_ADC_ACQ4_TRGI_COMP1_TRGO                            (0x15U << ADC_ACQ4_CR_TRIGSEL_Pos)
#define    FL_ADC_ACQ4_TRGI_COMP2_TRGO                            (0x16U << ADC_ACQ4_CR_TRIGSEL_Pos)
#define    FL_ADC_ACQ4_TRGI_LPTIM0_TRGO                           (0x17U << ADC_ACQ4_CR_TRIGSEL_Pos)
#define    FL_ADC_ACQ4_TRGI_BSTIM0_TRGO                           (0x18U << ADC_ACQ4_CR_TRIGSEL_Pos)

#define    FL_ADC_ACQ4_SAMPLING_TIME_1_ADCCLK                     (0x0U << ADC_ACQ4_CR_SMTS_Pos)
#define    FL_ADC_ACQ4_SAMPLING_TIME_2_ADCCLK                     (0x1U << ADC_ACQ4_CR_SMTS_Pos)
#define    FL_ADC_ACQ4_SAMPLING_TIME_4_ADCCLK                     (0x2U << ADC_ACQ4_CR_SMTS_Pos)
#define    FL_ADC_ACQ4_SAMPLING_TIME_8_ADCCLK                     (0x3U << ADC_ACQ4_CR_SMTS_Pos)
#define    FL_ADC_ACQ4_SAMPLING_TIME_12_ADCCLK                    (0x4U << ADC_ACQ4_CR_SMTS_Pos)
#define    FL_ADC_ACQ4_SAMPLING_TIME_16_ADCCLK                    (0x5U << ADC_ACQ4_CR_SMTS_Pos)
#define    FL_ADC_ACQ4_SAMPLING_TIME_32_ADCCLK                    (0x6U << ADC_ACQ4_CR_SMTS_Pos)
#define    FL_ADC_ACQ4_SAMPLING_TIME_64_ADCCLK                    (0x7U << ADC_ACQ4_CR_SMTS_Pos)
#define    FL_ADC_ACQ4_SAMPLING_TIME_80_ADCCLK                    (0x8U << ADC_ACQ4_CR_SMTS_Pos)
#define    FL_ADC_ACQ4_SAMPLING_TIME_96_ADCCLK                    (0x9U << ADC_ACQ4_CR_SMTS_Pos)
#define    FL_ADC_ACQ4_SAMPLING_TIME_128_ADCCLK                   (0xaU << ADC_ACQ4_CR_SMTS_Pos)
#define    FL_ADC_ACQ4_SAMPLING_TIME_160_ADCCLK                   (0xbU << ADC_ACQ4_CR_SMTS_Pos)
#define    FL_ADC_ACQ4_SAMPLING_TIME_192_ADCCLK                   (0xcU << ADC_ACQ4_CR_SMTS_Pos)
#define    FL_ADC_ACQ4_SAMPLING_TIME_256_ADCCLK                   (0xdU << ADC_ACQ4_CR_SMTS_Pos)
#define    FL_ADC_ACQ4_SAMPLING_TIME_320_ADCCLK                   (0xeU << ADC_ACQ4_CR_SMTS_Pos)
#define    FL_ADC_ACQ4_SAMPLING_TIME_512_ADCCLK                   (0xfU << ADC_ACQ4_CR_SMTS_Pos)

#define    FL_ADC_ACQ5_SELECT_CHANNEL_ADC_INA0                    (0x0U << ADC_ACQ5_CR_CHSEL_Pos)
#define    FL_ADC_ACQ5_SELECT_CHANNEL_ADC_INA1                    (0x1U << ADC_ACQ5_CR_CHSEL_Pos)
#define    FL_ADC_ACQ5_SELECT_CHANNEL_ADC_INA2                    (0x2U << ADC_ACQ5_CR_CHSEL_Pos)
#define    FL_ADC_ACQ5_SELECT_CHANNEL_ADC_INA3                    (0x3U << ADC_ACQ5_CR_CHSEL_Pos)
#define    FL_ADC_ACQ5_SELECT_CHANNEL_ADC_INA4                    (0x4U << ADC_ACQ5_CR_CHSEL_Pos)
#define    FL_ADC_ACQ5_SELECT_CHANNEL_ADC_INA5                    (0x5U << ADC_ACQ5_CR_CHSEL_Pos)
#define    FL_ADC_ACQ5_SELECT_CHANNEL_ADC_INA6                    (0x6U << ADC_ACQ5_CR_CHSEL_Pos)
#define    FL_ADC_ACQ5_SELECT_CHANNEL_ADC_INA7                    (0x7U << ADC_ACQ5_CR_CHSEL_Pos)
#define    FL_ADC_ACQ5_SELECT_CHANNEL_ADC_INB8_OPA0_OUT           (0x8U << ADC_ACQ5_CR_CHSEL_Pos)
#define    FL_ADC_ACQ5_SELECT_CHANNEL_TS                          (0x9U << ADC_ACQ5_CR_CHSEL_Pos)
#define    FL_ADC_ACQ5_SELECT_CHANNEL_AVREF                       (0xaU << ADC_ACQ5_CR_CHSEL_Pos)
#define    FL_ADC_ACQ5_SELECT_CHANNEL_P_CALIBRATION               (0xcU << ADC_ACQ5_CR_CHSEL_Pos)
#define    FL_ADC_ACQ5_SELECT_CHANNEL_ADC_INB0                    (0x10U << ADC_ACQ5_CR_CHSEL_Pos)
#define    FL_ADC_ACQ5_SELECT_CHANNEL_ADC_INB1                    (0x11U << ADC_ACQ5_CR_CHSEL_Pos)
#define    FL_ADC_ACQ5_SELECT_CHANNEL_ADC_INB2                    (0x12U << ADC_ACQ5_CR_CHSEL_Pos)
#define    FL_ADC_ACQ5_SELECT_CHANNEL_ADC_INB3                    (0x13U << ADC_ACQ5_CR_CHSEL_Pos)
#define    FL_ADC_ACQ5_SELECT_CHANNEL_ADC_INB4                    (0x14U << ADC_ACQ5_CR_CHSEL_Pos)
#define    FL_ADC_ACQ5_SELECT_CHANNEL_ADC_INB5                    (0x15U << ADC_ACQ5_CR_CHSEL_Pos)
#define    FL_ADC_ACQ5_SELECT_CHANNEL_ADC_INB6                    (0x16U << ADC_ACQ5_CR_CHSEL_Pos)
#define    FL_ADC_ACQ5_SELECT_CHANNEL_ADC_INB7                    (0x17U << ADC_ACQ5_CR_CHSEL_Pos)
#define    FL_ADC_ACQ5_SELECT_CHANNEL_ADC_INB8_OPA1_OUT           (0x18U << ADC_ACQ5_CR_CHSEL_Pos)
#define    FL_ADC_ACQ5_SELECT_CHANNEL_VBAT_DIV3                  (0x19U << ADC_ACQ5_CR_CHSEL_Pos)
#define    FL_ADC_ACQ5_SELECT_CHANNEL_DAC1_OUT1                   (0x1aU << ADC_ACQ5_CR_CHSEL_Pos)
#define    FL_ADC_ACQ5_SELECT_CHANNEL_N_CALIBRATION               (0x1cU << ADC_ACQ5_CR_CHSEL_Pos)

#define    FL_ADC_ACQ5_TRGI_SOFE_TRG                              (0x0U << ADC_ACQ5_CR_TRIGSEL_Pos)
#define    FL_ADC_ACQ5_TRGI_LUT0_TRG                              (0x1U << ADC_ACQ5_CR_TRIGSEL_Pos)
#define    FL_ADC_ACQ5_TRGI_LUT1_TRG                              (0x2U << ADC_ACQ5_CR_TRIGSEL_Pos)
#define    FL_ADC_ACQ5_TRGI_LUT2_TRG                              (0x3U << ADC_ACQ5_CR_TRIGSEL_Pos)
#define    FL_ADC_ACQ5_TRGI_LUT3_TRG                              (0x4U << ADC_ACQ5_CR_TRIGSEL_Pos)
#define    FL_ADC_ACQ5_TRGI_ATIM0_TRGO                            (0x5U << ADC_ACQ5_CR_TRIGSEL_Pos)
#define    FL_ADC_ACQ5_TRGI_ATIM1_TRGO                            (0x6U << ADC_ACQ5_CR_TRIGSEL_Pos)
#define    FL_ADC_ACQ5_TRGI_ATIM0_TRGO2                           (0x7U << ADC_ACQ5_CR_TRIGSEL_Pos)
#define    FL_ADC_ACQ5_TRGI_ATIM1_TRGO2                           (0x8U << ADC_ACQ5_CR_TRIGSEL_Pos)
#define    FL_ADC_ACQ5_TRGI_GPTIM0_TRGO                           (0x9U << ADC_ACQ5_CR_TRIGSEL_Pos)
#define    FL_ADC_ACQ5_TRGI_GPTIM1_TRGO                           (0xaU << ADC_ACQ5_CR_TRIGSEL_Pos)
#define    FL_ADC_ACQ5_TRGI_GPTIM2_TRGO                           (0xbU << ADC_ACQ5_CR_TRIGSEL_Pos)
#define    FL_ADC_ACQ5_TRGI_EPWM0SOCA                             (0xcU << ADC_ACQ5_CR_TRIGSEL_Pos)
#define    FL_ADC_ACQ5_TRGI_EPWM0SOCB                             (0xdU << ADC_ACQ5_CR_TRIGSEL_Pos)
#define    FL_ADC_ACQ5_TRGI_EPWM1SOCA                             (0xeU << ADC_ACQ5_CR_TRIGSEL_Pos)
#define    FL_ADC_ACQ5_TRGI_EPWM1SOCB                             (0xfU << ADC_ACQ5_CR_TRIGSEL_Pos)
#define    FL_ADC_ACQ5_TRGI_EPWM2SOCA                             (0x10U << ADC_ACQ5_CR_TRIGSEL_Pos)
#define    FL_ADC_ACQ5_TRGI_EPWM2SOCB                             (0x11U << ADC_ACQ5_CR_TRIGSEL_Pos)
#define    FL_ADC_ACQ5_TRGI_EPWM3SOCA                             (0x12U << ADC_ACQ5_CR_TRIGSEL_Pos)
#define    FL_ADC_ACQ5_TRGI_EPWM3SOCB                             (0x13U << ADC_ACQ5_CR_TRIGSEL_Pos)
#define    FL_ADC_ACQ5_TRGI_COMP0_TRGO                            (0x14U << ADC_ACQ5_CR_TRIGSEL_Pos)
#define    FL_ADC_ACQ5_TRGI_COMP1_TRGO                            (0x15U << ADC_ACQ5_CR_TRIGSEL_Pos)
#define    FL_ADC_ACQ5_TRGI_COMP2_TRGO                            (0x16U << ADC_ACQ5_CR_TRIGSEL_Pos)
#define    FL_ADC_ACQ5_TRGI_LPTIM0_TRGO                           (0x17U << ADC_ACQ5_CR_TRIGSEL_Pos)
#define    FL_ADC_ACQ5_TRGI_BSTIM0_TRGO                           (0x18U << ADC_ACQ5_CR_TRIGSEL_Pos)

#define    FL_ADC_ACQ5_SAMPLING_TIME_1_ADCCLK                     (0x0U << ADC_ACQ5_CR_SMTS_Pos)
#define    FL_ADC_ACQ5_SAMPLING_TIME_2_ADCCLK                     (0x1U << ADC_ACQ5_CR_SMTS_Pos)
#define    FL_ADC_ACQ5_SAMPLING_TIME_4_ADCCLK                     (0x2U << ADC_ACQ5_CR_SMTS_Pos)
#define    FL_ADC_ACQ5_SAMPLING_TIME_8_ADCCLK                     (0x3U << ADC_ACQ5_CR_SMTS_Pos)
#define    FL_ADC_ACQ5_SAMPLING_TIME_12_ADCCLK                    (0x4U << ADC_ACQ5_CR_SMTS_Pos)
#define    FL_ADC_ACQ5_SAMPLING_TIME_16_ADCCLK                    (0x5U << ADC_ACQ5_CR_SMTS_Pos)
#define    FL_ADC_ACQ5_SAMPLING_TIME_32_ADCCLK                    (0x6U << ADC_ACQ5_CR_SMTS_Pos)
#define    FL_ADC_ACQ5_SAMPLING_TIME_64_ADCCLK                    (0x7U << ADC_ACQ5_CR_SMTS_Pos)
#define    FL_ADC_ACQ5_SAMPLING_TIME_80_ADCCLK                    (0x8U << ADC_ACQ5_CR_SMTS_Pos)
#define    FL_ADC_ACQ5_SAMPLING_TIME_96_ADCCLK                    (0x9U << ADC_ACQ5_CR_SMTS_Pos)
#define    FL_ADC_ACQ5_SAMPLING_TIME_128_ADCCLK                   (0xaU << ADC_ACQ5_CR_SMTS_Pos)
#define    FL_ADC_ACQ5_SAMPLING_TIME_160_ADCCLK                   (0xbU << ADC_ACQ5_CR_SMTS_Pos)
#define    FL_ADC_ACQ5_SAMPLING_TIME_192_ADCCLK                   (0xcU << ADC_ACQ5_CR_SMTS_Pos)
#define    FL_ADC_ACQ5_SAMPLING_TIME_256_ADCCLK                   (0xdU << ADC_ACQ5_CR_SMTS_Pos)
#define    FL_ADC_ACQ5_SAMPLING_TIME_320_ADCCLK                   (0xeU << ADC_ACQ5_CR_SMTS_Pos)
#define    FL_ADC_ACQ5_SAMPLING_TIME_512_ADCCLK                   (0xfU << ADC_ACQ5_CR_SMTS_Pos)

#define    FL_ADC_ACQ6_SELECT_CHANNEL_ADC_INA0                    (0x0U << ADC_ACQ6_CR_CHSEL_Pos)
#define    FL_ADC_ACQ6_SELECT_CHANNEL_ADC_INA1                    (0x1U << ADC_ACQ6_CR_CHSEL_Pos)
#define    FL_ADC_ACQ6_SELECT_CHANNEL_ADC_INA2                    (0x2U << ADC_ACQ6_CR_CHSEL_Pos)
#define    FL_ADC_ACQ6_SELECT_CHANNEL_ADC_INA3                    (0x3U << ADC_ACQ6_CR_CHSEL_Pos)
#define    FL_ADC_ACQ6_SELECT_CHANNEL_ADC_INA4                    (0x4U << ADC_ACQ6_CR_CHSEL_Pos)
#define    FL_ADC_ACQ6_SELECT_CHANNEL_ADC_INA5                    (0x5U << ADC_ACQ6_CR_CHSEL_Pos)
#define    FL_ADC_ACQ6_SELECT_CHANNEL_ADC_INA6                    (0x6U << ADC_ACQ6_CR_CHSEL_Pos)
#define    FL_ADC_ACQ6_SELECT_CHANNEL_ADC_INA7                    (0x7U << ADC_ACQ6_CR_CHSEL_Pos)
#define    FL_ADC_ACQ6_SELECT_CHANNEL_ADC_INB8_OPA0_OUT           (0x8U << ADC_ACQ6_CR_CHSEL_Pos)
#define    FL_ADC_ACQ6_SELECT_CHANNEL_TS                          (0x9U << ADC_ACQ6_CR_CHSEL_Pos)
#define    FL_ADC_ACQ6_SELECT_CHANNEL_AVREF                       (0xaU << ADC_ACQ6_CR_CHSEL_Pos)
#define    FL_ADC_ACQ6_SELECT_CHANNEL_P_CALIBRATION               (0xcU << ADC_ACQ6_CR_CHSEL_Pos)
#define    FL_ADC_ACQ6_SELECT_CHANNEL_ADC_INB0                    (0x10U << ADC_ACQ6_CR_CHSEL_Pos)
#define    FL_ADC_ACQ6_SELECT_CHANNEL_ADC_INB1                    (0x11U << ADC_ACQ6_CR_CHSEL_Pos)
#define    FL_ADC_ACQ6_SELECT_CHANNEL_ADC_INB2                    (0x12U << ADC_ACQ6_CR_CHSEL_Pos)
#define    FL_ADC_ACQ6_SELECT_CHANNEL_ADC_INB3                    (0x13U << ADC_ACQ6_CR_CHSEL_Pos)
#define    FL_ADC_ACQ6_SELECT_CHANNEL_ADC_INB4                    (0x14U << ADC_ACQ6_CR_CHSEL_Pos)
#define    FL_ADC_ACQ6_SELECT_CHANNEL_ADC_INB5                    (0x15U << ADC_ACQ6_CR_CHSEL_Pos)
#define    FL_ADC_ACQ6_SELECT_CHANNEL_ADC_INB6                    (0x16U << ADC_ACQ6_CR_CHSEL_Pos)
#define    FL_ADC_ACQ6_SELECT_CHANNEL_ADC_INB7                    (0x17U << ADC_ACQ6_CR_CHSEL_Pos)
#define    FL_ADC_ACQ6_SELECT_CHANNEL_ADC_INB8_OPA1_OUT           (0x18U << ADC_ACQ6_CR_CHSEL_Pos)
#define    FL_ADC_ACQ6_SELECT_CHANNEL_VBAT_DIV3                  (0x19U << ADC_ACQ6_CR_CHSEL_Pos)
#define    FL_ADC_ACQ6_SELECT_CHANNEL_DAC1_OUT1                   (0x1aU << ADC_ACQ6_CR_CHSEL_Pos)
#define    FL_ADC_ACQ6_SELECT_CHANNEL_N_CALIBRATION               (0x1cU << ADC_ACQ6_CR_CHSEL_Pos)

#define    FL_ADC_ACQ6_TRGI_SOFE_TRG                              (0x0U << ADC_ACQ6_CR_TRIGSEL_Pos)
#define    FL_ADC_ACQ6_TRGI_LUT0_TRG                              (0x1U << ADC_ACQ6_CR_TRIGSEL_Pos)
#define    FL_ADC_ACQ6_TRGI_LUT1_TRG                              (0x2U << ADC_ACQ6_CR_TRIGSEL_Pos)
#define    FL_ADC_ACQ6_TRGI_LUT2_TRG                              (0x3U << ADC_ACQ6_CR_TRIGSEL_Pos)
#define    FL_ADC_ACQ6_TRGI_LUT3_TRG                              (0x4U << ADC_ACQ6_CR_TRIGSEL_Pos)
#define    FL_ADC_ACQ6_TRGI_ATIM0_TRGO                            (0x5U << ADC_ACQ6_CR_TRIGSEL_Pos)
#define    FL_ADC_ACQ6_TRGI_ATIM1_TRGO                            (0x6U << ADC_ACQ6_CR_TRIGSEL_Pos)
#define    FL_ADC_ACQ6_TRGI_ATIM0_TRGO2                           (0x7U << ADC_ACQ6_CR_TRIGSEL_Pos)
#define    FL_ADC_ACQ6_TRGI_ATIM1_TRGO2                           (0x8U << ADC_ACQ6_CR_TRIGSEL_Pos)
#define    FL_ADC_ACQ6_TRGI_GPTIM0_TRGO                           (0x9U << ADC_ACQ6_CR_TRIGSEL_Pos)
#define    FL_ADC_ACQ6_TRGI_GPTIM1_TRGO                           (0xaU << ADC_ACQ6_CR_TRIGSEL_Pos)
#define    FL_ADC_ACQ6_TRGI_GPTIM2_TRGO                           (0xbU << ADC_ACQ6_CR_TRIGSEL_Pos)
#define    FL_ADC_ACQ6_TRGI_EPWM0SOCA                             (0xcU << ADC_ACQ6_CR_TRIGSEL_Pos)
#define    FL_ADC_ACQ6_TRGI_EPWM0SOCB                             (0xdU << ADC_ACQ6_CR_TRIGSEL_Pos)
#define    FL_ADC_ACQ6_TRGI_EPWM1SOCA                             (0xeU << ADC_ACQ6_CR_TRIGSEL_Pos)
#define    FL_ADC_ACQ6_TRGI_EPWM1SOCB                             (0xfU << ADC_ACQ6_CR_TRIGSEL_Pos)
#define    FL_ADC_ACQ6_TRGI_EPWM2SOCA                             (0x10U << ADC_ACQ6_CR_TRIGSEL_Pos)
#define    FL_ADC_ACQ6_TRGI_EPWM2SOCB                             (0x11U << ADC_ACQ6_CR_TRIGSEL_Pos)
#define    FL_ADC_ACQ6_TRGI_EPWM3SOCA                             (0x12U << ADC_ACQ6_CR_TRIGSEL_Pos)
#define    FL_ADC_ACQ6_TRGI_EPWM3SOCB                             (0x13U << ADC_ACQ6_CR_TRIGSEL_Pos)
#define    FL_ADC_ACQ6_TRGI_COMP0_TRGO                            (0x14U << ADC_ACQ6_CR_TRIGSEL_Pos)
#define    FL_ADC_ACQ6_TRGI_COMP1_TRGO                            (0x15U << ADC_ACQ6_CR_TRIGSEL_Pos)
#define    FL_ADC_ACQ6_TRGI_COMP2_TRGO                            (0x16U << ADC_ACQ6_CR_TRIGSEL_Pos)
#define    FL_ADC_ACQ6_TRGI_LPTIM0_TRGO                           (0x17U << ADC_ACQ6_CR_TRIGSEL_Pos)
#define    FL_ADC_ACQ6_TRGI_BSTIM0_TRGO                           (0x18U << ADC_ACQ6_CR_TRIGSEL_Pos)

#define    FL_ADC_ACQ6_SAMPLING_TIME_1_ADCCLK                     (0x0U << ADC_ACQ6_CR_SMTS_Pos)
#define    FL_ADC_ACQ6_SAMPLING_TIME_2_ADCCLK                     (0x1U << ADC_ACQ6_CR_SMTS_Pos)
#define    FL_ADC_ACQ6_SAMPLING_TIME_4_ADCCLK                     (0x2U << ADC_ACQ6_CR_SMTS_Pos)
#define    FL_ADC_ACQ6_SAMPLING_TIME_8_ADCCLK                     (0x3U << ADC_ACQ6_CR_SMTS_Pos)
#define    FL_ADC_ACQ6_SAMPLING_TIME_12_ADCCLK                    (0x4U << ADC_ACQ6_CR_SMTS_Pos)
#define    FL_ADC_ACQ6_SAMPLING_TIME_16_ADCCLK                    (0x5U << ADC_ACQ6_CR_SMTS_Pos)
#define    FL_ADC_ACQ6_SAMPLING_TIME_32_ADCCLK                    (0x6U << ADC_ACQ6_CR_SMTS_Pos)
#define    FL_ADC_ACQ6_SAMPLING_TIME_64_ADCCLK                    (0x7U << ADC_ACQ6_CR_SMTS_Pos)
#define    FL_ADC_ACQ6_SAMPLING_TIME_80_ADCCLK                    (0x8U << ADC_ACQ6_CR_SMTS_Pos)
#define    FL_ADC_ACQ6_SAMPLING_TIME_96_ADCCLK                    (0x9U << ADC_ACQ6_CR_SMTS_Pos)
#define    FL_ADC_ACQ6_SAMPLING_TIME_128_ADCCLK                   (0xaU << ADC_ACQ6_CR_SMTS_Pos)
#define    FL_ADC_ACQ6_SAMPLING_TIME_160_ADCCLK                   (0xbU << ADC_ACQ6_CR_SMTS_Pos)
#define    FL_ADC_ACQ6_SAMPLING_TIME_192_ADCCLK                   (0xcU << ADC_ACQ6_CR_SMTS_Pos)
#define    FL_ADC_ACQ6_SAMPLING_TIME_256_ADCCLK                   (0xdU << ADC_ACQ6_CR_SMTS_Pos)
#define    FL_ADC_ACQ6_SAMPLING_TIME_320_ADCCLK                   (0xeU << ADC_ACQ6_CR_SMTS_Pos)
#define    FL_ADC_ACQ6_SAMPLING_TIME_512_ADCCLK                   (0xfU << ADC_ACQ6_CR_SMTS_Pos)

#define    FL_ADC_ACQ7_SELECT_CHANNEL_ADC_INA0                    (0x0U << ADC_ACQ7_CR_CHSEL_Pos)
#define    FL_ADC_ACQ7_SELECT_CHANNEL_ADC_INA1                    (0x1U << ADC_ACQ7_CR_CHSEL_Pos)
#define    FL_ADC_ACQ7_SELECT_CHANNEL_ADC_INA2                    (0x2U << ADC_ACQ7_CR_CHSEL_Pos)
#define    FL_ADC_ACQ7_SELECT_CHANNEL_ADC_INA3                    (0x3U << ADC_ACQ7_CR_CHSEL_Pos)
#define    FL_ADC_ACQ7_SELECT_CHANNEL_ADC_INA4                    (0x4U << ADC_ACQ7_CR_CHSEL_Pos)
#define    FL_ADC_ACQ7_SELECT_CHANNEL_ADC_INA5                    (0x5U << ADC_ACQ7_CR_CHSEL_Pos)
#define    FL_ADC_ACQ7_SELECT_CHANNEL_ADC_INA6                    (0x6U << ADC_ACQ7_CR_CHSEL_Pos)
#define    FL_ADC_ACQ7_SELECT_CHANNEL_ADC_INA7                    (0x7U << ADC_ACQ7_CR_CHSEL_Pos)
#define    FL_ADC_ACQ7_SELECT_CHANNEL_ADC_INB8_OPA0_OUT           (0x8U << ADC_ACQ7_CR_CHSEL_Pos)
#define    FL_ADC_ACQ7_SELECT_CHANNEL_TS                          (0x9U << ADC_ACQ7_CR_CHSEL_Pos)
#define    FL_ADC_ACQ7_SELECT_CHANNEL_AVREF                       (0xaU << ADC_ACQ7_CR_CHSEL_Pos)
#define    FL_ADC_ACQ7_SELECT_CHANNEL_P_CALIBRATION               (0xcU << ADC_ACQ7_CR_CHSEL_Pos)
#define    FL_ADC_ACQ7_SELECT_CHANNEL_ADC_INB0                    (0x10U << ADC_ACQ7_CR_CHSEL_Pos)
#define    FL_ADC_ACQ7_SELECT_CHANNEL_ADC_INB1                    (0x11U << ADC_ACQ7_CR_CHSEL_Pos)
#define    FL_ADC_ACQ7_SELECT_CHANNEL_ADC_INB2                    (0x12U << ADC_ACQ7_CR_CHSEL_Pos)
#define    FL_ADC_ACQ7_SELECT_CHANNEL_ADC_INB3                    (0x13U << ADC_ACQ7_CR_CHSEL_Pos)
#define    FL_ADC_ACQ7_SELECT_CHANNEL_ADC_INB4                    (0x14U << ADC_ACQ7_CR_CHSEL_Pos)
#define    FL_ADC_ACQ7_SELECT_CHANNEL_ADC_INB5                    (0x15U << ADC_ACQ7_CR_CHSEL_Pos)
#define    FL_ADC_ACQ7_SELECT_CHANNEL_ADC_INB6                    (0x16U << ADC_ACQ7_CR_CHSEL_Pos)
#define    FL_ADC_ACQ7_SELECT_CHANNEL_ADC_INB7                    (0x17U << ADC_ACQ7_CR_CHSEL_Pos)
#define    FL_ADC_ACQ7_SELECT_CHANNEL_ADC_INB8_OPA1_OUT           (0x18U << ADC_ACQ7_CR_CHSEL_Pos)
#define    FL_ADC_ACQ7_SELECT_CHANNEL_VBAT_DIV3                  (0x19U << ADC_ACQ7_CR_CHSEL_Pos)
#define    FL_ADC_ACQ7_SELECT_CHANNEL_DAC1_OUT1                   (0x1aU << ADC_ACQ7_CR_CHSEL_Pos)
#define    FL_ADC_ACQ7_SELECT_CHANNEL_N_CALIBRATION               (0x1cU << ADC_ACQ7_CR_CHSEL_Pos)

#define    FL_ADC_ACQ7_TRGI_SOFE_TRG                              (0x0U << ADC_ACQ7_CR_TRIGSEL_Pos)
#define    FL_ADC_ACQ7_TRGI_LUT0_TRG                              (0x1U << ADC_ACQ7_CR_TRIGSEL_Pos)
#define    FL_ADC_ACQ7_TRGI_LUT1_TRG                              (0x2U << ADC_ACQ7_CR_TRIGSEL_Pos)
#define    FL_ADC_ACQ7_TRGI_LUT2_TRG                              (0x3U << ADC_ACQ7_CR_TRIGSEL_Pos)
#define    FL_ADC_ACQ7_TRGI_LUT3_TRG                              (0x4U << ADC_ACQ7_CR_TRIGSEL_Pos)
#define    FL_ADC_ACQ7_TRGI_ATIM0_TRGO                            (0x5U << ADC_ACQ7_CR_TRIGSEL_Pos)
#define    FL_ADC_ACQ7_TRGI_ATIM1_TRGO                            (0x6U << ADC_ACQ7_CR_TRIGSEL_Pos)
#define    FL_ADC_ACQ7_TRGI_ATIM0_TRGO2                           (0x7U << ADC_ACQ7_CR_TRIGSEL_Pos)
#define    FL_ADC_ACQ7_TRGI_ATIM1_TRGO2                           (0x8U << ADC_ACQ7_CR_TRIGSEL_Pos)
#define    FL_ADC_ACQ7_TRGI_GPTIM0_TRGO                           (0x9U << ADC_ACQ7_CR_TRIGSEL_Pos)
#define    FL_ADC_ACQ7_TRGI_GPTIM1_TRGO                           (0xaU << ADC_ACQ7_CR_TRIGSEL_Pos)
#define    FL_ADC_ACQ7_TRGI_GPTIM2_TRGO                           (0xbU << ADC_ACQ7_CR_TRIGSEL_Pos)
#define    FL_ADC_ACQ7_TRGI_EPWM0SOCA                             (0xcU << ADC_ACQ7_CR_TRIGSEL_Pos)
#define    FL_ADC_ACQ7_TRGI_EPWM0SOCB                             (0xdU << ADC_ACQ7_CR_TRIGSEL_Pos)
#define    FL_ADC_ACQ7_TRGI_EPWM1SOCA                             (0xeU << ADC_ACQ7_CR_TRIGSEL_Pos)
#define    FL_ADC_ACQ7_TRGI_EPWM1SOCB                             (0xfU << ADC_ACQ7_CR_TRIGSEL_Pos)
#define    FL_ADC_ACQ7_TRGI_EPWM2SOCA                             (0x10U << ADC_ACQ7_CR_TRIGSEL_Pos)
#define    FL_ADC_ACQ7_TRGI_EPWM2SOCB                             (0x11U << ADC_ACQ7_CR_TRIGSEL_Pos)
#define    FL_ADC_ACQ7_TRGI_EPWM3SOCA                             (0x12U << ADC_ACQ7_CR_TRIGSEL_Pos)
#define    FL_ADC_ACQ7_TRGI_EPWM3SOCB                             (0x13U << ADC_ACQ7_CR_TRIGSEL_Pos)
#define    FL_ADC_ACQ7_TRGI_COMP0_TRGO                            (0x14U << ADC_ACQ7_CR_TRIGSEL_Pos)
#define    FL_ADC_ACQ7_TRGI_COMP1_TRGO                            (0x15U << ADC_ACQ7_CR_TRIGSEL_Pos)
#define    FL_ADC_ACQ7_TRGI_COMP2_TRGO                            (0x16U << ADC_ACQ7_CR_TRIGSEL_Pos)
#define    FL_ADC_ACQ7_TRGI_LPTIM0_TRGO                           (0x17U << ADC_ACQ7_CR_TRIGSEL_Pos)
#define    FL_ADC_ACQ7_TRGI_BSTIM0_TRGO                           (0x18U << ADC_ACQ7_CR_TRIGSEL_Pos)

#define    FL_ADC_ACQ7_SAMPLING_TIME_1_ADCCLK                     (0x0U << ADC_ACQ7_CR_SMTS_Pos)
#define    FL_ADC_ACQ7_SAMPLING_TIME_2_ADCCLK                     (0x1U << ADC_ACQ7_CR_SMTS_Pos)
#define    FL_ADC_ACQ7_SAMPLING_TIME_4_ADCCLK                     (0x2U << ADC_ACQ7_CR_SMTS_Pos)
#define    FL_ADC_ACQ7_SAMPLING_TIME_8_ADCCLK                     (0x3U << ADC_ACQ7_CR_SMTS_Pos)
#define    FL_ADC_ACQ7_SAMPLING_TIME_12_ADCCLK                    (0x4U << ADC_ACQ7_CR_SMTS_Pos)
#define    FL_ADC_ACQ7_SAMPLING_TIME_16_ADCCLK                    (0x5U << ADC_ACQ7_CR_SMTS_Pos)
#define    FL_ADC_ACQ7_SAMPLING_TIME_32_ADCCLK                    (0x6U << ADC_ACQ7_CR_SMTS_Pos)
#define    FL_ADC_ACQ7_SAMPLING_TIME_64_ADCCLK                    (0x7U << ADC_ACQ7_CR_SMTS_Pos)
#define    FL_ADC_ACQ7_SAMPLING_TIME_80_ADCCLK                    (0x8U << ADC_ACQ7_CR_SMTS_Pos)
#define    FL_ADC_ACQ7_SAMPLING_TIME_96_ADCCLK                    (0x9U << ADC_ACQ7_CR_SMTS_Pos)
#define    FL_ADC_ACQ7_SAMPLING_TIME_128_ADCCLK                   (0xaU << ADC_ACQ7_CR_SMTS_Pos)
#define    FL_ADC_ACQ7_SAMPLING_TIME_160_ADCCLK                   (0xbU << ADC_ACQ7_CR_SMTS_Pos)
#define    FL_ADC_ACQ7_SAMPLING_TIME_192_ADCCLK                   (0xcU << ADC_ACQ7_CR_SMTS_Pos)
#define    FL_ADC_ACQ7_SAMPLING_TIME_256_ADCCLK                   (0xdU << ADC_ACQ7_CR_SMTS_Pos)
#define    FL_ADC_ACQ7_SAMPLING_TIME_320_ADCCLK                   (0xeU << ADC_ACQ7_CR_SMTS_Pos)
#define    FL_ADC_ACQ7_SAMPLING_TIME_512_ADCCLK                   (0xfU << ADC_ACQ7_CR_SMTS_Pos)

#define    FL_ADC_ACQ8_SELECT_CHANNEL_ADC_INA0                    (0x0U << ADC_ACQ8_CR_CHSEL_Pos)
#define    FL_ADC_ACQ8_SELECT_CHANNEL_ADC_INA1                    (0x1U << ADC_ACQ8_CR_CHSEL_Pos)
#define    FL_ADC_ACQ8_SELECT_CHANNEL_ADC_INA2                    (0x2U << ADC_ACQ8_CR_CHSEL_Pos)
#define    FL_ADC_ACQ8_SELECT_CHANNEL_ADC_INA3                    (0x3U << ADC_ACQ8_CR_CHSEL_Pos)
#define    FL_ADC_ACQ8_SELECT_CHANNEL_ADC_INA4                    (0x4U << ADC_ACQ8_CR_CHSEL_Pos)
#define    FL_ADC_ACQ8_SELECT_CHANNEL_ADC_INA5                    (0x5U << ADC_ACQ8_CR_CHSEL_Pos)
#define    FL_ADC_ACQ8_SELECT_CHANNEL_ADC_INA6                    (0x6U << ADC_ACQ8_CR_CHSEL_Pos)
#define    FL_ADC_ACQ8_SELECT_CHANNEL_ADC_INA7                    (0x7U << ADC_ACQ8_CR_CHSEL_Pos)
#define    FL_ADC_ACQ8_SELECT_CHANNEL_ADC_INB8_OPA0_OUT           (0x8U << ADC_ACQ8_CR_CHSEL_Pos)
#define    FL_ADC_ACQ8_SELECT_CHANNEL_TS                          (0x9U << ADC_ACQ8_CR_CHSEL_Pos)
#define    FL_ADC_ACQ8_SELECT_CHANNEL_AVREF                       (0xaU << ADC_ACQ8_CR_CHSEL_Pos)
#define    FL_ADC_ACQ8_SELECT_CHANNEL_P_CALIBRATION               (0xcU << ADC_ACQ8_CR_CHSEL_Pos)
#define    FL_ADC_ACQ8_SELECT_CHANNEL_ADC_INB0                    (0x10U << ADC_ACQ8_CR_CHSEL_Pos)
#define    FL_ADC_ACQ8_SELECT_CHANNEL_ADC_INB1                    (0x11U << ADC_ACQ8_CR_CHSEL_Pos)
#define    FL_ADC_ACQ8_SELECT_CHANNEL_ADC_INB2                    (0x12U << ADC_ACQ8_CR_CHSEL_Pos)
#define    FL_ADC_ACQ8_SELECT_CHANNEL_ADC_INB3                    (0x13U << ADC_ACQ8_CR_CHSEL_Pos)
#define    FL_ADC_ACQ8_SELECT_CHANNEL_ADC_INB4                    (0x14U << ADC_ACQ8_CR_CHSEL_Pos)
#define    FL_ADC_ACQ8_SELECT_CHANNEL_ADC_INB5                    (0x15U << ADC_ACQ8_CR_CHSEL_Pos)
#define    FL_ADC_ACQ8_SELECT_CHANNEL_ADC_INB6                    (0x16U << ADC_ACQ8_CR_CHSEL_Pos)
#define    FL_ADC_ACQ8_SELECT_CHANNEL_ADC_INB7                    (0x17U << ADC_ACQ8_CR_CHSEL_Pos)
#define    FL_ADC_ACQ8_SELECT_CHANNEL_ADC_INB8_OPA1_OUT           (0x18U << ADC_ACQ8_CR_CHSEL_Pos)
#define    FL_ADC_ACQ8_SELECT_CHANNEL_VBAT_DIV3                  (0x19U << ADC_ACQ8_CR_CHSEL_Pos)
#define    FL_ADC_ACQ8_SELECT_CHANNEL_DAC1_OUT1                   (0x1aU << ADC_ACQ8_CR_CHSEL_Pos)
#define    FL_ADC_ACQ8_SELECT_CHANNEL_N_CALIBRATION               (0x1cU << ADC_ACQ8_CR_CHSEL_Pos)

#define    FL_ADC_ACQ8_TRGI_SOFE_TRG                              (0x0U << ADC_ACQ8_CR_TRIGSEL_Pos)
#define    FL_ADC_ACQ8_TRGI_LUT0_TRG                              (0x1U << ADC_ACQ8_CR_TRIGSEL_Pos)
#define    FL_ADC_ACQ8_TRGI_LUT1_TRG                              (0x2U << ADC_ACQ8_CR_TRIGSEL_Pos)
#define    FL_ADC_ACQ8_TRGI_LUT2_TRG                              (0x3U << ADC_ACQ8_CR_TRIGSEL_Pos)
#define    FL_ADC_ACQ8_TRGI_LUT3_TRG                              (0x4U << ADC_ACQ8_CR_TRIGSEL_Pos)
#define    FL_ADC_ACQ8_TRGI_ATIM0_TRGO                            (0x5U << ADC_ACQ8_CR_TRIGSEL_Pos)
#define    FL_ADC_ACQ8_TRGI_ATIM1_TRGO                            (0x6U << ADC_ACQ8_CR_TRIGSEL_Pos)
#define    FL_ADC_ACQ8_TRGI_ATIM0_TRGO2                           (0x7U << ADC_ACQ8_CR_TRIGSEL_Pos)
#define    FL_ADC_ACQ8_TRGI_ATIM1_TRGO2                           (0x8U << ADC_ACQ8_CR_TRIGSEL_Pos)
#define    FL_ADC_ACQ8_TRGI_GPTIM0_TRGO                           (0x9U << ADC_ACQ8_CR_TRIGSEL_Pos)
#define    FL_ADC_ACQ8_TRGI_GPTIM1_TRGO                           (0xaU << ADC_ACQ8_CR_TRIGSEL_Pos)
#define    FL_ADC_ACQ8_TRGI_GPTIM2_TRGO                           (0xbU << ADC_ACQ8_CR_TRIGSEL_Pos)
#define    FL_ADC_ACQ8_TRGI_EPWM0SOCA                             (0xcU << ADC_ACQ8_CR_TRIGSEL_Pos)
#define    FL_ADC_ACQ8_TRGI_EPWM0SOCB                             (0xdU << ADC_ACQ8_CR_TRIGSEL_Pos)
#define    FL_ADC_ACQ8_TRGI_EPWM1SOCA                             (0xeU << ADC_ACQ8_CR_TRIGSEL_Pos)
#define    FL_ADC_ACQ8_TRGI_EPWM1SOCB                             (0xfU << ADC_ACQ8_CR_TRIGSEL_Pos)
#define    FL_ADC_ACQ8_TRGI_EPWM2SOCA                             (0x10U << ADC_ACQ8_CR_TRIGSEL_Pos)
#define    FL_ADC_ACQ8_TRGI_EPWM2SOCB                             (0x11U << ADC_ACQ8_CR_TRIGSEL_Pos)
#define    FL_ADC_ACQ8_TRGI_EPWM3SOCA                             (0x12U << ADC_ACQ8_CR_TRIGSEL_Pos)
#define    FL_ADC_ACQ8_TRGI_EPWM3SOCB                             (0x13U << ADC_ACQ8_CR_TRIGSEL_Pos)
#define    FL_ADC_ACQ8_TRGI_COMP0_TRGO                            (0x14U << ADC_ACQ8_CR_TRIGSEL_Pos)
#define    FL_ADC_ACQ8_TRGI_COMP1_TRGO                            (0x15U << ADC_ACQ8_CR_TRIGSEL_Pos)
#define    FL_ADC_ACQ8_TRGI_COMP2_TRGO                            (0x16U << ADC_ACQ8_CR_TRIGSEL_Pos)
#define    FL_ADC_ACQ8_TRGI_LPTIM0_TRGO                           (0x17U << ADC_ACQ8_CR_TRIGSEL_Pos)
#define    FL_ADC_ACQ8_TRGI_BSTIM0_TRGO                           (0x18U << ADC_ACQ8_CR_TRIGSEL_Pos)

#define    FL_ADC_ACQ8_SAMPLING_TIME_1_ADCCLK                     (0x0U << ADC_ACQ8_CR_SMTS_Pos)
#define    FL_ADC_ACQ8_SAMPLING_TIME_2_ADCCLK                     (0x1U << ADC_ACQ8_CR_SMTS_Pos)
#define    FL_ADC_ACQ8_SAMPLING_TIME_4_ADCCLK                     (0x2U << ADC_ACQ8_CR_SMTS_Pos)
#define    FL_ADC_ACQ8_SAMPLING_TIME_8_ADCCLK                     (0x3U << ADC_ACQ8_CR_SMTS_Pos)
#define    FL_ADC_ACQ8_SAMPLING_TIME_12_ADCCLK                    (0x4U << ADC_ACQ8_CR_SMTS_Pos)
#define    FL_ADC_ACQ8_SAMPLING_TIME_16_ADCCLK                    (0x5U << ADC_ACQ8_CR_SMTS_Pos)
#define    FL_ADC_ACQ8_SAMPLING_TIME_32_ADCCLK                    (0x6U << ADC_ACQ8_CR_SMTS_Pos)
#define    FL_ADC_ACQ8_SAMPLING_TIME_64_ADCCLK                    (0x7U << ADC_ACQ8_CR_SMTS_Pos)
#define    FL_ADC_ACQ8_SAMPLING_TIME_80_ADCCLK                    (0x8U << ADC_ACQ8_CR_SMTS_Pos)
#define    FL_ADC_ACQ8_SAMPLING_TIME_96_ADCCLK                    (0x9U << ADC_ACQ8_CR_SMTS_Pos)
#define    FL_ADC_ACQ8_SAMPLING_TIME_128_ADCCLK                   (0xaU << ADC_ACQ8_CR_SMTS_Pos)
#define    FL_ADC_ACQ8_SAMPLING_TIME_160_ADCCLK                   (0xbU << ADC_ACQ8_CR_SMTS_Pos)
#define    FL_ADC_ACQ8_SAMPLING_TIME_192_ADCCLK                   (0xcU << ADC_ACQ8_CR_SMTS_Pos)
#define    FL_ADC_ACQ8_SAMPLING_TIME_256_ADCCLK                   (0xdU << ADC_ACQ8_CR_SMTS_Pos)
#define    FL_ADC_ACQ8_SAMPLING_TIME_320_ADCCLK                   (0xeU << ADC_ACQ8_CR_SMTS_Pos)
#define    FL_ADC_ACQ8_SAMPLING_TIME_512_ADCCLK                   (0xfU << ADC_ACQ8_CR_SMTS_Pos)

#define    FL_ADC_ACQ9_SELECT_CHANNEL_ADC_INA0                    (0x0U << ADC_ACQ9_CR_CHSEL_Pos)
#define    FL_ADC_ACQ9_SELECT_CHANNEL_ADC_INA1                    (0x1U << ADC_ACQ9_CR_CHSEL_Pos)
#define    FL_ADC_ACQ9_SELECT_CHANNEL_ADC_INA2                    (0x2U << ADC_ACQ9_CR_CHSEL_Pos)
#define    FL_ADC_ACQ9_SELECT_CHANNEL_ADC_INA3                    (0x3U << ADC_ACQ9_CR_CHSEL_Pos)
#define    FL_ADC_ACQ9_SELECT_CHANNEL_ADC_INA4                    (0x4U << ADC_ACQ9_CR_CHSEL_Pos)
#define    FL_ADC_ACQ9_SELECT_CHANNEL_ADC_INA5                    (0x5U << ADC_ACQ9_CR_CHSEL_Pos)
#define    FL_ADC_ACQ9_SELECT_CHANNEL_ADC_INA6                    (0x6U << ADC_ACQ9_CR_CHSEL_Pos)
#define    FL_ADC_ACQ9_SELECT_CHANNEL_ADC_INA7                    (0x7U << ADC_ACQ9_CR_CHSEL_Pos)
#define    FL_ADC_ACQ9_SELECT_CHANNEL_ADC_INB8_OPA0_OUT           (0x8U << ADC_ACQ9_CR_CHSEL_Pos)
#define    FL_ADC_ACQ9_SELECT_CHANNEL_TS                          (0x9U << ADC_ACQ9_CR_CHSEL_Pos)
#define    FL_ADC_ACQ9_SELECT_CHANNEL_AVREF                       (0xaU << ADC_ACQ9_CR_CHSEL_Pos)
#define    FL_ADC_ACQ9_SELECT_CHANNEL_P_CALIBRATION               (0xcU << ADC_ACQ9_CR_CHSEL_Pos)
#define    FL_ADC_ACQ9_SELECT_CHANNEL_ADC_INB0                    (0x10U << ADC_ACQ9_CR_CHSEL_Pos)
#define    FL_ADC_ACQ9_SELECT_CHANNEL_ADC_INB1                    (0x11U << ADC_ACQ9_CR_CHSEL_Pos)
#define    FL_ADC_ACQ9_SELECT_CHANNEL_ADC_INB2                    (0x12U << ADC_ACQ9_CR_CHSEL_Pos)
#define    FL_ADC_ACQ9_SELECT_CHANNEL_ADC_INB3                    (0x13U << ADC_ACQ9_CR_CHSEL_Pos)
#define    FL_ADC_ACQ9_SELECT_CHANNEL_ADC_INB4                    (0x14U << ADC_ACQ9_CR_CHSEL_Pos)
#define    FL_ADC_ACQ9_SELECT_CHANNEL_ADC_INB5                    (0x15U << ADC_ACQ9_CR_CHSEL_Pos)
#define    FL_ADC_ACQ9_SELECT_CHANNEL_ADC_INB6                    (0x16U << ADC_ACQ9_CR_CHSEL_Pos)
#define    FL_ADC_ACQ9_SELECT_CHANNEL_ADC_INB7                    (0x17U << ADC_ACQ9_CR_CHSEL_Pos)
#define    FL_ADC_ACQ9_SELECT_CHANNEL_ADC_INB8_OPA1_OUT           (0x18U << ADC_ACQ9_CR_CHSEL_Pos)
#define    FL_ADC_ACQ9_SELECT_CHANNEL_VBAT_DIV3                  (0x19U << ADC_ACQ9_CR_CHSEL_Pos)
#define    FL_ADC_ACQ9_SELECT_CHANNEL_DAC1_OUT1                   (0x1aU << ADC_ACQ9_CR_CHSEL_Pos)
#define    FL_ADC_ACQ9_SELECT_CHANNEL_N_CALIBRATION               (0x1cU << ADC_ACQ9_CR_CHSEL_Pos)

#define    FL_ADC_ACQ9_TRGI_SOFE_TRG                              (0x0U << ADC_ACQ9_CR_TRIGSEL_Pos)
#define    FL_ADC_ACQ9_TRGI_LUT0_TRG                              (0x1U << ADC_ACQ9_CR_TRIGSEL_Pos)
#define    FL_ADC_ACQ9_TRGI_LUT1_TRG                              (0x2U << ADC_ACQ9_CR_TRIGSEL_Pos)
#define    FL_ADC_ACQ9_TRGI_LUT2_TRG                              (0x3U << ADC_ACQ9_CR_TRIGSEL_Pos)
#define    FL_ADC_ACQ9_TRGI_LUT3_TRG                              (0x4U << ADC_ACQ9_CR_TRIGSEL_Pos)
#define    FL_ADC_ACQ9_TRGI_ATIM0_TRGO                            (0x5U << ADC_ACQ9_CR_TRIGSEL_Pos)
#define    FL_ADC_ACQ9_TRGI_ATIM1_TRGO                            (0x6U << ADC_ACQ9_CR_TRIGSEL_Pos)
#define    FL_ADC_ACQ9_TRGI_ATIM0_TRGO2                           (0x7U << ADC_ACQ9_CR_TRIGSEL_Pos)
#define    FL_ADC_ACQ9_TRGI_ATIM1_TRGO2                           (0x8U << ADC_ACQ9_CR_TRIGSEL_Pos)
#define    FL_ADC_ACQ9_TRGI_GPTIM0_TRGO                           (0x9U << ADC_ACQ9_CR_TRIGSEL_Pos)
#define    FL_ADC_ACQ9_TRGI_GPTIM1_TRGO                           (0xaU << ADC_ACQ9_CR_TRIGSEL_Pos)
#define    FL_ADC_ACQ9_TRGI_GPTIM2_TRGO                           (0xbU << ADC_ACQ9_CR_TRIGSEL_Pos)
#define    FL_ADC_ACQ9_TRGI_EPWM0SOCA                             (0xcU << ADC_ACQ9_CR_TRIGSEL_Pos)
#define    FL_ADC_ACQ9_TRGI_EPWM0SOCB                             (0xdU << ADC_ACQ9_CR_TRIGSEL_Pos)
#define    FL_ADC_ACQ9_TRGI_EPWM1SOCA                             (0xeU << ADC_ACQ9_CR_TRIGSEL_Pos)
#define    FL_ADC_ACQ9_TRGI_EPWM1SOCB                             (0xfU << ADC_ACQ9_CR_TRIGSEL_Pos)
#define    FL_ADC_ACQ9_TRGI_EPWM2SOCA                             (0x10U << ADC_ACQ9_CR_TRIGSEL_Pos)
#define    FL_ADC_ACQ9_TRGI_EPWM2SOCB                             (0x11U << ADC_ACQ9_CR_TRIGSEL_Pos)
#define    FL_ADC_ACQ9_TRGI_EPWM3SOCA                             (0x12U << ADC_ACQ9_CR_TRIGSEL_Pos)
#define    FL_ADC_ACQ9_TRGI_EPWM3SOCB                             (0x13U << ADC_ACQ9_CR_TRIGSEL_Pos)
#define    FL_ADC_ACQ9_TRGI_COMP0_TRGO                            (0x14U << ADC_ACQ9_CR_TRIGSEL_Pos)
#define    FL_ADC_ACQ9_TRGI_COMP1_TRGO                            (0x15U << ADC_ACQ9_CR_TRIGSEL_Pos)
#define    FL_ADC_ACQ9_TRGI_COMP2_TRGO                            (0x16U << ADC_ACQ9_CR_TRIGSEL_Pos)
#define    FL_ADC_ACQ9_TRGI_LPTIM0_TRGO                           (0x17U << ADC_ACQ9_CR_TRIGSEL_Pos)
#define    FL_ADC_ACQ9_TRGI_BSTIM0_TRGO                           (0x18U << ADC_ACQ9_CR_TRIGSEL_Pos)

#define    FL_ADC_ACQ9_SAMPLING_TIME_1_ADCCLK                     (0x0U << ADC_ACQ9_CR_SMTS_Pos)
#define    FL_ADC_ACQ9_SAMPLING_TIME_2_ADCCLK                     (0x1U << ADC_ACQ9_CR_SMTS_Pos)
#define    FL_ADC_ACQ9_SAMPLING_TIME_4_ADCCLK                     (0x2U << ADC_ACQ9_CR_SMTS_Pos)
#define    FL_ADC_ACQ9_SAMPLING_TIME_8_ADCCLK                     (0x3U << ADC_ACQ9_CR_SMTS_Pos)
#define    FL_ADC_ACQ9_SAMPLING_TIME_12_ADCCLK                    (0x4U << ADC_ACQ9_CR_SMTS_Pos)
#define    FL_ADC_ACQ9_SAMPLING_TIME_16_ADCCLK                    (0x5U << ADC_ACQ9_CR_SMTS_Pos)
#define    FL_ADC_ACQ9_SAMPLING_TIME_32_ADCCLK                    (0x6U << ADC_ACQ9_CR_SMTS_Pos)
#define    FL_ADC_ACQ9_SAMPLING_TIME_64_ADCCLK                    (0x7U << ADC_ACQ9_CR_SMTS_Pos)
#define    FL_ADC_ACQ9_SAMPLING_TIME_80_ADCCLK                    (0x8U << ADC_ACQ9_CR_SMTS_Pos)
#define    FL_ADC_ACQ9_SAMPLING_TIME_96_ADCCLK                    (0x9U << ADC_ACQ9_CR_SMTS_Pos)
#define    FL_ADC_ACQ9_SAMPLING_TIME_128_ADCCLK                   (0xaU << ADC_ACQ9_CR_SMTS_Pos)
#define    FL_ADC_ACQ9_SAMPLING_TIME_160_ADCCLK                   (0xbU << ADC_ACQ9_CR_SMTS_Pos)
#define    FL_ADC_ACQ9_SAMPLING_TIME_192_ADCCLK                   (0xcU << ADC_ACQ9_CR_SMTS_Pos)
#define    FL_ADC_ACQ9_SAMPLING_TIME_256_ADCCLK                   (0xdU << ADC_ACQ9_CR_SMTS_Pos)
#define    FL_ADC_ACQ9_SAMPLING_TIME_320_ADCCLK                   (0xeU << ADC_ACQ9_CR_SMTS_Pos)
#define    FL_ADC_ACQ9_SAMPLING_TIME_512_ADCCLK                   (0xfU << ADC_ACQ9_CR_SMTS_Pos)

#define    FL_ADC_ACQ10_SELECT_CHANNEL_ADC_INA0                   (0x0U << ADC_ACQ10_CR_CHSEL_Pos)
#define    FL_ADC_ACQ10_SELECT_CHANNEL_ADC_INA1                   (0x1U << ADC_ACQ10_CR_CHSEL_Pos)
#define    FL_ADC_ACQ10_SELECT_CHANNEL_ADC_INA2                   (0x2U << ADC_ACQ10_CR_CHSEL_Pos)
#define    FL_ADC_ACQ10_SELECT_CHANNEL_ADC_INA3                   (0x3U << ADC_ACQ10_CR_CHSEL_Pos)
#define    FL_ADC_ACQ10_SELECT_CHANNEL_ADC_INA4                   (0x4U << ADC_ACQ10_CR_CHSEL_Pos)
#define    FL_ADC_ACQ10_SELECT_CHANNEL_ADC_INA5                   (0x5U << ADC_ACQ10_CR_CHSEL_Pos)
#define    FL_ADC_ACQ10_SELECT_CHANNEL_ADC_INA6                   (0x6U << ADC_ACQ10_CR_CHSEL_Pos)
#define    FL_ADC_ACQ10_SELECT_CHANNEL_ADC_INA7                   (0x7U << ADC_ACQ10_CR_CHSEL_Pos)
#define    FL_ADC_ACQ10_SELECT_CHANNEL_ADC_INB8_OPA0_OUT          (0x8U << ADC_ACQ10_CR_CHSEL_Pos)
#define    FL_ADC_ACQ10_SELECT_CHANNEL_TS                         (0x9U << ADC_ACQ10_CR_CHSEL_Pos)
#define    FL_ADC_ACQ10_SELECT_CHANNEL_AVREF                      (0xaU << ADC_ACQ10_CR_CHSEL_Pos)
#define    FL_ADC_ACQ10_SELECT_CHANNEL_P_CALIBRATION              (0xcU << ADC_ACQ10_CR_CHSEL_Pos)
#define    FL_ADC_ACQ10_SELECT_CHANNEL_ADC_INB0                   (0x10U << ADC_ACQ10_CR_CHSEL_Pos)
#define    FL_ADC_ACQ10_SELECT_CHANNEL_ADC_INB1                   (0x11U << ADC_ACQ10_CR_CHSEL_Pos)
#define    FL_ADC_ACQ10_SELECT_CHANNEL_ADC_INB2                   (0x12U << ADC_ACQ10_CR_CHSEL_Pos)
#define    FL_ADC_ACQ10_SELECT_CHANNEL_ADC_INB3                   (0x13U << ADC_ACQ10_CR_CHSEL_Pos)
#define    FL_ADC_ACQ10_SELECT_CHANNEL_ADC_INB4                   (0x14U << ADC_ACQ10_CR_CHSEL_Pos)
#define    FL_ADC_ACQ10_SELECT_CHANNEL_ADC_INB5                   (0x15U << ADC_ACQ10_CR_CHSEL_Pos)
#define    FL_ADC_ACQ10_SELECT_CHANNEL_ADC_INB6                   (0x16U << ADC_ACQ10_CR_CHSEL_Pos)
#define    FL_ADC_ACQ10_SELECT_CHANNEL_ADC_INB7                   (0x17U << ADC_ACQ10_CR_CHSEL_Pos)
#define    FL_ADC_ACQ10_SELECT_CHANNEL_ADC_INB8_OPA1_OUT          (0x18U << ADC_ACQ10_CR_CHSEL_Pos)
#define    FL_ADC_ACQ10_SELECT_CHANNEL_VBAT_DIV3                 (0x19U << ADC_ACQ10_CR_CHSEL_Pos)
#define    FL_ADC_ACQ10_SELECT_CHANNEL_DAC1_OUT1                  (0x1aU << ADC_ACQ10_CR_CHSEL_Pos)
#define    FL_ADC_ACQ10_SELECT_CHANNEL_N_CALIBRATION              (0x1cU << ADC_ACQ10_CR_CHSEL_Pos)

#define    FL_ADC_ACQ10_TRGI_SOFE_TRG                             (0x0U << ADC_ACQ10_CR_TRIGSEL_Pos)
#define    FL_ADC_ACQ10_TRGI_LUT0_TRG                             (0x1U << ADC_ACQ10_CR_TRIGSEL_Pos)
#define    FL_ADC_ACQ10_TRGI_LUT1_TRG                             (0x2U << ADC_ACQ10_CR_TRIGSEL_Pos)
#define    FL_ADC_ACQ10_TRGI_LUT2_TRG                             (0x3U << ADC_ACQ10_CR_TRIGSEL_Pos)
#define    FL_ADC_ACQ10_TRGI_LUT3_TRG                             (0x4U << ADC_ACQ10_CR_TRIGSEL_Pos)
#define    FL_ADC_ACQ10_TRGI_ATIM0_TRGO                           (0x5U << ADC_ACQ10_CR_TRIGSEL_Pos)
#define    FL_ADC_ACQ10_TRGI_ATIM1_TRGO                           (0x6U << ADC_ACQ10_CR_TRIGSEL_Pos)
#define    FL_ADC_ACQ10_TRGI_ATIM0_TRGO2                          (0x7U << ADC_ACQ10_CR_TRIGSEL_Pos)
#define    FL_ADC_ACQ10_TRGI_ATIM1_TRGO2                          (0x8U << ADC_ACQ10_CR_TRIGSEL_Pos)
#define    FL_ADC_ACQ10_TRGI_GPTIM0_TRGO                          (0x9U << ADC_ACQ10_CR_TRIGSEL_Pos)
#define    FL_ADC_ACQ10_TRGI_GPTIM1_TRGO                          (0xaU << ADC_ACQ10_CR_TRIGSEL_Pos)
#define    FL_ADC_ACQ10_TRGI_GPTIM2_TRGO                          (0xbU << ADC_ACQ10_CR_TRIGSEL_Pos)
#define    FL_ADC_ACQ10_TRGI_EPWM0SOCA                            (0xcU << ADC_ACQ10_CR_TRIGSEL_Pos)
#define    FL_ADC_ACQ10_TRGI_EPWM0SOCB                            (0xdU << ADC_ACQ10_CR_TRIGSEL_Pos)
#define    FL_ADC_ACQ10_TRGI_EPWM1SOCA                            (0xeU << ADC_ACQ10_CR_TRIGSEL_Pos)
#define    FL_ADC_ACQ10_TRGI_EPWM1SOCB                            (0xfU << ADC_ACQ10_CR_TRIGSEL_Pos)
#define    FL_ADC_ACQ10_TRGI_EPWM2SOCA                            (0x10U << ADC_ACQ10_CR_TRIGSEL_Pos)
#define    FL_ADC_ACQ10_TRGI_EPWM2SOCB                            (0x11U << ADC_ACQ10_CR_TRIGSEL_Pos)
#define    FL_ADC_ACQ10_TRGI_EPWM3SOCA                            (0x12U << ADC_ACQ10_CR_TRIGSEL_Pos)
#define    FL_ADC_ACQ10_TRGI_EPWM3SOCB                            (0x13U << ADC_ACQ10_CR_TRIGSEL_Pos)
#define    FL_ADC_ACQ10_TRGI_COMP0_TRGO                           (0x14U << ADC_ACQ10_CR_TRIGSEL_Pos)
#define    FL_ADC_ACQ10_TRGI_COMP1_TRGO                           (0x15U << ADC_ACQ10_CR_TRIGSEL_Pos)
#define    FL_ADC_ACQ10_TRGI_COMP2_TRGO                           (0x16U << ADC_ACQ10_CR_TRIGSEL_Pos)
#define    FL_ADC_ACQ10_TRGI_LPTIM0_TRGO                          (0x17U << ADC_ACQ10_CR_TRIGSEL_Pos)
#define    FL_ADC_ACQ10_TRGI_BSTIM0_TRGO                          (0x18U << ADC_ACQ10_CR_TRIGSEL_Pos)

#define    FL_ADC_ACQ10_SAMPLING_TIME_1_ADCCLK                    (0x0U << ADC_ACQ10_CR_SMTS_Pos)
#define    FL_ADC_ACQ10_SAMPLING_TIME_2_ADCCLK                    (0x1U << ADC_ACQ10_CR_SMTS_Pos)
#define    FL_ADC_ACQ10_SAMPLING_TIME_4_ADCCLK                    (0x2U << ADC_ACQ10_CR_SMTS_Pos)
#define    FL_ADC_ACQ10_SAMPLING_TIME_8_ADCCLK                    (0x3U << ADC_ACQ10_CR_SMTS_Pos)
#define    FL_ADC_ACQ10_SAMPLING_TIME_12_ADCCLK                   (0x4U << ADC_ACQ10_CR_SMTS_Pos)
#define    FL_ADC_ACQ10_SAMPLING_TIME_16_ADCCLK                   (0x5U << ADC_ACQ10_CR_SMTS_Pos)
#define    FL_ADC_ACQ10_SAMPLING_TIME_32_ADCCLK                   (0x6U << ADC_ACQ10_CR_SMTS_Pos)
#define    FL_ADC_ACQ10_SAMPLING_TIME_64_ADCCLK                   (0x7U << ADC_ACQ10_CR_SMTS_Pos)
#define    FL_ADC_ACQ10_SAMPLING_TIME_80_ADCCLK                   (0x8U << ADC_ACQ10_CR_SMTS_Pos)
#define    FL_ADC_ACQ10_SAMPLING_TIME_96_ADCCLK                   (0x9U << ADC_ACQ10_CR_SMTS_Pos)
#define    FL_ADC_ACQ10_SAMPLING_TIME_128_ADCCLK                  (0xaU << ADC_ACQ10_CR_SMTS_Pos)
#define    FL_ADC_ACQ10_SAMPLING_TIME_160_ADCCLK                  (0xbU << ADC_ACQ10_CR_SMTS_Pos)
#define    FL_ADC_ACQ10_SAMPLING_TIME_192_ADCCLK                  (0xcU << ADC_ACQ10_CR_SMTS_Pos)
#define    FL_ADC_ACQ10_SAMPLING_TIME_256_ADCCLK                  (0xdU << ADC_ACQ10_CR_SMTS_Pos)
#define    FL_ADC_ACQ10_SAMPLING_TIME_320_ADCCLK                  (0xeU << ADC_ACQ10_CR_SMTS_Pos)
#define    FL_ADC_ACQ10_SAMPLING_TIME_512_ADCCLK                  (0xfU << ADC_ACQ10_CR_SMTS_Pos)

#define    FL_ADC_ACQ11_SELECT_CHANNEL_ADC_INA0                   (0x0U << ADC_ACQ11_CR_CHSEL_Pos)
#define    FL_ADC_ACQ11_SELECT_CHANNEL_ADC_INA1                   (0x1U << ADC_ACQ11_CR_CHSEL_Pos)
#define    FL_ADC_ACQ11_SELECT_CHANNEL_ADC_INA2                   (0x2U << ADC_ACQ11_CR_CHSEL_Pos)
#define    FL_ADC_ACQ11_SELECT_CHANNEL_ADC_INA3                   (0x3U << ADC_ACQ11_CR_CHSEL_Pos)
#define    FL_ADC_ACQ11_SELECT_CHANNEL_ADC_INA4                   (0x4U << ADC_ACQ11_CR_CHSEL_Pos)
#define    FL_ADC_ACQ11_SELECT_CHANNEL_ADC_INA5                   (0x5U << ADC_ACQ11_CR_CHSEL_Pos)
#define    FL_ADC_ACQ11_SELECT_CHANNEL_ADC_INA6                   (0x6U << ADC_ACQ11_CR_CHSEL_Pos)
#define    FL_ADC_ACQ11_SELECT_CHANNEL_ADC_INA7                   (0x7U << ADC_ACQ11_CR_CHSEL_Pos)
#define    FL_ADC_ACQ11_SELECT_CHANNEL_ADC_INB8_OPA0_OUT          (0x8U << ADC_ACQ11_CR_CHSEL_Pos)
#define    FL_ADC_ACQ11_SELECT_CHANNEL_TS                         (0x9U << ADC_ACQ11_CR_CHSEL_Pos)
#define    FL_ADC_ACQ11_SELECT_CHANNEL_AVREF                      (0xaU << ADC_ACQ11_CR_CHSEL_Pos)
#define    FL_ADC_ACQ11_SELECT_CHANNEL_P_CALIBRATION              (0xcU << ADC_ACQ11_CR_CHSEL_Pos)
#define    FL_ADC_ACQ11_SELECT_CHANNEL_ADC_INB0                   (0x10U << ADC_ACQ11_CR_CHSEL_Pos)
#define    FL_ADC_ACQ11_SELECT_CHANNEL_ADC_INB1                   (0x11U << ADC_ACQ11_CR_CHSEL_Pos)
#define    FL_ADC_ACQ11_SELECT_CHANNEL_ADC_INB2                   (0x12U << ADC_ACQ11_CR_CHSEL_Pos)
#define    FL_ADC_ACQ11_SELECT_CHANNEL_ADC_INB3                   (0x13U << ADC_ACQ11_CR_CHSEL_Pos)
#define    FL_ADC_ACQ11_SELECT_CHANNEL_ADC_INB4                   (0x14U << ADC_ACQ11_CR_CHSEL_Pos)
#define    FL_ADC_ACQ11_SELECT_CHANNEL_ADC_INB5                   (0x15U << ADC_ACQ11_CR_CHSEL_Pos)
#define    FL_ADC_ACQ11_SELECT_CHANNEL_ADC_INB6                   (0x16U << ADC_ACQ11_CR_CHSEL_Pos)
#define    FL_ADC_ACQ11_SELECT_CHANNEL_ADC_INB7                   (0x17U << ADC_ACQ11_CR_CHSEL_Pos)
#define    FL_ADC_ACQ11_SELECT_CHANNEL_ADC_INB8_OPA1_OUT          (0x18U << ADC_ACQ11_CR_CHSEL_Pos)
#define    FL_ADC_ACQ11_SELECT_CHANNEL_VBAT_DIV3                 (0x19U << ADC_ACQ11_CR_CHSEL_Pos)
#define    FL_ADC_ACQ11_SELECT_CHANNEL_DAC1_OUT1                  (0x1aU << ADC_ACQ11_CR_CHSEL_Pos)
#define    FL_ADC_ACQ11_SELECT_CHANNEL_N_CALIBRATION              (0x1cU << ADC_ACQ11_CR_CHSEL_Pos)

#define    FL_ADC_ACQ11_TRGI_SOFE_TRG                             (0x0U << ADC_ACQ11_CR_TRIGSEL_Pos)
#define    FL_ADC_ACQ11_TRGI_LUT0_TRG                             (0x1U << ADC_ACQ11_CR_TRIGSEL_Pos)
#define    FL_ADC_ACQ11_TRGI_LUT1_TRG                             (0x2U << ADC_ACQ11_CR_TRIGSEL_Pos)
#define    FL_ADC_ACQ11_TRGI_LUT2_TRG                             (0x3U << ADC_ACQ11_CR_TRIGSEL_Pos)
#define    FL_ADC_ACQ11_TRGI_LUT3_TRG                             (0x4U << ADC_ACQ11_CR_TRIGSEL_Pos)
#define    FL_ADC_ACQ11_TRGI_ATIM0_TRGO                           (0x5U << ADC_ACQ11_CR_TRIGSEL_Pos)
#define    FL_ADC_ACQ11_TRGI_ATIM1_TRGO                           (0x6U << ADC_ACQ11_CR_TRIGSEL_Pos)
#define    FL_ADC_ACQ11_TRGI_ATIM0_TRGO2                          (0x7U << ADC_ACQ11_CR_TRIGSEL_Pos)
#define    FL_ADC_ACQ11_TRGI_ATIM1_TRGO2                          (0x8U << ADC_ACQ11_CR_TRIGSEL_Pos)
#define    FL_ADC_ACQ11_TRGI_GPTIM0_TRGO                          (0x9U << ADC_ACQ11_CR_TRIGSEL_Pos)
#define    FL_ADC_ACQ11_TRGI_GPTIM1_TRGO                          (0xaU << ADC_ACQ11_CR_TRIGSEL_Pos)
#define    FL_ADC_ACQ11_TRGI_GPTIM2_TRGO                          (0xbU << ADC_ACQ11_CR_TRIGSEL_Pos)
#define    FL_ADC_ACQ11_TRGI_EPWM0SOCA                            (0xcU << ADC_ACQ11_CR_TRIGSEL_Pos)
#define    FL_ADC_ACQ11_TRGI_EPWM0SOCB                            (0xdU << ADC_ACQ11_CR_TRIGSEL_Pos)
#define    FL_ADC_ACQ11_TRGI_EPWM1SOCA                            (0xeU << ADC_ACQ11_CR_TRIGSEL_Pos)
#define    FL_ADC_ACQ11_TRGI_EPWM1SOCB                            (0xfU << ADC_ACQ11_CR_TRIGSEL_Pos)
#define    FL_ADC_ACQ11_TRGI_EPWM2SOCA                            (0x10U << ADC_ACQ11_CR_TRIGSEL_Pos)
#define    FL_ADC_ACQ11_TRGI_EPWM2SOCB                            (0x11U << ADC_ACQ11_CR_TRIGSEL_Pos)
#define    FL_ADC_ACQ11_TRGI_EPWM3SOCA                            (0x12U << ADC_ACQ11_CR_TRIGSEL_Pos)
#define    FL_ADC_ACQ11_TRGI_EPWM3SOCB                            (0x13U << ADC_ACQ11_CR_TRIGSEL_Pos)
#define    FL_ADC_ACQ11_TRGI_COMP0_TRGO                           (0x14U << ADC_ACQ11_CR_TRIGSEL_Pos)
#define    FL_ADC_ACQ11_TRGI_COMP1_TRGO                           (0x15U << ADC_ACQ11_CR_TRIGSEL_Pos)
#define    FL_ADC_ACQ11_TRGI_COMP2_TRGO                           (0x16U << ADC_ACQ11_CR_TRIGSEL_Pos)
#define    FL_ADC_ACQ11_TRGI_LPTIM0_TRGO                          (0x17U << ADC_ACQ11_CR_TRIGSEL_Pos)
#define    FL_ADC_ACQ11_TRGI_BSTIM0_TRGO                          (0x18U << ADC_ACQ11_CR_TRIGSEL_Pos)

#define    FL_ADC_ACQ11_SAMPLING_TIME_1_ADCCLK                    (0x0U << ADC_ACQ11_CR_SMTS_Pos)
#define    FL_ADC_ACQ11_SAMPLING_TIME_2_ADCCLK                    (0x1U << ADC_ACQ11_CR_SMTS_Pos)
#define    FL_ADC_ACQ11_SAMPLING_TIME_4_ADCCLK                    (0x2U << ADC_ACQ11_CR_SMTS_Pos)
#define    FL_ADC_ACQ11_SAMPLING_TIME_8_ADCCLK                    (0x3U << ADC_ACQ11_CR_SMTS_Pos)
#define    FL_ADC_ACQ11_SAMPLING_TIME_12_ADCCLK                   (0x4U << ADC_ACQ11_CR_SMTS_Pos)
#define    FL_ADC_ACQ11_SAMPLING_TIME_16_ADCCLK                   (0x5U << ADC_ACQ11_CR_SMTS_Pos)
#define    FL_ADC_ACQ11_SAMPLING_TIME_32_ADCCLK                   (0x6U << ADC_ACQ11_CR_SMTS_Pos)
#define    FL_ADC_ACQ11_SAMPLING_TIME_64_ADCCLK                   (0x7U << ADC_ACQ11_CR_SMTS_Pos)
#define    FL_ADC_ACQ11_SAMPLING_TIME_80_ADCCLK                   (0x8U << ADC_ACQ11_CR_SMTS_Pos)
#define    FL_ADC_ACQ11_SAMPLING_TIME_96_ADCCLK                   (0x9U << ADC_ACQ11_CR_SMTS_Pos)
#define    FL_ADC_ACQ11_SAMPLING_TIME_128_ADCCLK                  (0xaU << ADC_ACQ11_CR_SMTS_Pos)
#define    FL_ADC_ACQ11_SAMPLING_TIME_160_ADCCLK                  (0xbU << ADC_ACQ11_CR_SMTS_Pos)
#define    FL_ADC_ACQ11_SAMPLING_TIME_192_ADCCLK                  (0xcU << ADC_ACQ11_CR_SMTS_Pos)
#define    FL_ADC_ACQ11_SAMPLING_TIME_256_ADCCLK                  (0xdU << ADC_ACQ11_CR_SMTS_Pos)
#define    FL_ADC_ACQ11_SAMPLING_TIME_320_ADCCLK                  (0xeU << ADC_ACQ11_CR_SMTS_Pos)
#define    FL_ADC_ACQ11_SAMPLING_TIME_512_ADCCLK                  (0xfU << ADC_ACQ11_CR_SMTS_Pos)

#define    FL_ADC_ACQ12_SELECT_CHANNEL_ADC_INA0                   (0x0U << ADC_ACQ12_CR_CHSEL_Pos)
#define    FL_ADC_ACQ12_SELECT_CHANNEL_ADC_INA1                   (0x1U << ADC_ACQ12_CR_CHSEL_Pos)
#define    FL_ADC_ACQ12_SELECT_CHANNEL_ADC_INA2                   (0x2U << ADC_ACQ12_CR_CHSEL_Pos)
#define    FL_ADC_ACQ12_SELECT_CHANNEL_ADC_INA3                   (0x3U << ADC_ACQ12_CR_CHSEL_Pos)
#define    FL_ADC_ACQ12_SELECT_CHANNEL_ADC_INA4                   (0x4U << ADC_ACQ12_CR_CHSEL_Pos)
#define    FL_ADC_ACQ12_SELECT_CHANNEL_ADC_INA5                   (0x5U << ADC_ACQ12_CR_CHSEL_Pos)
#define    FL_ADC_ACQ12_SELECT_CHANNEL_ADC_INA6                   (0x6U << ADC_ACQ12_CR_CHSEL_Pos)
#define    FL_ADC_ACQ12_SELECT_CHANNEL_ADC_INA7                   (0x7U << ADC_ACQ12_CR_CHSEL_Pos)
#define    FL_ADC_ACQ12_SELECT_CHANNEL_ADC_INB8_OPA0_OUT          (0x8U << ADC_ACQ12_CR_CHSEL_Pos)
#define    FL_ADC_ACQ12_SELECT_CHANNEL_TS                         (0x9U << ADC_ACQ12_CR_CHSEL_Pos)
#define    FL_ADC_ACQ12_SELECT_CHANNEL_AVREF                      (0xaU << ADC_ACQ12_CR_CHSEL_Pos)
#define    FL_ADC_ACQ12_SELECT_CHANNEL_P_CALIBRATION              (0xcU << ADC_ACQ12_CR_CHSEL_Pos)
#define    FL_ADC_ACQ12_SELECT_CHANNEL_ADC_INB0                   (0x10U << ADC_ACQ12_CR_CHSEL_Pos)
#define    FL_ADC_ACQ12_SELECT_CHANNEL_ADC_INB1                   (0x11U << ADC_ACQ12_CR_CHSEL_Pos)
#define    FL_ADC_ACQ12_SELECT_CHANNEL_ADC_INB2                   (0x12U << ADC_ACQ12_CR_CHSEL_Pos)
#define    FL_ADC_ACQ12_SELECT_CHANNEL_ADC_INB3                   (0x13U << ADC_ACQ12_CR_CHSEL_Pos)
#define    FL_ADC_ACQ12_SELECT_CHANNEL_ADC_INB4                   (0x14U << ADC_ACQ12_CR_CHSEL_Pos)
#define    FL_ADC_ACQ12_SELECT_CHANNEL_ADC_INB5                   (0x15U << ADC_ACQ12_CR_CHSEL_Pos)
#define    FL_ADC_ACQ12_SELECT_CHANNEL_ADC_INB6                   (0x16U << ADC_ACQ12_CR_CHSEL_Pos)
#define    FL_ADC_ACQ12_SELECT_CHANNEL_ADC_INB7                   (0x17U << ADC_ACQ12_CR_CHSEL_Pos)
#define    FL_ADC_ACQ12_SELECT_CHANNEL_ADC_INB8_OPA1_OUT          (0x18U << ADC_ACQ12_CR_CHSEL_Pos)
#define    FL_ADC_ACQ12_SELECT_CHANNEL_VBAT_DIV3                 (0x19U << ADC_ACQ12_CR_CHSEL_Pos)
#define    FL_ADC_ACQ12_SELECT_CHANNEL_DAC1_OUT1                  (0x1aU << ADC_ACQ12_CR_CHSEL_Pos)
#define    FL_ADC_ACQ12_SELECT_CHANNEL_N_CALIBRATION              (0x1cU << ADC_ACQ12_CR_CHSEL_Pos)
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
