rEDTii/EATWHAT/Drivers/FM33FK5xx_FL_Driver/Inc/fm33fk5xx_fl_dac.h

/**
  *******************************************************************************************************
  * @file    fm33fk5xx_fl_dac.h
  * @author  FMSH Application Team
  * @brief   Head file of DAC FL Module
  *******************************************************************************************************
  * @attention
  *
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
  *******************************************************************************************************
  */

/* Define to prevent recursive inclusion---------------------------------------------------------------*/
#ifndef __FM33FK5XX_FL_DAC_H
#define __FM33FK5XX_FL_DAC_H

#ifdef __cplusplus
extern "C" {
#endif
/* Includes -------------------------------------------------------------------------------------------*/
#include "fm33fk5xx_fl_def.h"
/** @addtogroup FM33FK5XX_FL_Driver
  * @{
  */
/* Exported types -------------------------------------------------------------------------------------*/
/** @defgroup DAC_FL_ES_INIT DAC Exported Init structures
  * @{
  */

/**
  * @brief FL DAC Init Sturcture definition
  */
typedef struct
{
    /*DAC触发模式使能配置*/
    uint32_t triggerMode;
    /*DAC触发源配置*/
    uint32_t triggerSource;
    /*DAC输出开关配置*/
    uint32_t switchMode;
    /*DAC采样模式*/
    uint32_t sampleMode;
    /*DAC输出buffer配置*/
    uint32_t bufferMode;
    /*DAC保持时间配置*/
    uint32_t timeHold;
    /*DAC采样时间配置*/
    uint32_t timeSample;

} FL_DAC_InitTypeDef;
/**
  * @}
  */
/* Exported constants ---------------------------------------------------------------------------------*/
/** @defgroup DAC_FL_Exported_Constants DAC Exported Constants
  * @{
  */

#define    DAC_CR1_EN_Pos                                         (0U)
#define    DAC_CR1_EN_Msk                                         (0x1U << DAC_CR1_EN_Pos)
#define    DAC_CR1_EN                                             DAC_CR1_EN_Msk

#define    DAC_CR2_DMAEN_Pos                                      (1U)
#define    DAC_CR2_DMAEN_Msk                                      (0x1U << DAC_CR2_DMAEN_Pos)
#define    DAC_CR2_DMAEN                                          DAC_CR2_DMAEN_Msk

#define    DAC_CR2_TRGEN_Pos                                      (0U)
#define    DAC_CR2_TRGEN_Msk                                      (0x1U << DAC_CR2_TRGEN_Pos)
#define    DAC_CR2_TRGEN                                          DAC_CR2_TRGEN_Msk

#define    DAC_CFGR_SHEN_Pos                                      (8U)
#define    DAC_CFGR_SHEN_Msk                                      (0x1U << DAC_CFGR_SHEN_Pos)
#define    DAC_CFGR_SHEN                                          DAC_CFGR_SHEN_Msk

#define    DAC_CFGR_BUFEN_Pos                                     (7U)
#define    DAC_CFGR_BUFEN_Msk                                     (0x1U << DAC_CFGR_BUFEN_Pos)
#define    DAC_CFGR_BUFEN                                         DAC_CFGR_BUFEN_Msk

#define    DAC_CFGR_TRGSEL_Pos                                    (2U)
#define    DAC_CFGR_TRGSEL_Msk                                    (0xfU << DAC_CFGR_TRGSEL_Pos)
#define    DAC_CFGR_TRGSEL                                        DAC_CFGR_TRGSEL_Msk

#define    DAC_CFGR_SWIEN_Pos                                     (0U)
#define    DAC_CFGR_SWIEN_Msk                                     (0x1U << DAC_CFGR_SWIEN_Pos)
#define    DAC_CFGR_SWIEN                                         DAC_CFGR_SWIEN_Msk

#define    DAC_SWTRGR_SWTRIG_Pos                                  (0U)
#define    DAC_SWTRGR_SWTRIG_Msk                                  (0x1U << DAC_SWTRGR_SWTRIG_Pos)
#define    DAC_SWTRGR_SWTRIG                                      DAC_SWTRGR_SWTRIG_Msk

#define    DAC_DHR_DHR_Pos                                        (0U)
#define    DAC_DHR_DHR_Msk                                        (0xfffU << DAC_DHR_DHR_Pos)
#define    DAC_DHR_DHR                                            DAC_DHR_DHR_Msk

#define    DAC_IER_DMAERR_Pos                                     (3U)
#define    DAC_IER_DMAERR_Msk                                     (0x1U << DAC_IER_DMAERR_Pos)
#define    DAC_IER_DMAERR                                         DAC_IER_DMAERR_Msk

#define    DAC_IER_EOH_Pos                                        (2U)
#define    DAC_IER_EOH_Msk                                        (0x1U << DAC_IER_EOH_Pos)
#define    DAC_IER_EOH                                            DAC_IER_EOH_Msk

#define    DAC_IER_EOS_Pos                                        (1U)
#define    DAC_IER_EOS_Msk                                        (0x1U << DAC_IER_EOS_Pos)
#define    DAC_IER_EOS                                            DAC_IER_EOS_Msk

#define    DAC_IER_DOU_Pos                                        (0U)
#define    DAC_IER_DOU_Msk                                        (0x1U << DAC_IER_DOU_Pos)
#define    DAC_IER_DOU                                            DAC_IER_DOU_Msk

#define    DAC_ISR_DMAERR_Pos                                     (3U)
#define    DAC_ISR_DMAERR_Msk                                     (0x1U << DAC_ISR_DMAERR_Pos)
#define    DAC_ISR_DMAERR                                         DAC_ISR_DMAERR_Msk

#define    DAC_ISR_EOH_Pos                                        (2U)
#define    DAC_ISR_EOH_Msk                                        (0x1U << DAC_ISR_EOH_Pos)
#define    DAC_ISR_EOH                                            DAC_ISR_EOH_Msk

#define    DAC_ISR_EOS_Pos                                        (1U)
#define    DAC_ISR_EOS_Msk                                        (0x1U << DAC_ISR_EOS_Pos)
#define    DAC_ISR_EOS                                            DAC_ISR_EOS_Msk

#define    DAC_ISR_DOU_Pos                                        (0U)
#define    DAC_ISR_DOU_Msk                                        (0x1U << DAC_ISR_DOU_Pos)
#define    DAC_ISR_DOU                                            DAC_ISR_DOU_Msk

#define    DAC_SHTR_THLD_Pos                                      (8U)
#define    DAC_SHTR_THLD_Msk                                      (0xffffU << DAC_SHTR_THLD_Pos)
#define    DAC_SHTR_THLD                                          DAC_SHTR_THLD_Msk

#define    DAC_SHTR_TSMPL_Pos                                     (0U)
#define    DAC_SHTR_TSMPL_Msk                                     (0xffU << DAC_SHTR_TSMPL_Pos)
#define    DAC_SHTR_TSMPL                                         DAC_SHTR_TSMPL_Msk

#define    FL_DAC_TRGI_SOFTWARE                                   (0x0U << DAC_CFGR_TRGSEL_Pos)
#define    FL_DAC_TRGI_ATIM0                                      (0x1U << DAC_CFGR_TRGSEL_Pos)
#define    FL_DAC_TRGI_ATIM1                                      (0x2U << DAC_CFGR_TRGSEL_Pos)
#define    FL_DAC_TRGI_GPTIM0                                     (0x3U << DAC_CFGR_TRGSEL_Pos)
#define    FL_DAC_TRGI_GPTIM1                                     (0x4U << DAC_CFGR_TRGSEL_Pos)
#define    FL_DAC_TRGI_GPTIM2                                     (0x5U << DAC_CFGR_TRGSEL_Pos)
#define    FL_DAC_TRGI_BSTIM16                                    (0x6U << DAC_CFGR_TRGSEL_Pos)
#define    FL_DAC_TRGI_LPTIM16                                    (0x7U << DAC_CFGR_TRGSEL_Pos)
#define    FL_DAC_TRGI_EXTIA                                      (0xaU << DAC_CFGR_TRGSEL_Pos)
#define    FL_DAC_TRGI_EXTIB                                      (0xbU << DAC_CFGR_TRGSEL_Pos)
#define    FL_DAC_TRGI_EXTIC                                      (0xcU << DAC_CFGR_TRGSEL_Pos)
#define    FL_DAC_TRGI_EXTID                                      (0xdU << DAC_CFGR_TRGSEL_Pos)
#define    FL_DAC_TRGI_EXTIE                                      (0xeU << DAC_CFGR_TRGSEL_Pos)
#define    FL_DAC_TRGI_EXTIF                                      (0xfU << DAC_CFGR_TRGSEL_Pos)

#define    FL_DAC_SAMPLE_CONTINUE                                  (0x0U << DAC_CFGR_SHEN_Pos)
#define    FL_DAC_SAMPLE_SAMPLEHOLD                                (0x1U << DAC_CFGR_SHEN_Pos)
/**
  * @}
  */
/* Exported functions ---------------------------------------------------------------------------------*/
/** @defgroup DAC_FL_Exported_Functions DAC Exported Functions
  * @{
  */

/**
  * @brief    Enable DAC
  * @rmtoll   CR1    EN    FL_DAC_Enable
  * @param    DACx DAC instance
  * @retval   None
  */
__STATIC_INLINE void FL_DAC_Enable(DAC_Type *DACx)
{
    SET_BIT(DACx->CR1, DAC_CR1_EN_Msk);
}

/**
  * @brief    Disable DAC
  * @rmtoll   CR1    EN    FL_DAC_Disable
  * @param    DACx DAC instance
  * @retval   None
  */
__STATIC_INLINE void FL_DAC_Disable(DAC_Type *DACx)
{
    CLEAR_BIT(DACx->CR1, DAC_CR1_EN_Msk);
}

/**
  * @brief    Get DAC Enable Status
  * @rmtoll   CR1    EN    FL_DAC_IsEnabled
  * @param    DACx DAC instance
  * @retval   State of bit (1 or 0).
  */
__STATIC_INLINE uint32_t FL_DAC_IsEnabled(DAC_Type *DACx)
{
    return (uint32_t)(READ_BIT(DACx->CR1, DAC_CR1_EN_Msk) == DAC_CR1_EN_Msk);
}

/**
  * @brief    Enable DAC DMA
  * @rmtoll   CR2    DMAEN    FL_DAC_EnableDMAReq
  * @param    DACx DAC instance
  * @retval   None
  */
__STATIC_INLINE void FL_DAC_EnableDMAReq(DAC_Type *DACx)
{
    SET_BIT(DACx->CR2, DAC_CR2_DMAEN_Msk);
}

/**
  * @brief    Disable DAC DMA
  * @rmtoll   CR2    DMAEN    FL_DAC_DisableDMAReq
  * @param    DACx DAC instance
  * @retval   None
  */
__STATIC_INLINE void FL_DAC_DisableDMAReq(DAC_Type *DACx)
{
    CLEAR_BIT(DACx->CR2, DAC_CR2_DMAEN_Msk);
}

/**
  * @brief    Get DAC DMA Enable Status
  * @rmtoll   CR2    DMAEN    FL_DAC_IsEnabledDMAReq
  * @param    DACx DAC instance
  * @retval   State of bit (1 or 0).
  */
__STATIC_INLINE uint32_t FL_DAC_IsEnabledDMAReq(DAC_Type *DACx)
{
    return (uint32_t)(READ_BIT(DACx->CR2, DAC_CR2_DMAEN_Msk) == DAC_CR2_DMAEN_Msk);
}

/**
  * @brief    Enable DAC Trigger
  * @rmtoll   CR2    TRGEN    FL_DAC_EnableTriggerMode
  * @param    DACx DAC instance
  * @retval   None
  */
__STATIC_INLINE void FL_DAC_EnableTriggerMode(DAC_Type *DACx)
{
    SET_BIT(DACx->CR2, DAC_CR2_TRGEN_Msk);
}

/**
  * @brief    Disable DAC Trigger
  * @rmtoll   CR2    TRGEN    FL_DAC_DisableTriggerMode
  * @param    DACx DAC instance
  * @retval   None
  */
__STATIC_INLINE void FL_DAC_DisableTriggerMode(DAC_Type *DACx)
{
    CLEAR_BIT(DACx->CR2, DAC_CR2_TRGEN_Msk);
}

/**
  * @brief    Get DAC Trigger  Enable Status
  * @rmtoll   CR2    TRGEN    FL_DAC_IsEnabledTriggerMode
  * @param    DACx DAC instance
  * @retval   State of bit (1 or 0).
  */
__STATIC_INLINE uint32_t FL_DAC_IsEnabledTriggerMode(DAC_Type *DACx)
{
    return (uint32_t)(READ_BIT(DACx->CR2, DAC_CR2_TRGEN_Msk) == DAC_CR2_TRGEN_Msk);
}

/**
  * @brief    Enable DAC Sample Hold
  * @rmtoll   CFGR    SHEN    FL_DAC_EnableSampleHoldMode
  * @param    DACx DAC instance
  * @retval   None
  */
__STATIC_INLINE void FL_DAC_EnableSampleHoldMode(DAC_Type *DACx)
{
    SET_BIT(DACx->CFGR, DAC_CFGR_SHEN_Msk);
}

/**
  * @brief    Disable DAC Sample Hold
  * @rmtoll   CFGR    SHEN    FL_DAC_DisableSampleHoldMode
  * @param    DACx DAC instance
  * @retval   None
  */
__STATIC_INLINE void FL_DAC_DisableSampleHoldMode(DAC_Type *DACx)
{
    CLEAR_BIT(DACx->CFGR, DAC_CFGR_SHEN_Msk);
}

/**
  * @brief    Get DAC Sample Hold  Enable Status
  * @rmtoll   CFGR    SHEN    FL_DAC_IsEnabledSampleHoldMode
  * @param    DACx DAC instance
  * @retval   State of bit (1 or 0).
  */
__STATIC_INLINE uint32_t FL_DAC_IsEnabledSampleHoldMode(DAC_Type *DACx)
{
    return (uint32_t)(READ_BIT(DACx->CFGR, DAC_CFGR_SHEN_Msk) == DAC_CFGR_SHEN_Msk);
}

/**
  * @brief    Enable DAC Output Buffer
  * @note     only DAC1
hasthis feature
  * @rmtoll   CFGR    BUFEN    FL_DAC_EnableOutputBuffer
  * @param    DACx DAC instance
  * @retval   None
  */
__STATIC_INLINE void FL_DAC_EnableOutputBuffer(DAC_Type *DACx)
{
    SET_BIT(DACx->CFGR, DAC_CFGR_BUFEN_Msk);
}

/**
  * @brief    Disable DAC Output Buffer
  * @rmtoll   CFGR    BUFEN    FL_DAC_DisableOutputBuffer
  * @param    DACx DAC instance
  * @retval   None
  */
__STATIC_INLINE void FL_DAC_DisableOutputBuffer(DAC_Type *DACx)
{
    CLEAR_BIT(DACx->CFGR, DAC_CFGR_BUFEN_Msk);
}

/**
  * @brief    Get DAC Output Buffer Status
  * @rmtoll   CFGR    BUFEN    FL_DAC_IsEnabledOutputBuffer
  * @param    DACx DAC instance
  * @retval   State of bit (1 or 0).
  */
__STATIC_INLINE uint32_t FL_DAC_IsEnabledOutputBuffer(DAC_Type *DACx)
{
    return (uint32_t)(READ_BIT(DACx->CFGR, DAC_CFGR_BUFEN_Msk) == DAC_CFGR_BUFEN_Msk);
}

/**
  * @brief    Set DAC Trigger Source
  * @note     Can Only Be Modified When TRGEN=0
  * @rmtoll   CFGR    TRGSEL    FL_DAC_SetTriggerSource
  * @param    DACx DAC instance
  * @param    source This parameter can be one of the following values:
  *           @arg @ref FL_DAC_TRGI_SOFTWARE
  *           @arg @ref FL_DAC_TRGI_ATIM0
  *           @arg @ref FL_DAC_TRGI_ATIM1
  *           @arg @ref FL_DAC_TRGI_GPTIM0
  *           @arg @ref FL_DAC_TRGI_GPTIM1
  *           @arg @ref FL_DAC_TRGI_GPTIM2
  *           @arg @ref FL_DAC_TRGI_BSTIM16
  *           @arg @ref FL_DAC_TRGI_LPTIM16
  *           @arg @ref FL_DAC_TRGI_EXTIA
  *           @arg @ref FL_DAC_TRGI_EXTIB
  *           @arg @ref FL_DAC_TRGI_EXTIC
  *           @arg @ref FL_DAC_TRGI_EXTID
  *           @arg @ref FL_DAC_TRGI_EXTIE
  *           @arg @ref FL_DAC_TRGI_EXTIF
  * @retval   None
  */
__STATIC_INLINE void FL_DAC_SetTriggerSource(DAC_Type *DACx, uint32_t source)
{
    MODIFY_REG(DACx->CFGR, DAC_CFGR_TRGSEL_Msk, source);
}

/**
  * @brief    Get DAC Trigger Source
  * @rmtoll   CFGR    TRGSEL    FL_DAC_GetTriggerSource
  * @param    DACx DAC instance
  * @retval   Returned value can be one of the following values:
  *           @arg @ref FL_DAC_TRGI_SOFTWARE
  *           @arg @ref FL_DAC_TRGI_ATIM0
  *           @arg @ref FL_DAC_TRGI_ATIM1
  *           @arg @ref FL_DAC_TRGI_GPTIM0
  *           @arg @ref FL_DAC_TRGI_GPTIM1
  *           @arg @ref FL_DAC_TRGI_GPTIM2
  *           @arg @ref FL_DAC_TRGI_BSTIM16
  *           @arg @ref FL_DAC_TRGI_LPTIM16
  *           @arg @ref FL_DAC_TRGI_EXTIA
  *           @arg @ref FL_DAC_TRGI_EXTIB
  *           @arg @ref FL_DAC_TRGI_EXTIC
  *           @arg @ref FL_DAC_TRGI_EXTID
  *           @arg @ref FL_DAC_TRGI_EXTIE
  *           @arg @ref FL_DAC_TRGI_EXTIF
  */
__STATIC_INLINE uint32_t FL_DAC_GetTriggerSource(DAC_Type *DACx)
{
    return (uint32_t)(READ_BIT(DACx->CFGR, DAC_CFGR_TRGSEL_Msk));
}

/**
  * @brief    Enable DAC Output Switch
  * @rmtoll   CFGR    SWIEN    FL_DAC_EnableOutputSwitch
  * @param    DACx DAC instance
  * @retval   None
  */
__STATIC_INLINE void FL_DAC_EnableOutputSwitch(DAC_Type *DACx)
{
    SET_BIT(DACx->CFGR, DAC_CFGR_SWIEN_Msk);
}

/**
  * @brief    Disable DAC Output
  * @rmtoll   CFGR    SWIEN    FL_DAC_DisableOutputSwitch
  * @param    DACx DAC instance
  * @retval   None
  */
__STATIC_INLINE void FL_DAC_DisableOutputSwitch(DAC_Type *DACx)
{
    CLEAR_BIT(DACx->CFGR, DAC_CFGR_SWIEN_Msk);
}

/**
  * @brief    Get DAC Output  Switch
  * @rmtoll   CFGR    SWIEN    FL_DAC_IsEnabledOutputSwitch
  * @param    DACx DAC instance
  * @retval   State of bit (1 or 0).
  */
__STATIC_INLINE uint32_t FL_DAC_IsEnabledOutputSwitch(DAC_Type *DACx)
{
    return (uint32_t)(READ_BIT(DACx->CFGR, DAC_CFGR_SWIEN_Msk) == DAC_CFGR_SWIEN_Msk);
}

/**
  * @brief    Trigger DAC
  * @rmtoll   SWTRGR    SWTRIG    FL_DAC_EnableSoftwareTrigger
  * @param    DACx DAC instance
  * @retval   None
  */
__STATIC_INLINE void FL_DAC_EnableSoftwareTrigger(DAC_Type *DACx)
{
    SET_BIT(DACx->SWTRGR, DAC_SWTRGR_SWTRIG_Msk);
}

/**
  * @brief    Write DAC Data
  * @rmtoll   DHR    DHR    FL_DAC_WriteData
  * @param    DACx DAC instance
  * @param    data
  * @retval   None
  */
__STATIC_INLINE void FL_DAC_WriteData(DAC_Type *DACx, uint32_t data)
{
    MODIFY_REG(DACx->DHR, (0xfffU << 0U), (data << 0U));
}
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
