rEDTii/EATWHAT/(commit log)

2026-03-07 更新答辩演示文稿
2026-03-07 增加总决赛现场演示视频
2026-03-07 Update README.md
    增加项目介绍
