rEDTii/EATWHAT/(notices)

Notices in the files:
Drivers/FM33FK5xx_FL_Driver/Inc/fm33fk5xx_fl_adc.h:
Copyright (c) [2019] [Fudan Microelectronics]
THIS SOFTWARE is licensed under the Mulan PSL v1.
Drivers/FM33FK5xx_FL_Driver/Src/fm33fk5xx_fl_epwm.c:
Copyright (c) [2021] [Fudan Microelectronics]
THIS SOFTWARE is licensed under Mulan PSL v2.
